theodote/Senior-Project/figs/altium.png

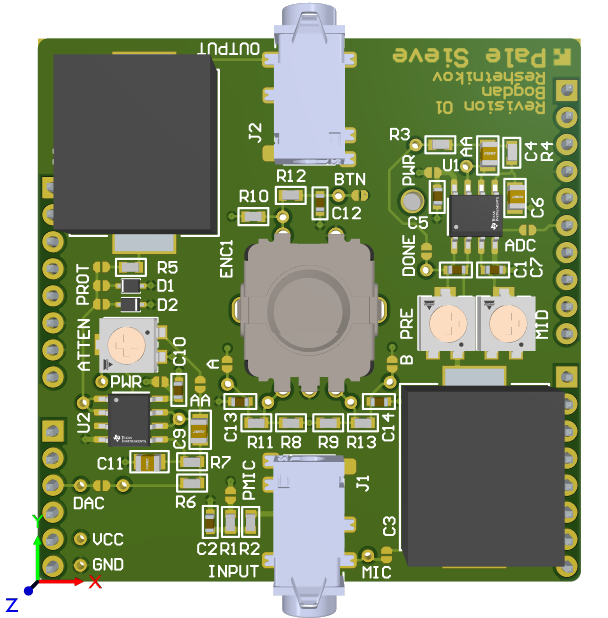
figs/altium.png
