theodote/Senior-Project/figs/audio-pipeline.png

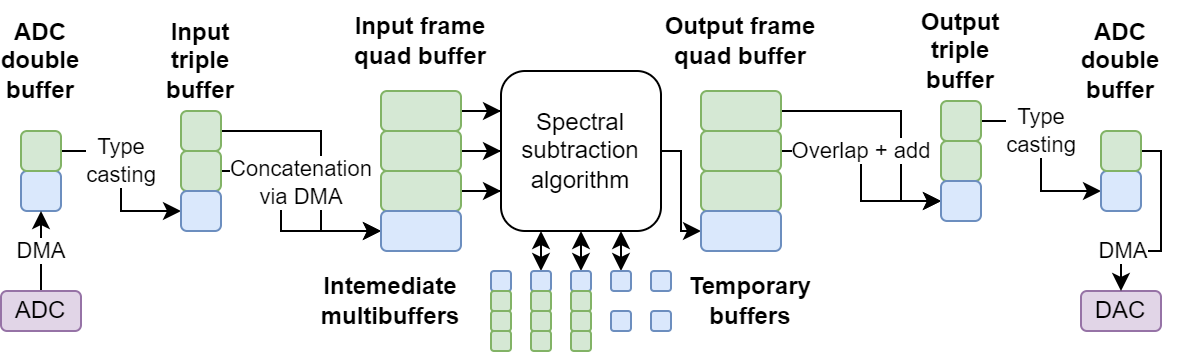
figs/audio-pipeline.png
