theodote/Senior-Project/figs/backside.jpg

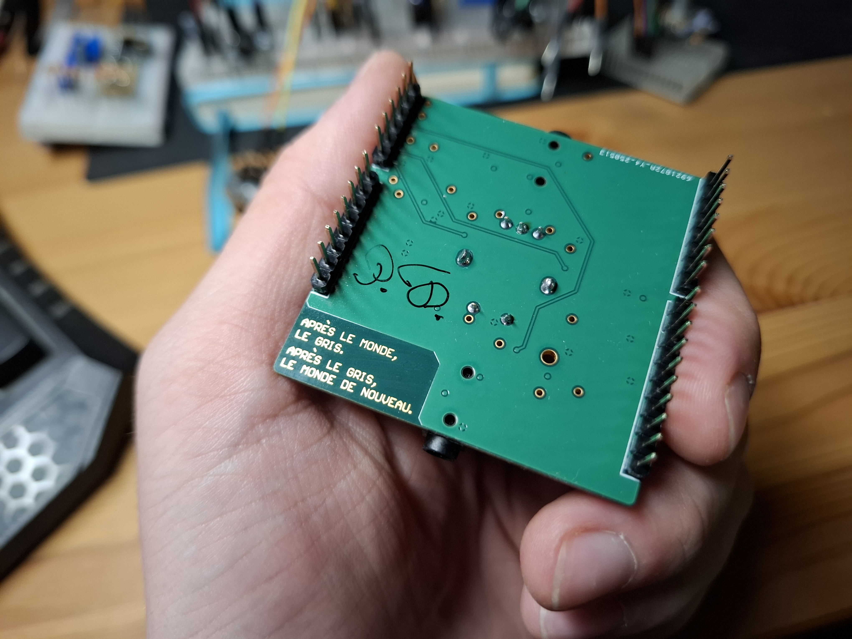
figs/backside.jpg
