theodote/Senior-Project/figs/board.jpg

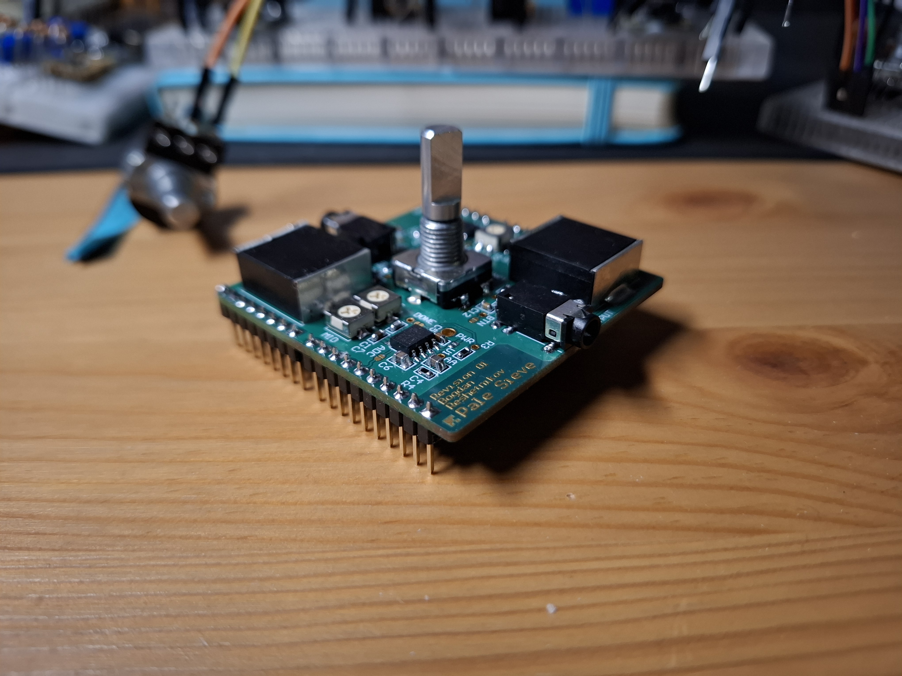
figs/board.jpg
