theodote/Senior-Project/figs/bridge.png

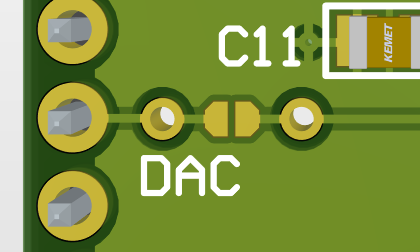
figs/bridge.png
