theodote/Senior-Project/figs/buzz-anatomy.png

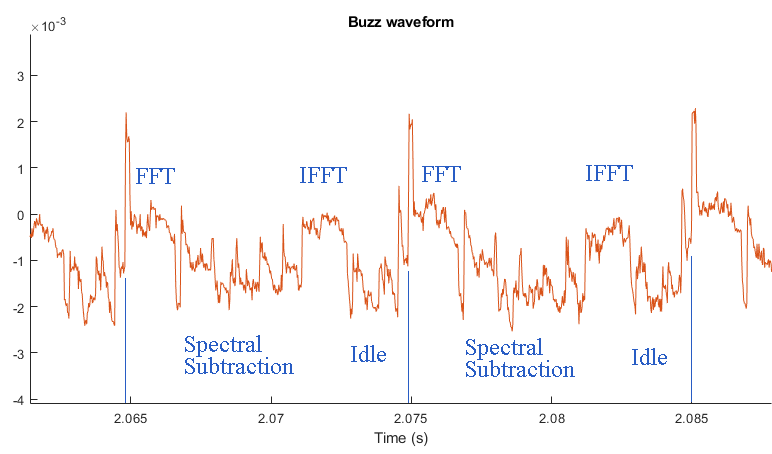
figs/buzz-anatomy.png
