theodote/Senior-Project/figs/buzz-waveform.png

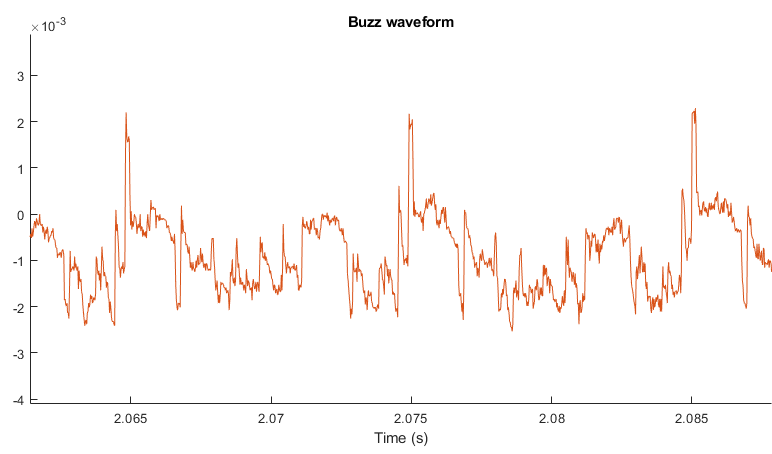
figs/buzz-waveform.png
