theodote/Senior-Project/figs/buzz.png

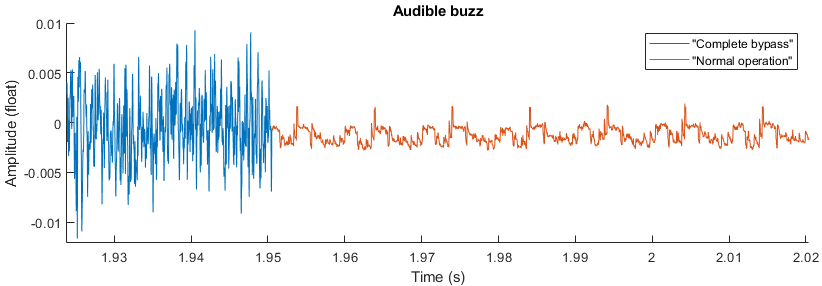
figs/buzz.png
