theodote/Senior-Project/figs/cfg/adc.png

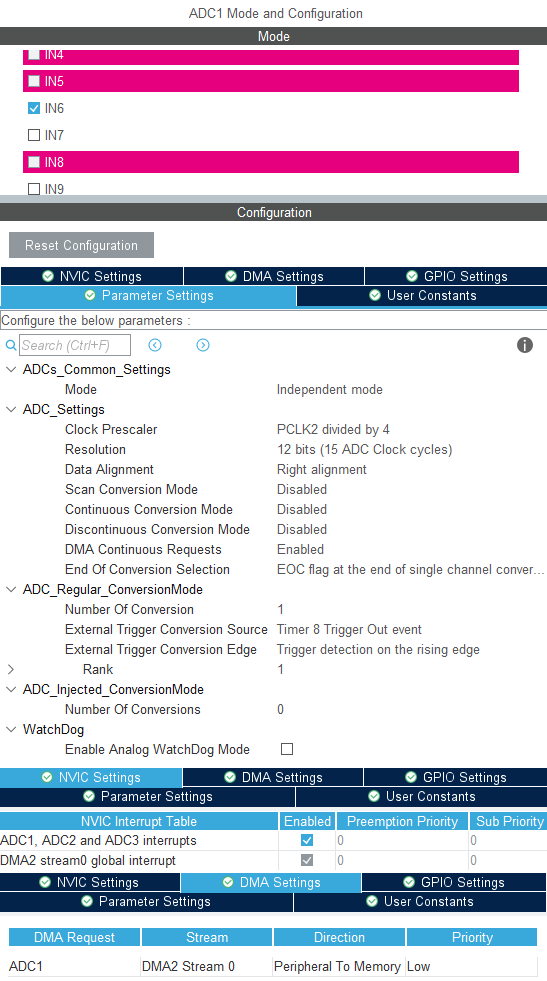
figs/cfg/adc.png
