theodote/Senior-Project/figs/cfg/clock.png

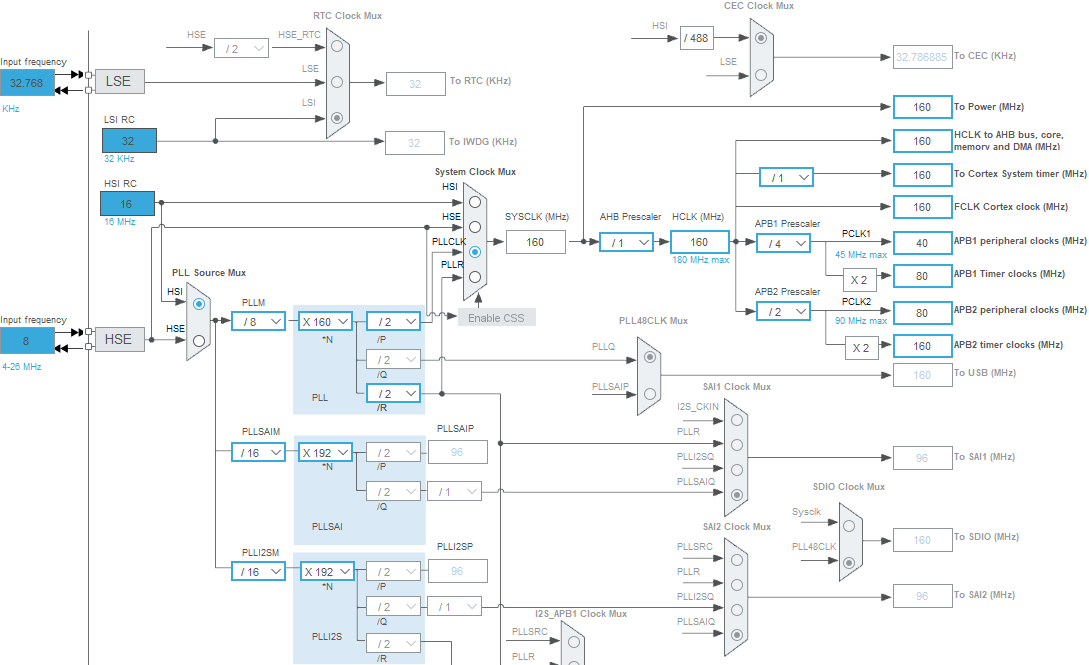
figs/cfg/clock.png
