theodote/Senior-Project/figs/cfg/dac.png

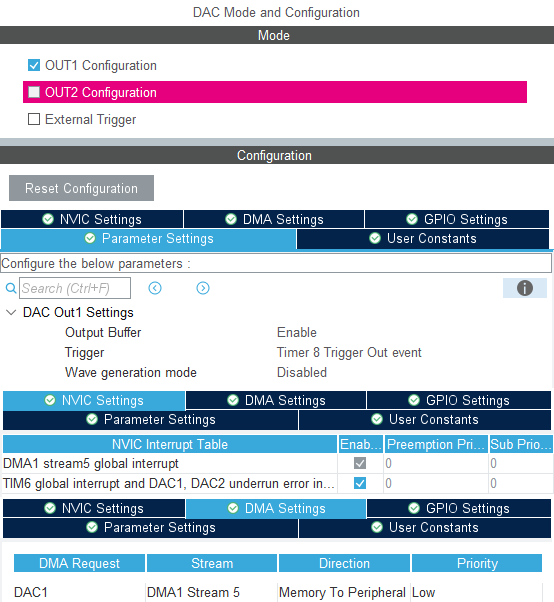
figs/cfg/dac.png
