theodote/Senior-Project/figs/cfg/dma.png

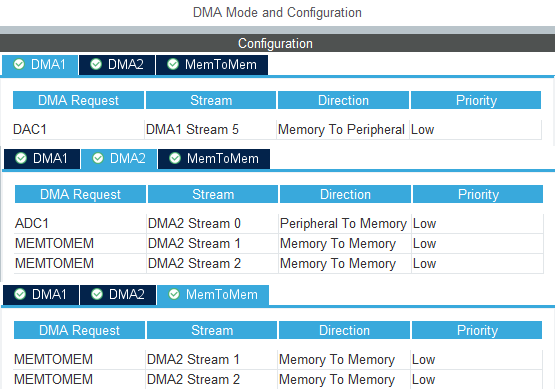
figs/cfg/dma.png
