theodote/Senior-Project/figs/cfg/gpio.png

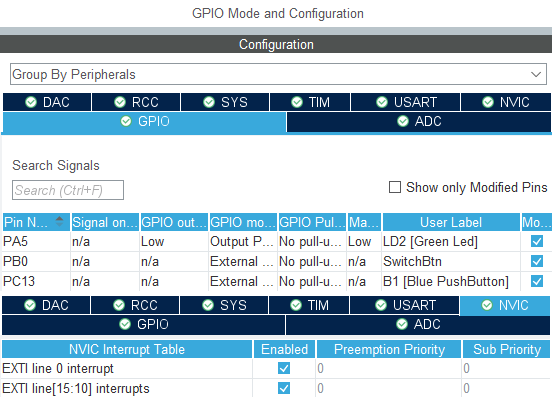
figs/cfg/gpio.png
