theodote/Senior-Project/figs/cfg/nvic.png

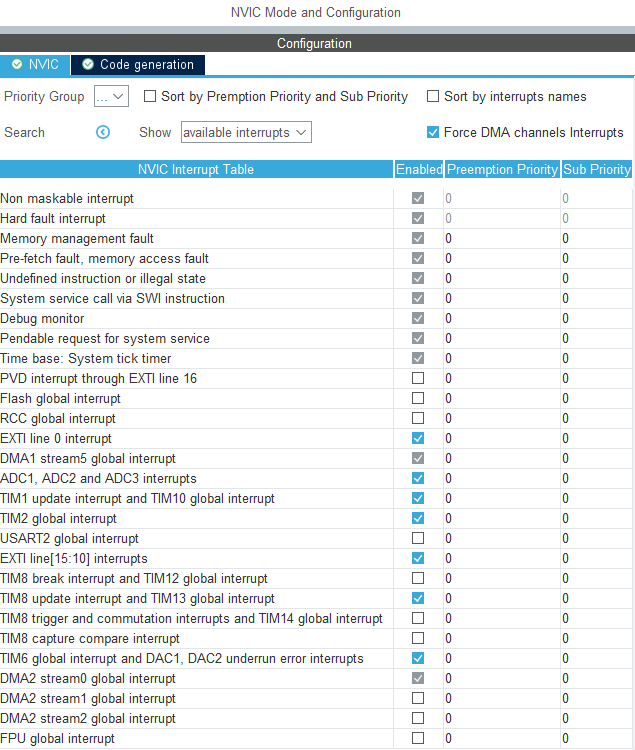
figs/cfg/nvic.png
