theodote/Senior-Project/figs/cfg/pinout.png

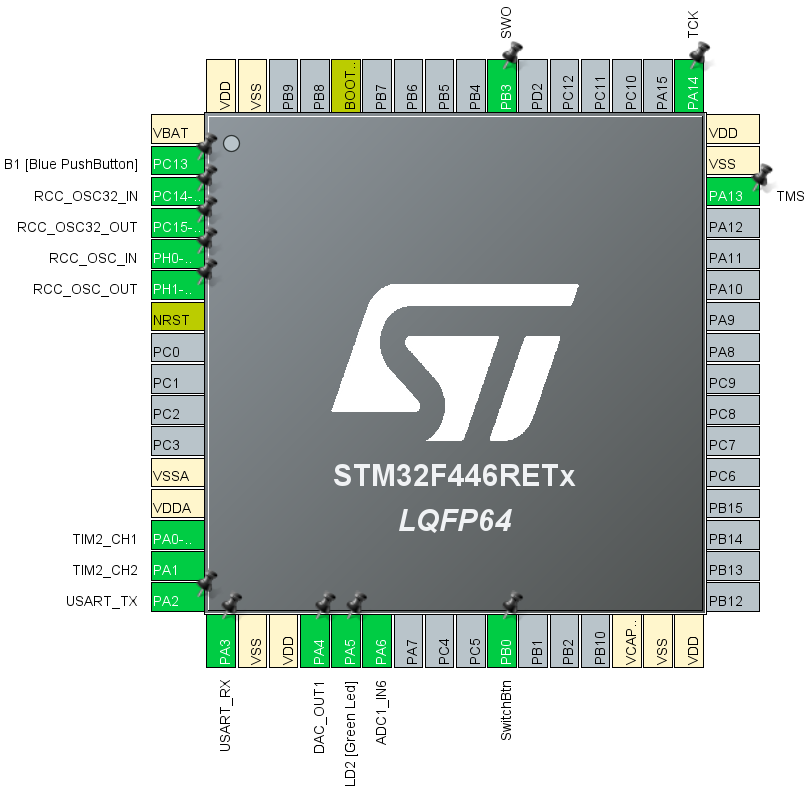
figs/cfg/pinout.png
