theodote/Senior-Project/figs/cfg/rcc.png

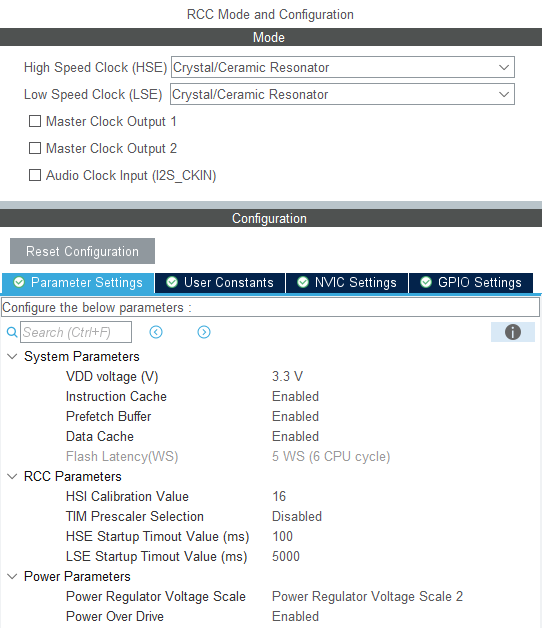
figs/cfg/rcc.png
