theodote/Senior-Project/figs/cfg/tim2.png

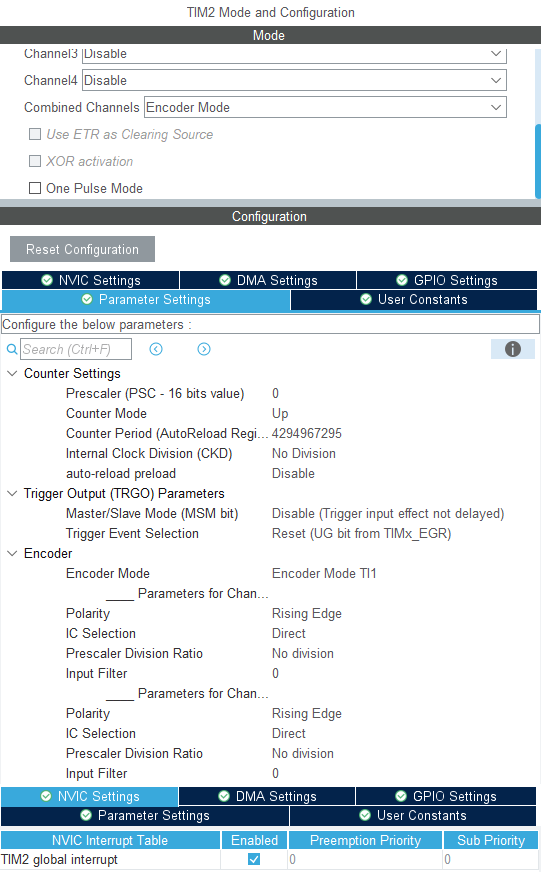
figs/cfg/tim2.png
