theodote/Senior-Project/figs/cfg/tim8.png

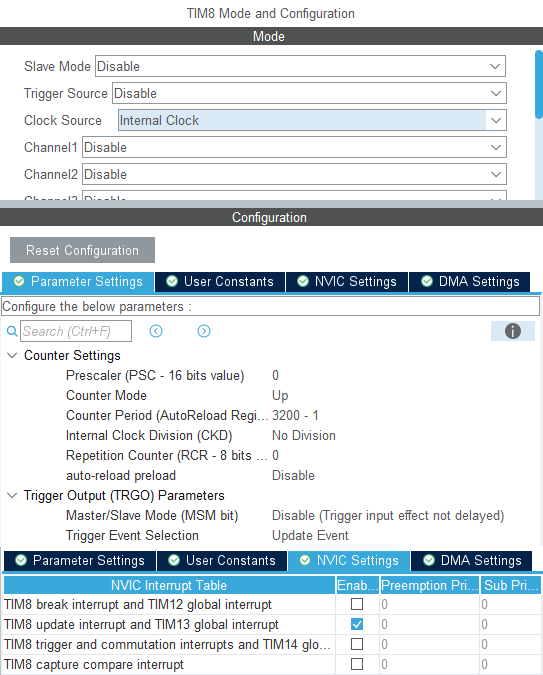
figs/cfg/tim8.png
