theodote/Senior-Project/figs/cfg/tim10.png

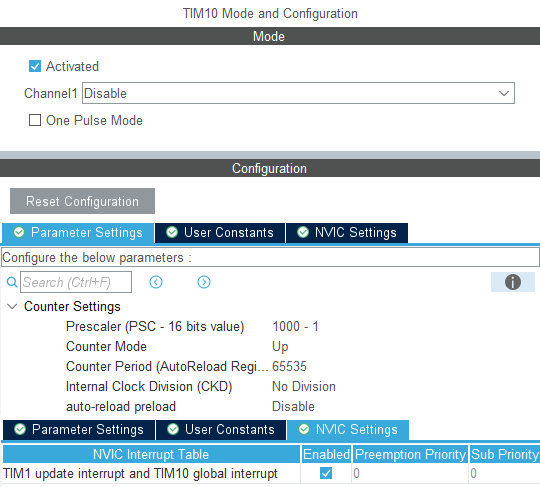
figs/cfg/tim10.png
