theodote/Senior-Project/figs/dfrobot.png

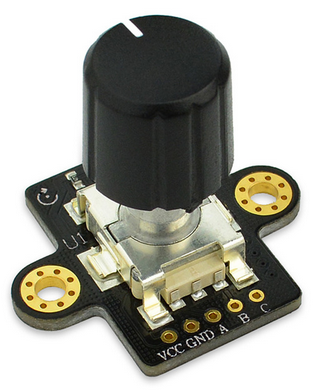
figs/dfrobot.png
