theodote/Senior-Project/figs/diodes.png

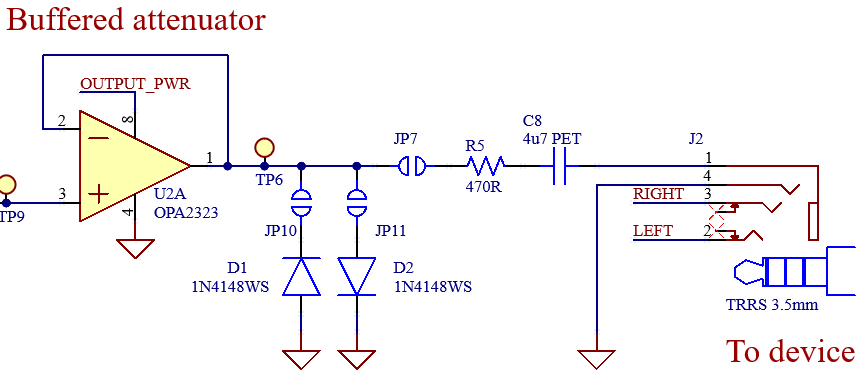
figs/diodes.png
