theodote/Senior-Project/figs/double-buffers.png

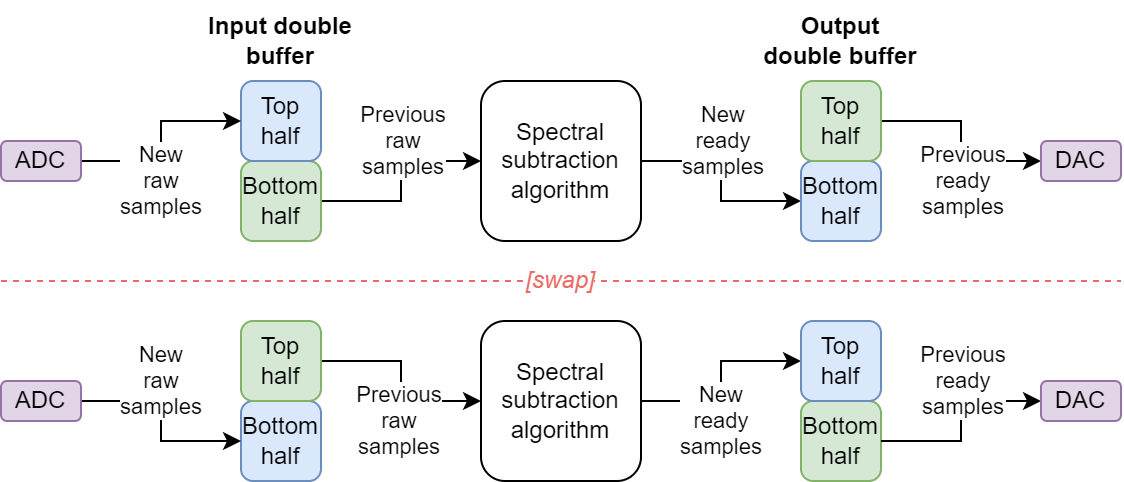
figs/double-buffers.png
