theodote/Senior-Project/figs/encoder-cct.png

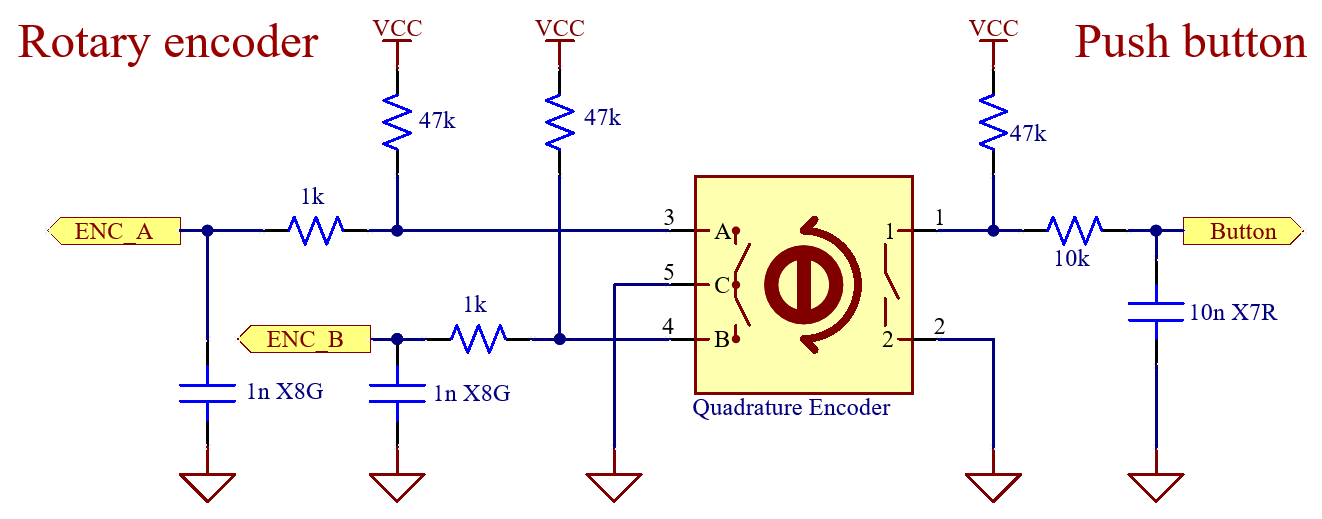
figs/encoder-cct.png
