theodote/Senior-Project/figs/fft-time.png

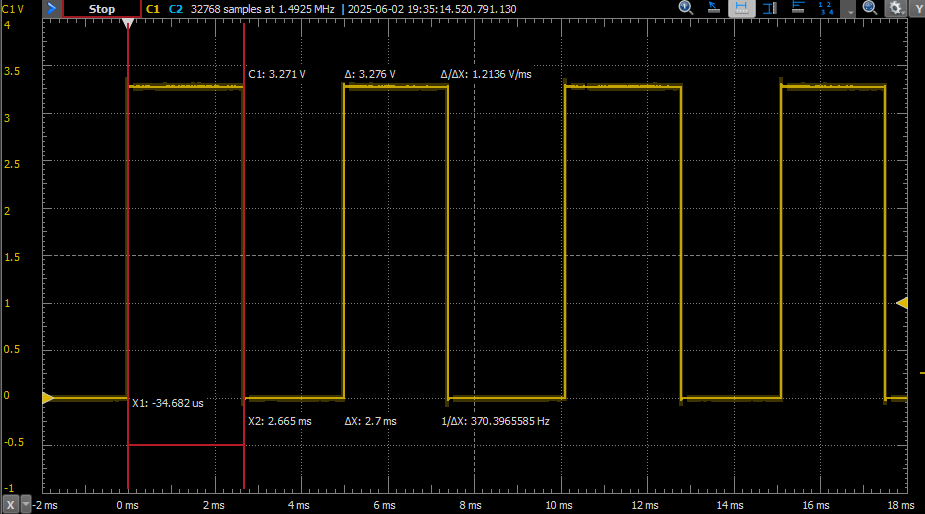
figs/fft-time.png
