theodote/Senior-Project/figs/final-demo.png

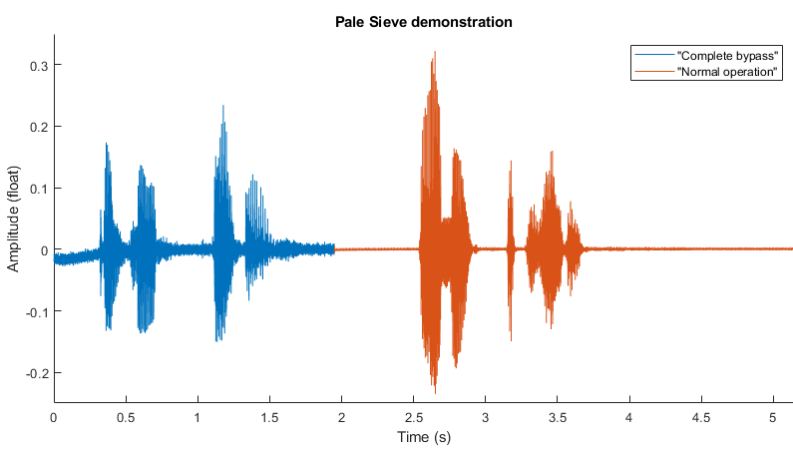
figs/final-demo.png
