theodote/Senior-Project/figs/final-noiseless.png

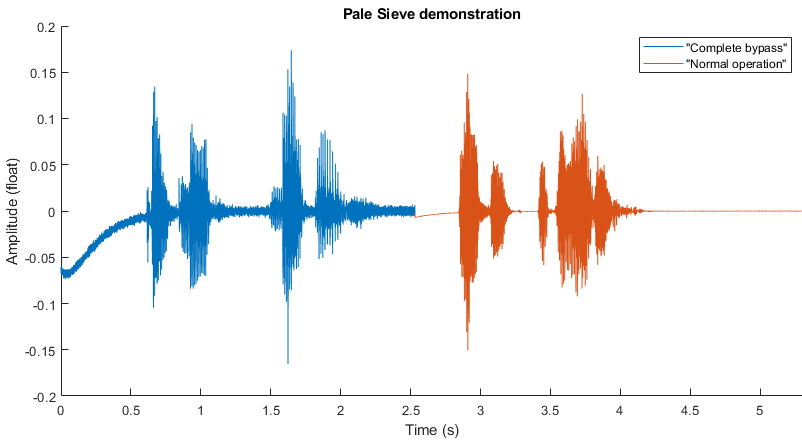
figs/final-noiseless.png
