theodote/Senior-Project/figs/ground-loop.png

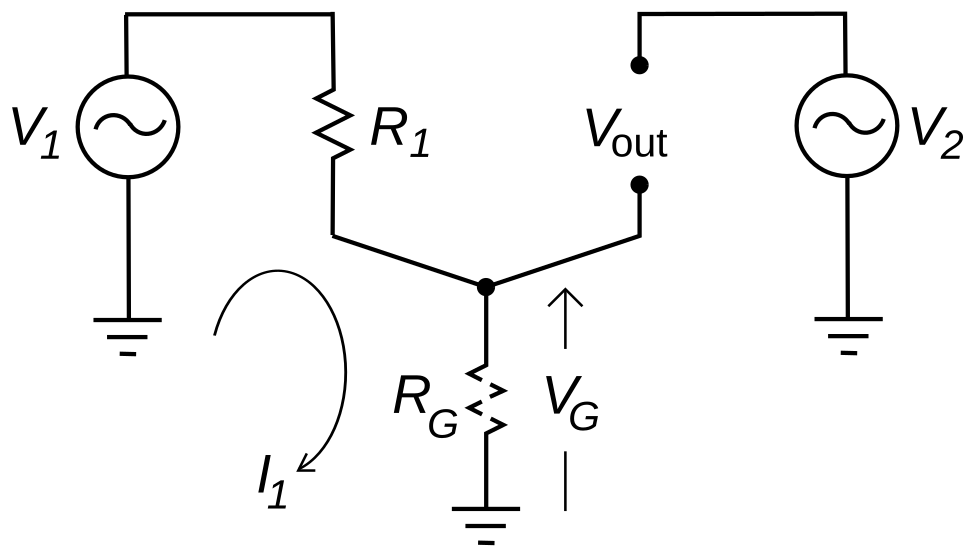
figs/ground-loop.png
