theodote/Senior-Project/figs/high-level-design.png

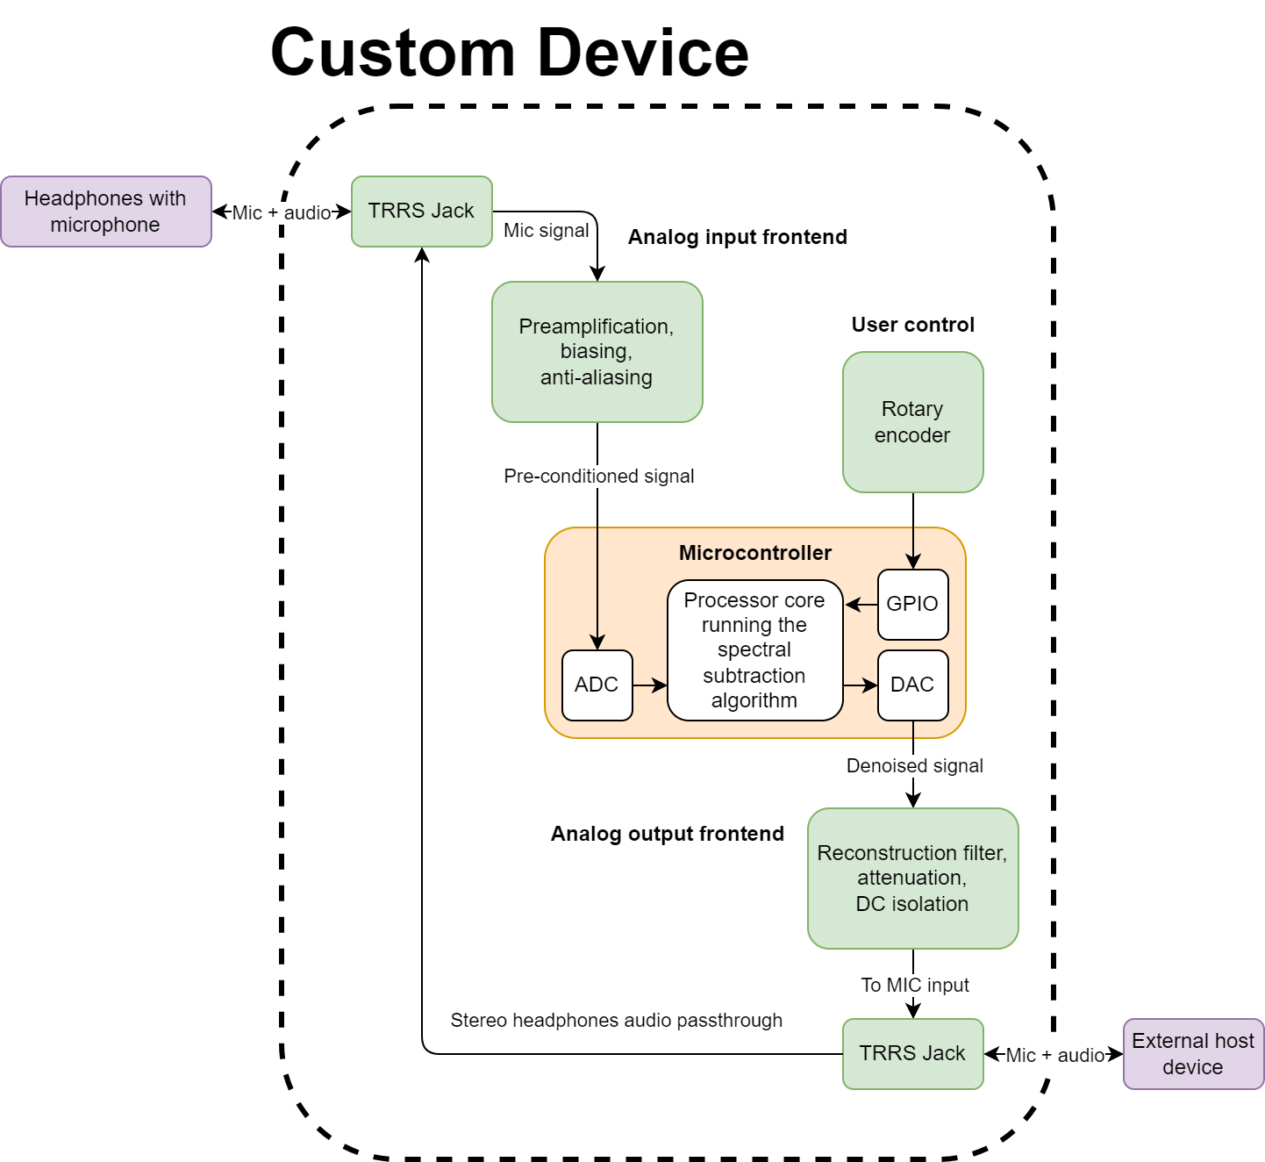
figs/high-level-design.png
