theodote/Senior-Project/figs/indata-compare.png

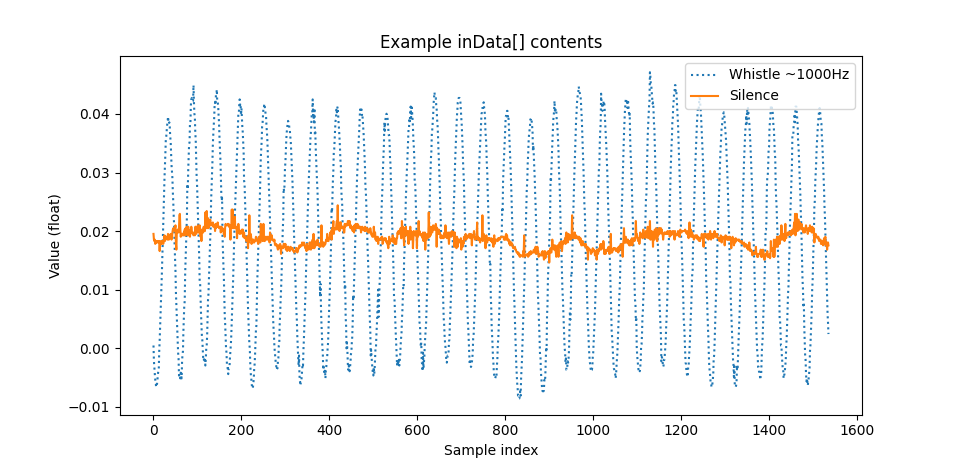
figs/indata-compare.png
