theodote/Senior-Project/figs/indata-empty.png

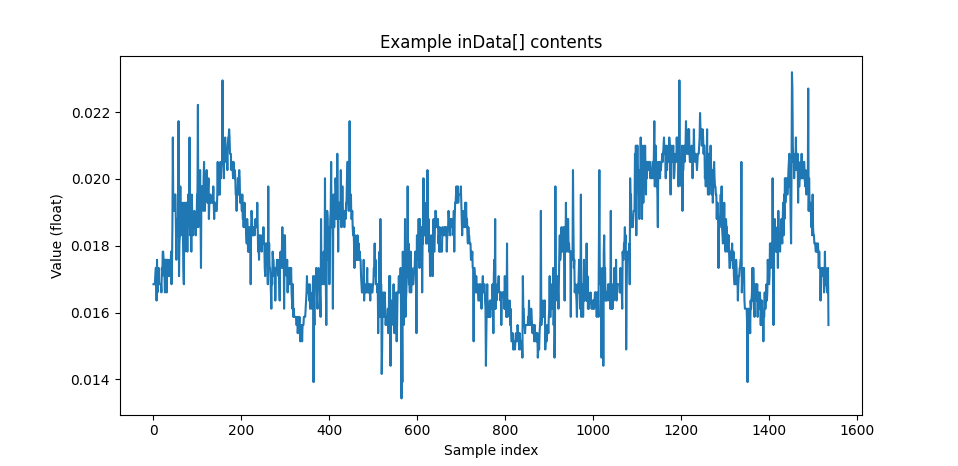
figs/indata-empty.png
