theodote/Senior-Project/figs/indata.png

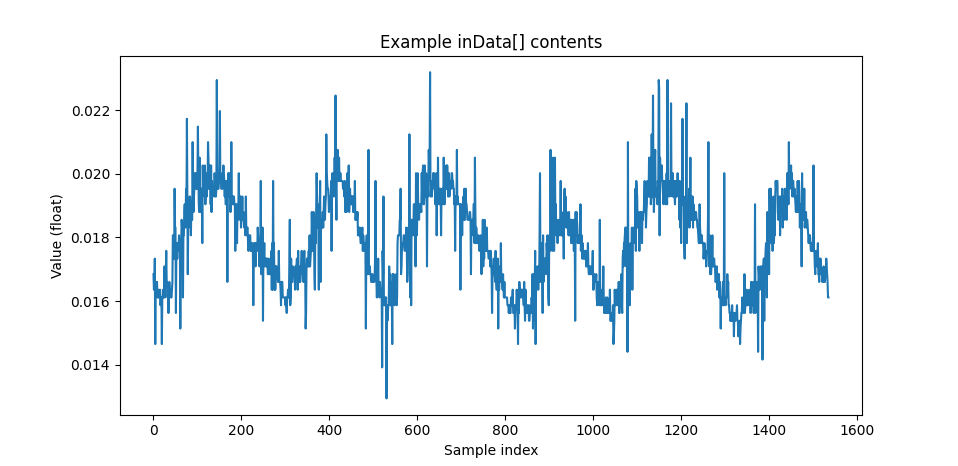
figs/indata.png
