theodote/Senior-Project/figs/indicator.jpg

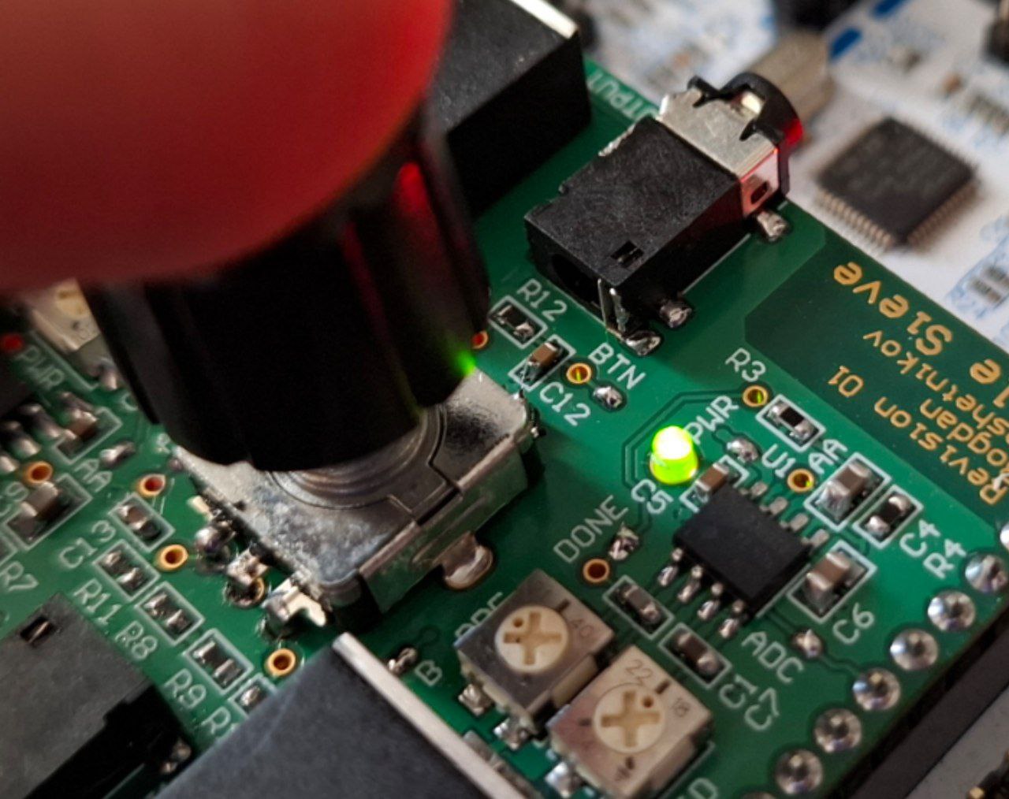
figs/indicator.jpg
