theodote/Senior-Project/figs/input-cct.png

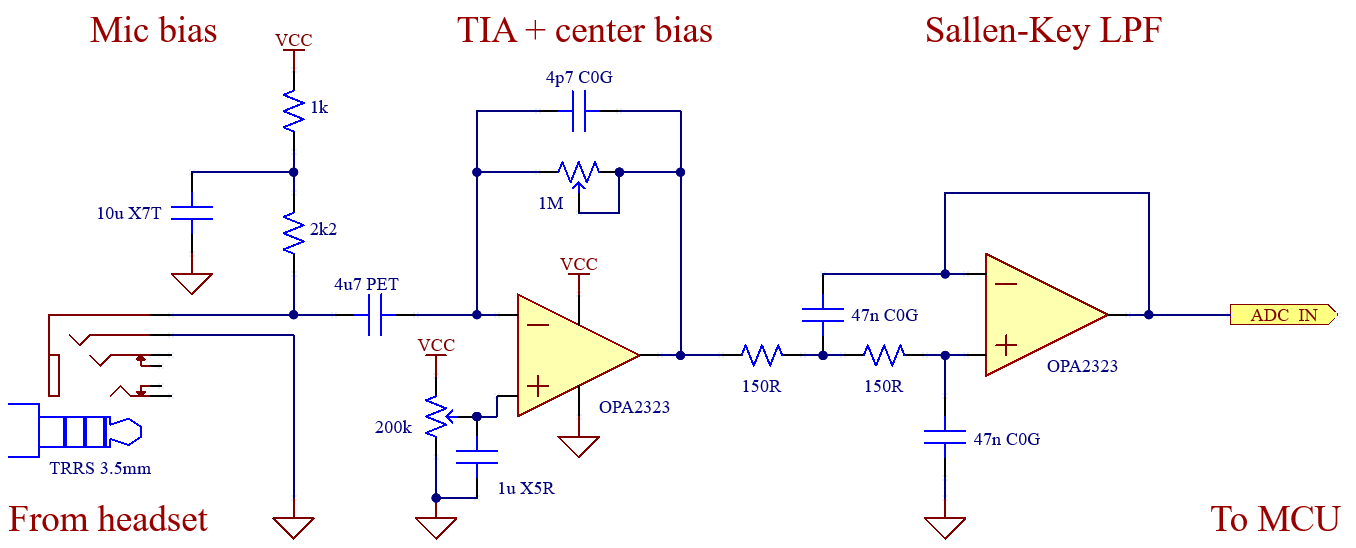
figs/input-cct.png
