theodote/Senior-Project/figs/input-frontend.png

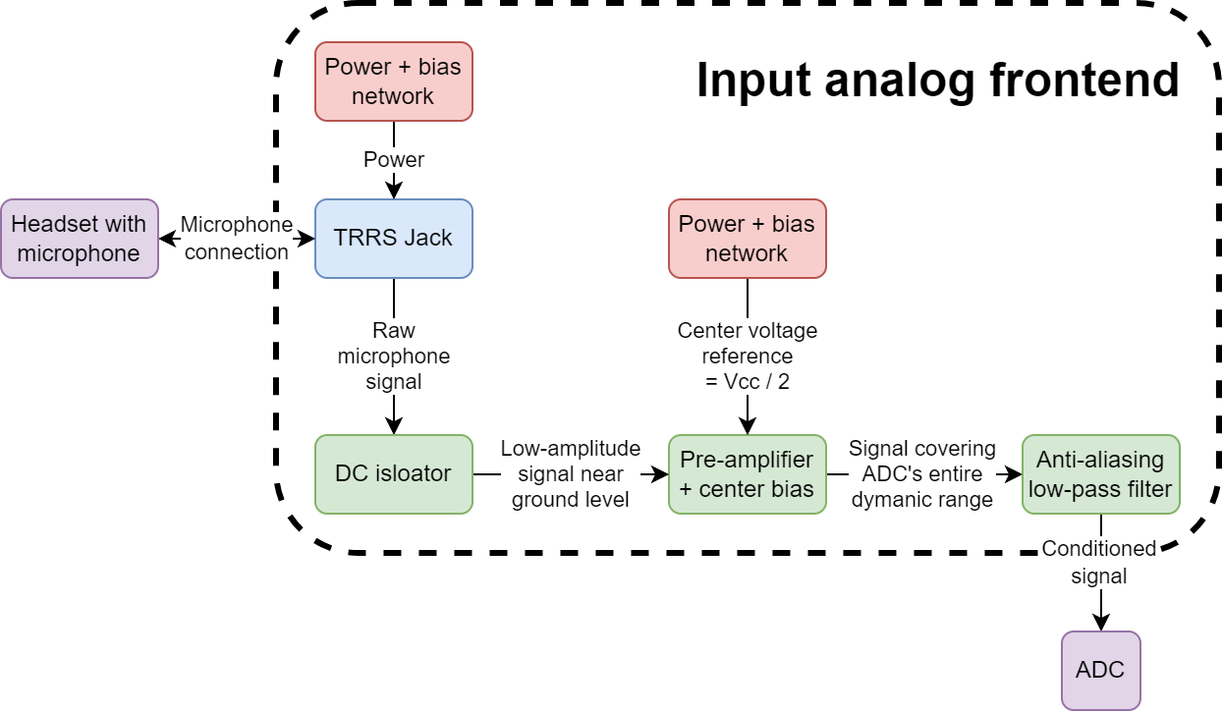
figs/input-frontend.png
