theodote/Senior-Project/figs/matlab.png

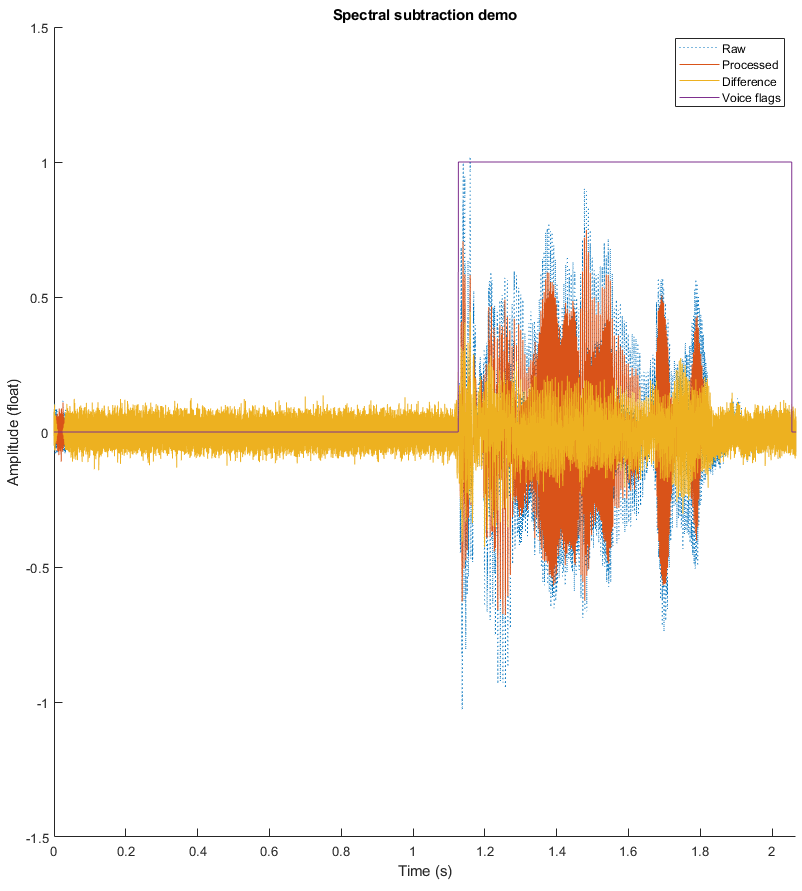
figs/matlab.png
