theodote/Senior-Project/figs/mcu-board.png

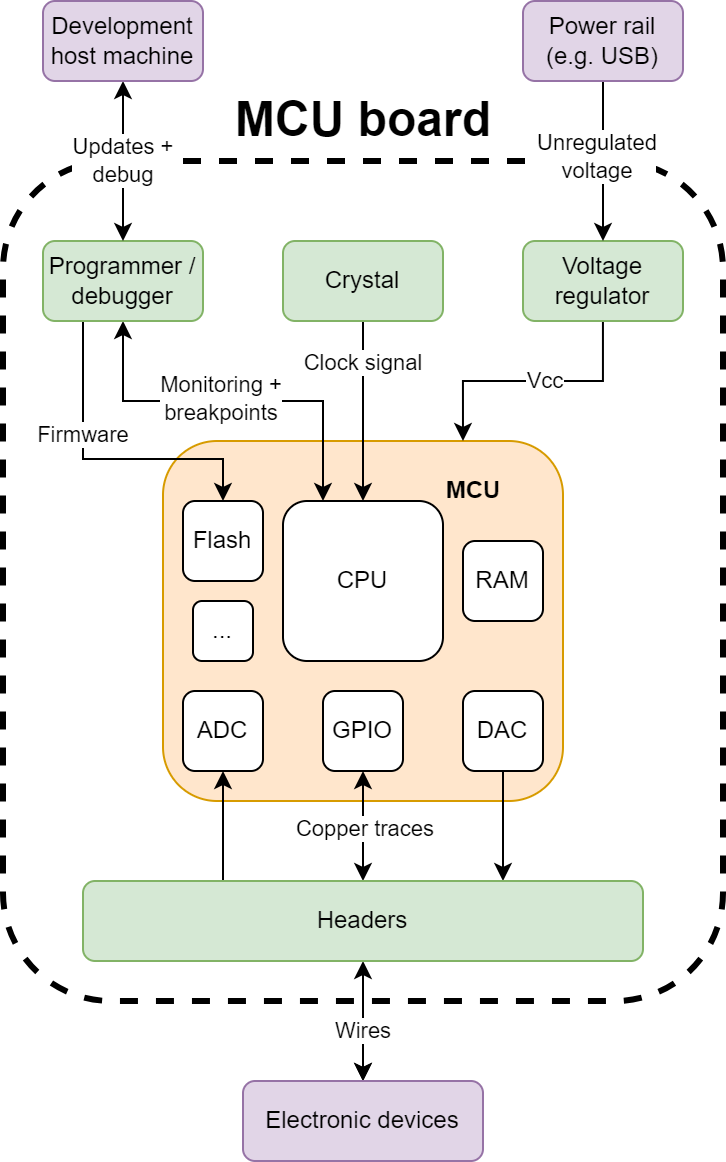
figs/mcu-board.png
