theodote/Senior-Project/figs/multibuffer.png

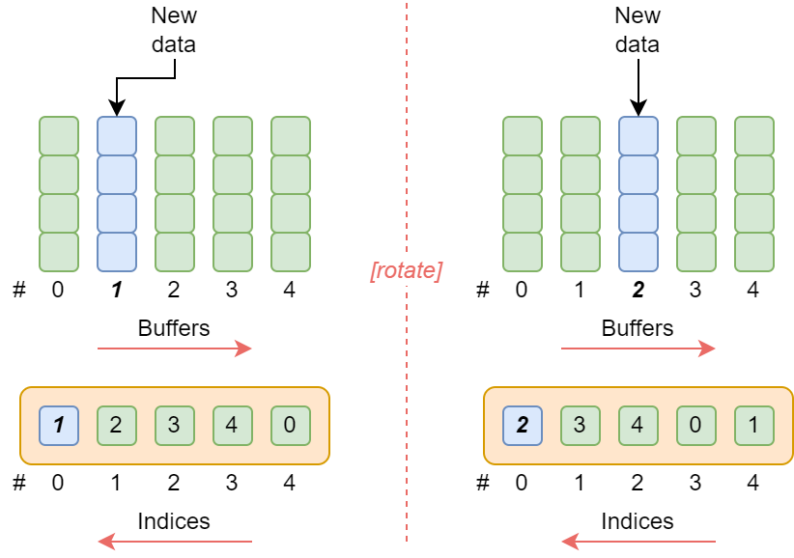
figs/multibuffer.png
