theodote/Senior-Project/figs/nucleo.png

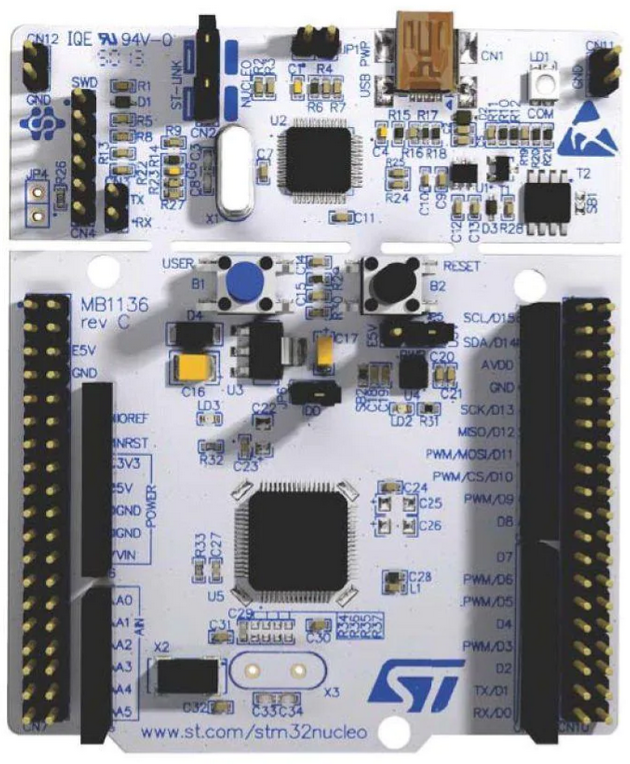
figs/nucleo.png
