theodote/Senior-Project/figs/output-cct.png

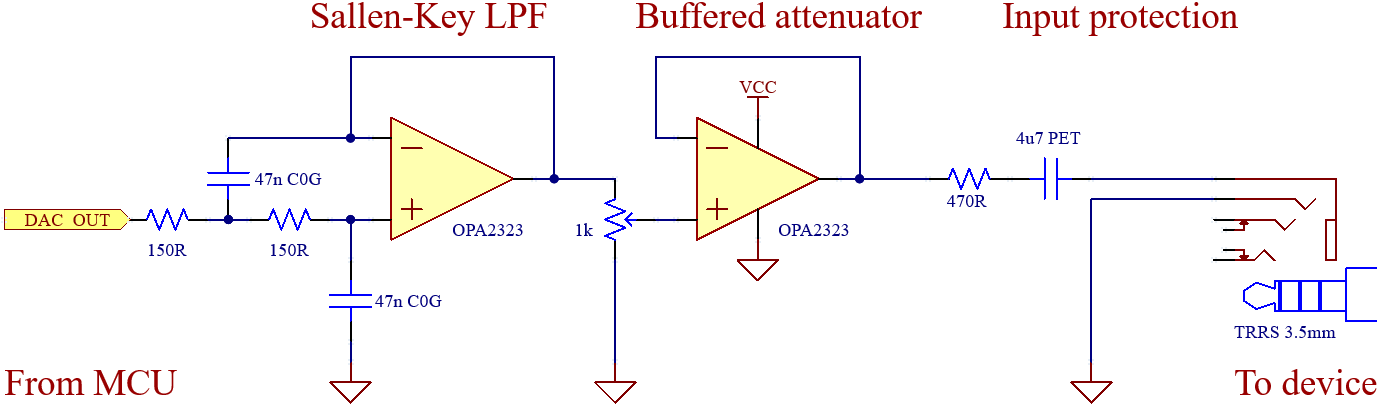
figs/output-cct.png
