theodote/Senior-Project/figs/output-frontend.png

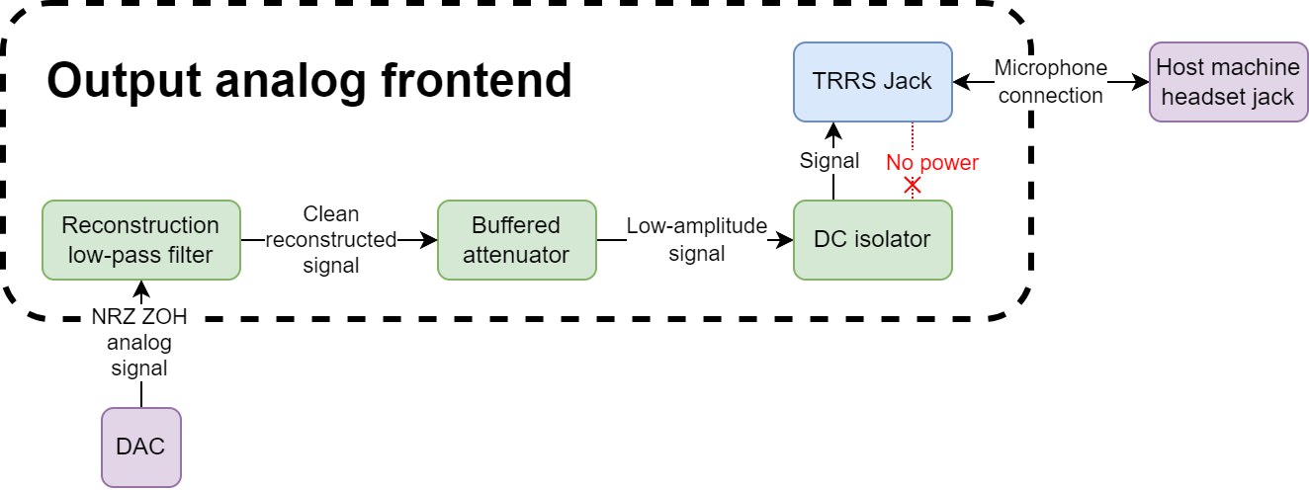
figs/output-frontend.png
