theodote/Senior-Project/figs/pcb.png

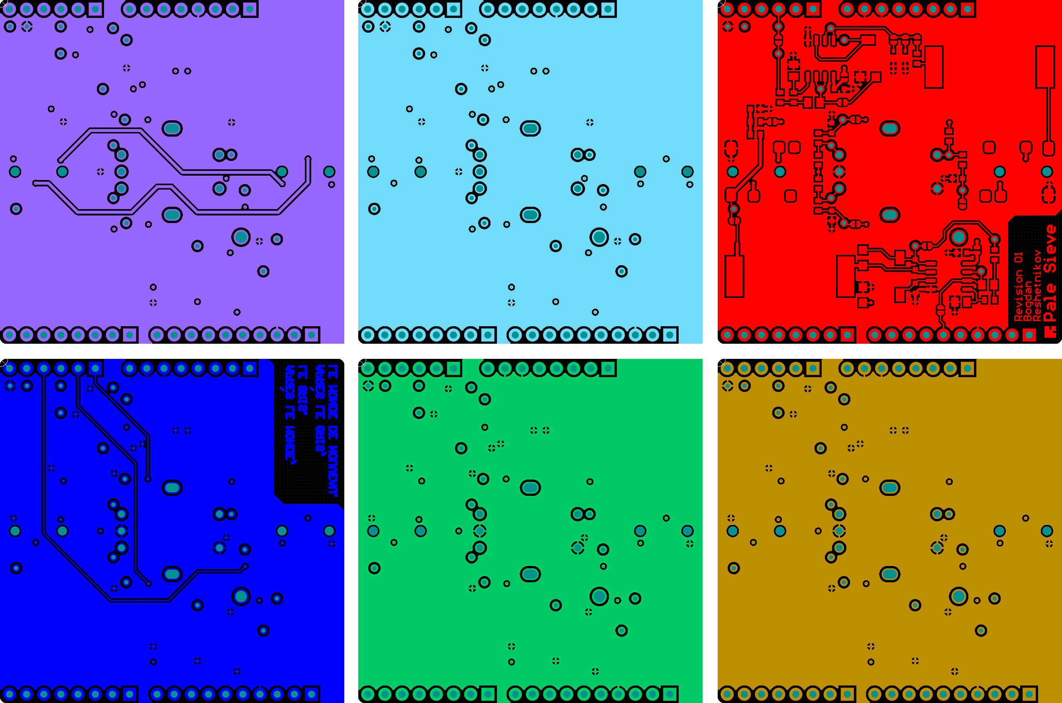
figs/pcb.png
