theodote/Senior-Project/figs/pipe.jpg

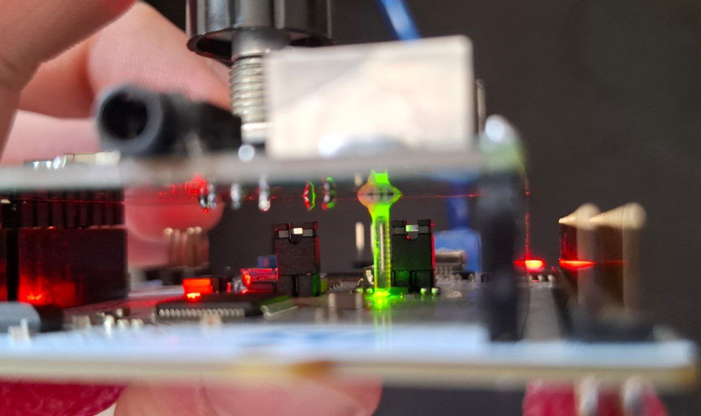
figs/pipe.jpg
