theodote/Senior-Project/figs/quadrature-encoder.png

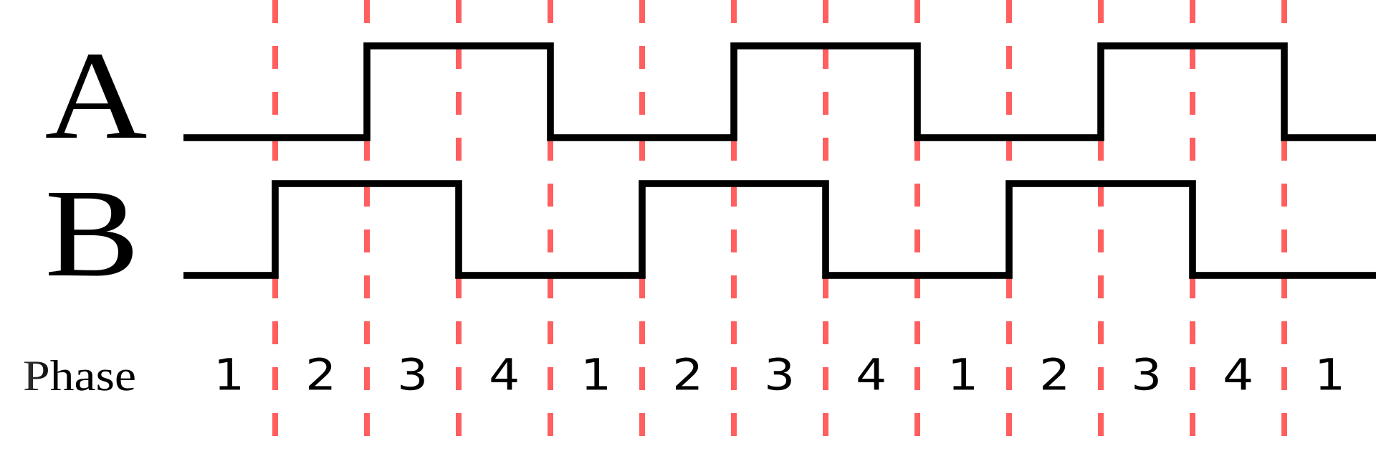
figs/quadrature-encoder.png
