theodote/Senior-Project/figs/rig.jpg

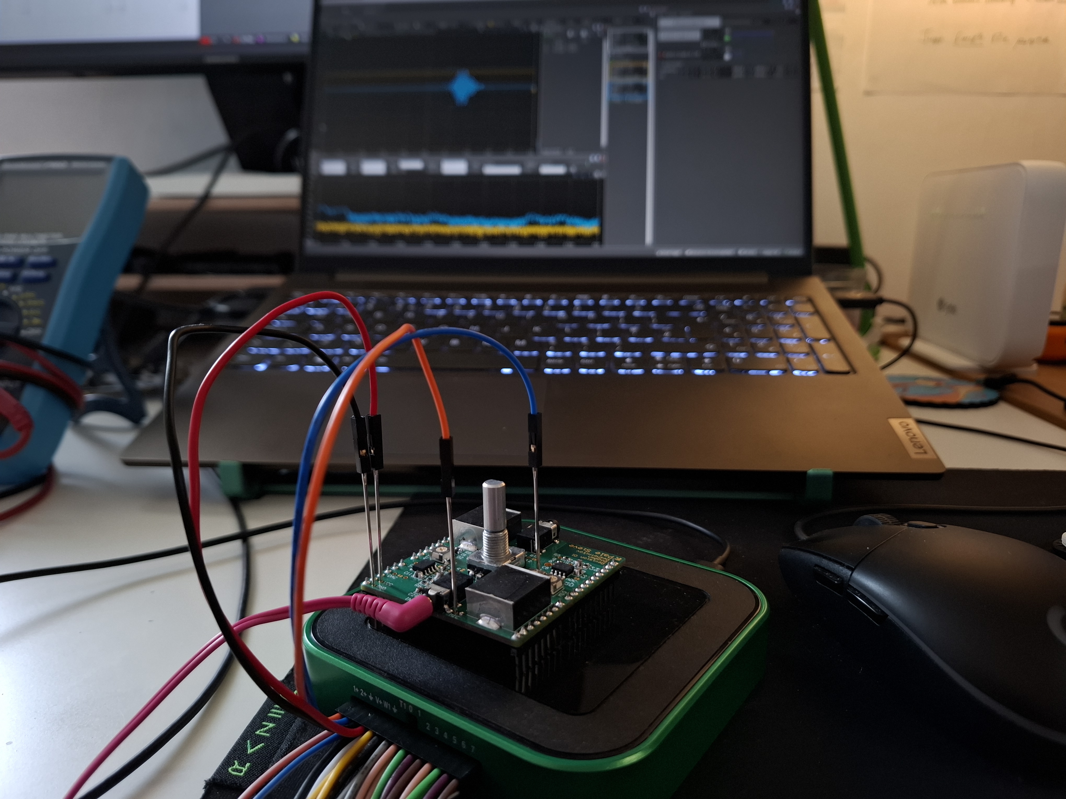
figs/rig.jpg
