theodote/Senior-Project/figs/rotary-encoder.png

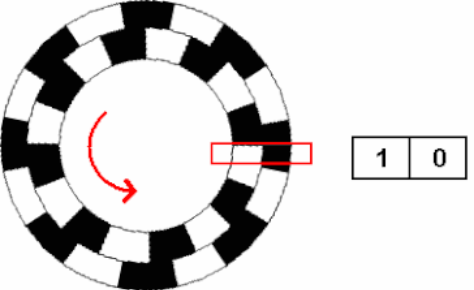
figs/rotary-encoder.png
