theodote/Senior-Project/figs/sallenkeylpf.png

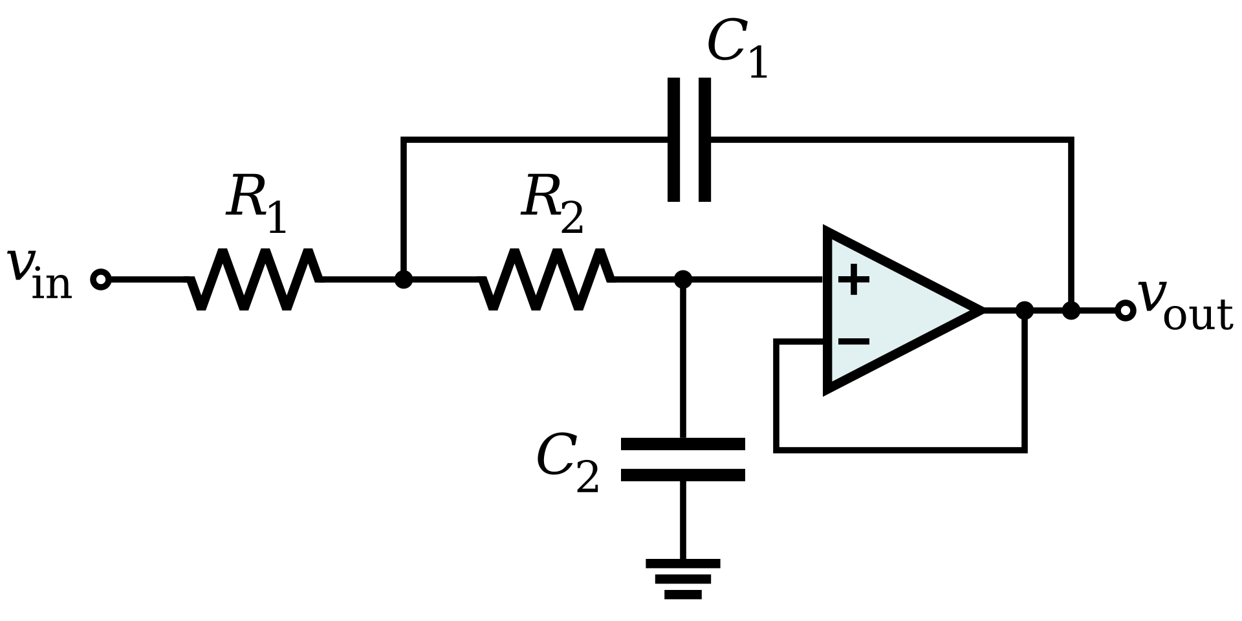
figs/sallenkeylpf.png
