theodote/Senior-Project/figs/sandwich.jpg

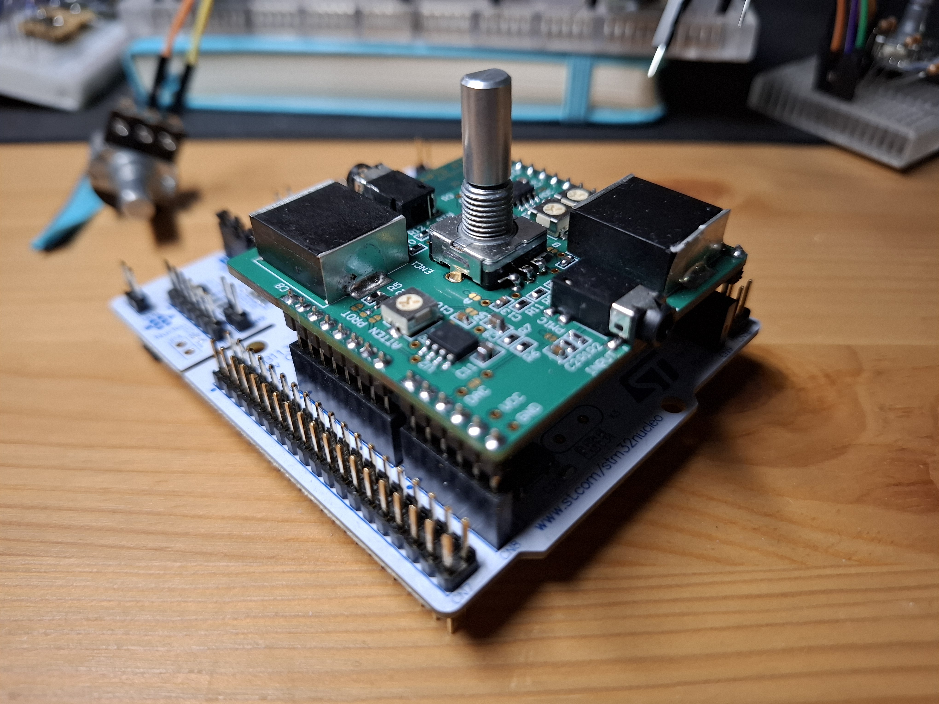
figs/sandwich.jpg
