theodote/Senior-Project/figs/sieve3d.png

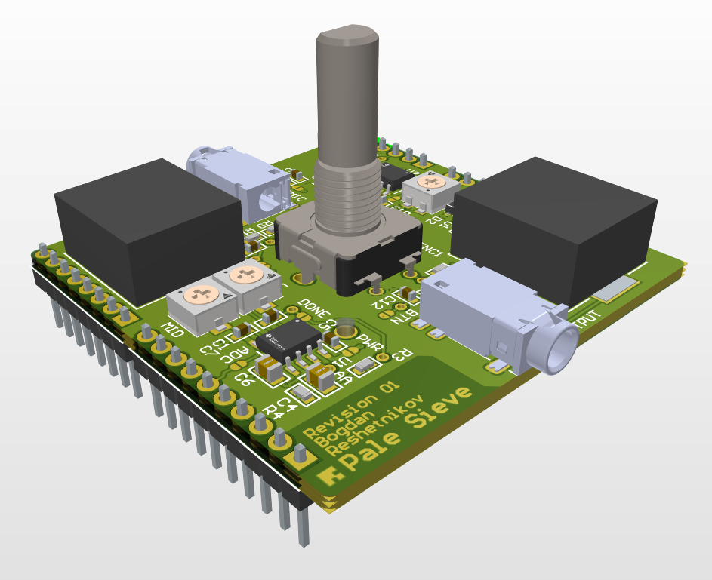
figs/sieve3d.png
