theodote/Senior-Project/figs/sparkfun.png

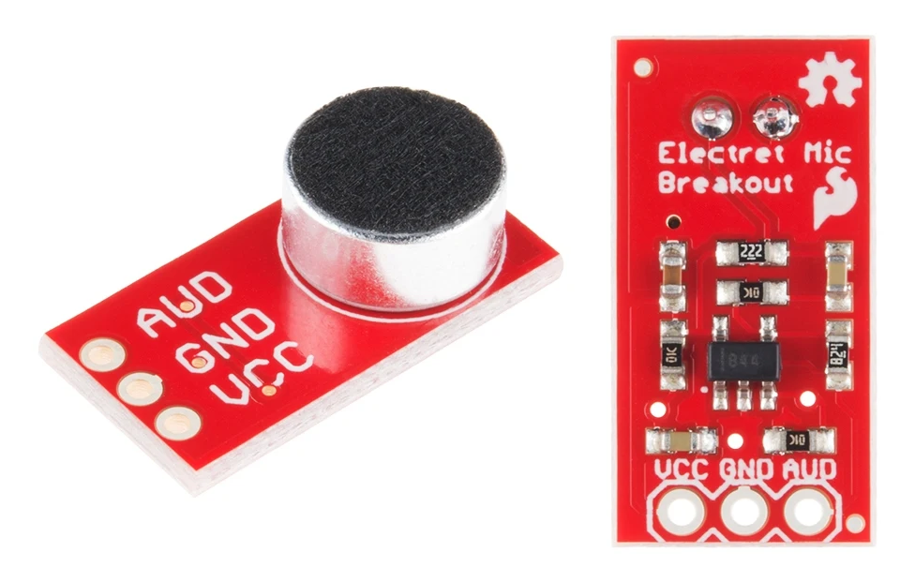
figs/sparkfun.png
