theodote/Senior-Project/figs/specsub-time.png

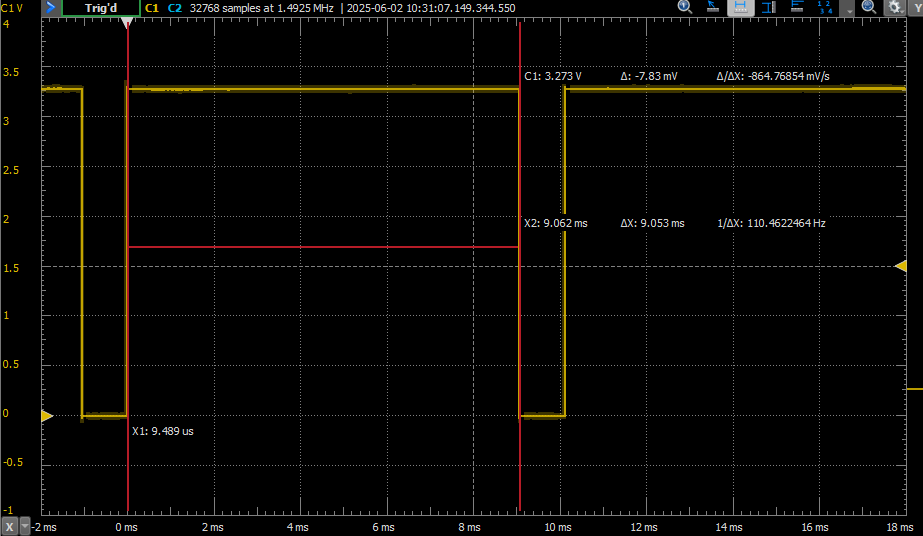
figs/specsub-time.png
