theodote/Senior-Project/figs/spectrogram.png

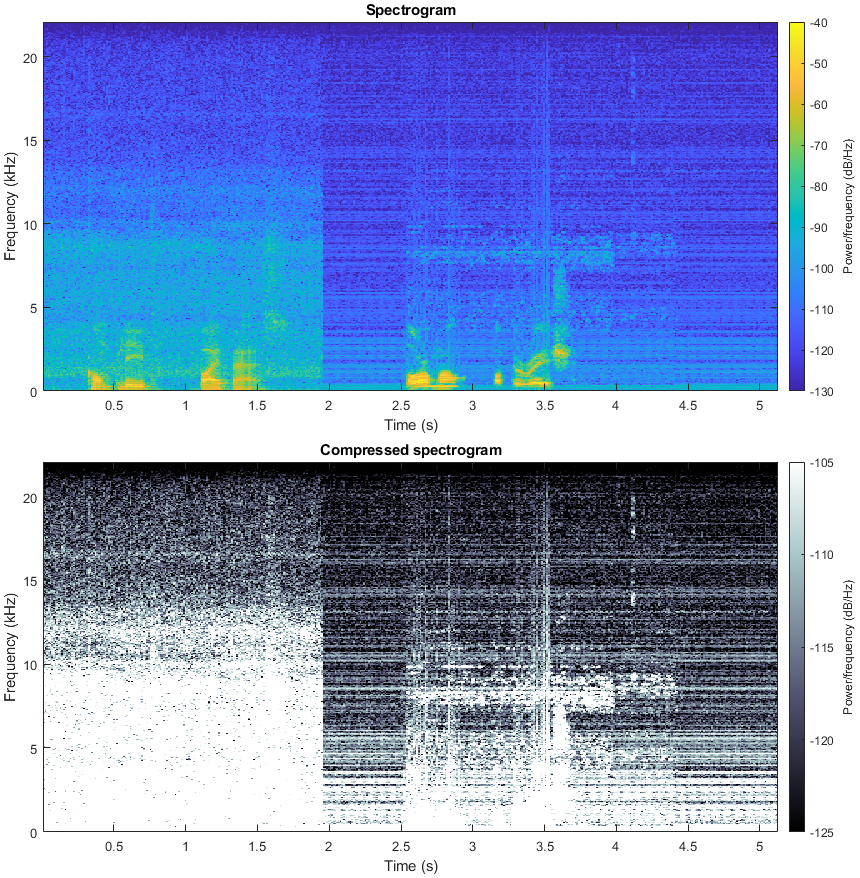
figs/spectrogram.png
