theodote/Senior-Project/figs/stm32.png

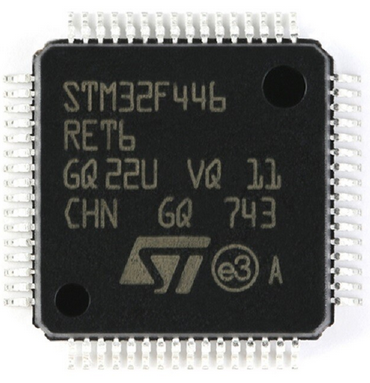
figs/stm32.png
