theodote/Senior-Project/figs/stm32promo.jpg

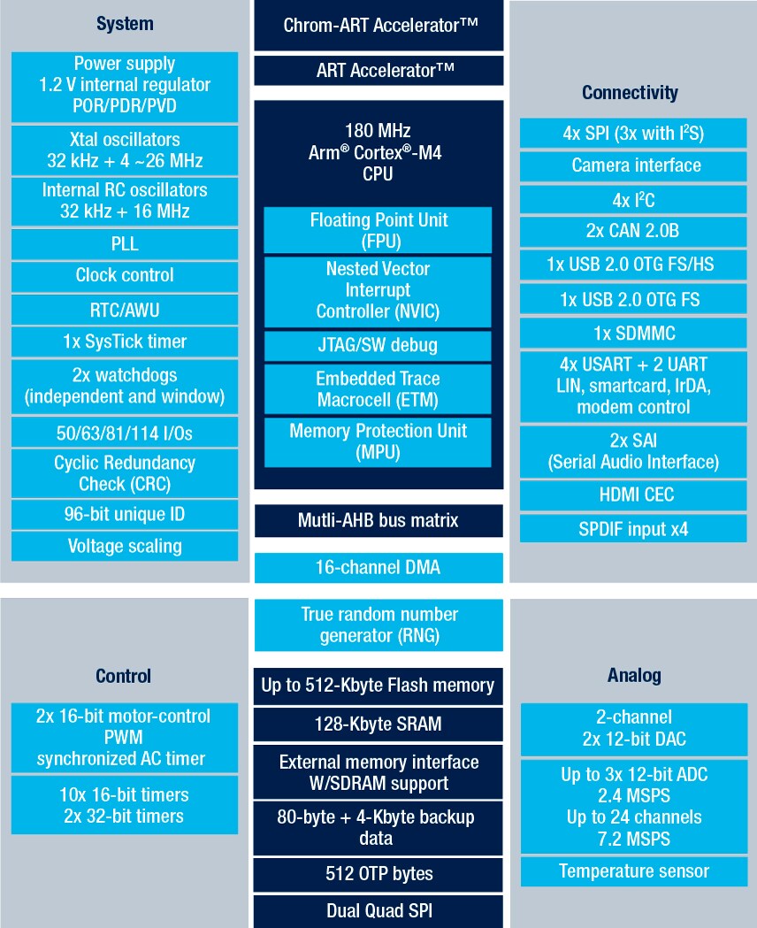
figs/stm32promo.jpg
