theodote/Senior-Project/figs/top-bottom.png

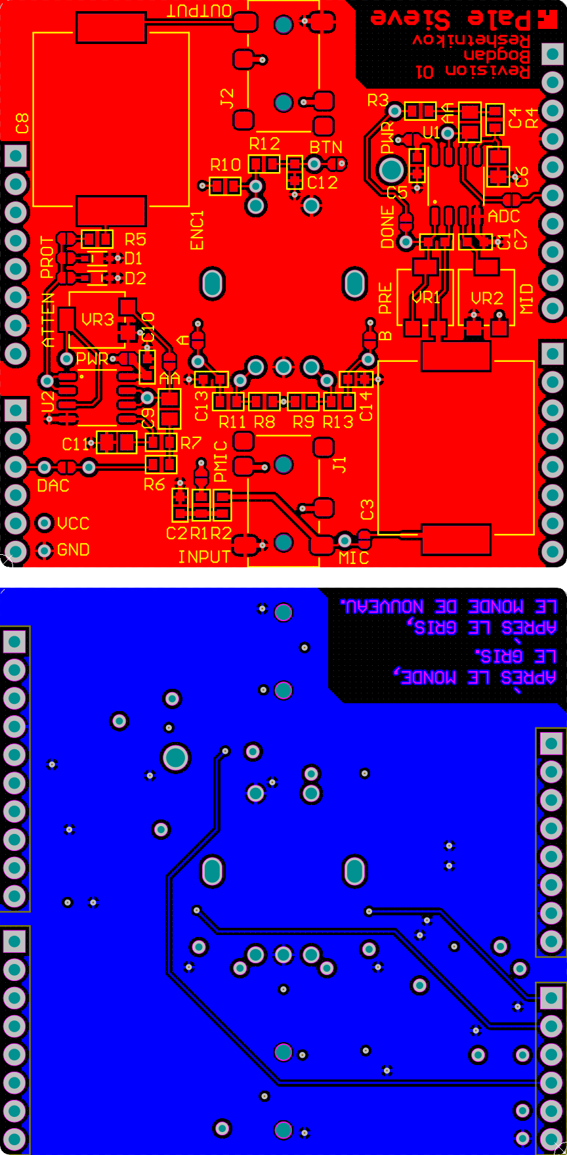
figs/top-bottom.png
