theodote/Senior-Project/figs/top.png

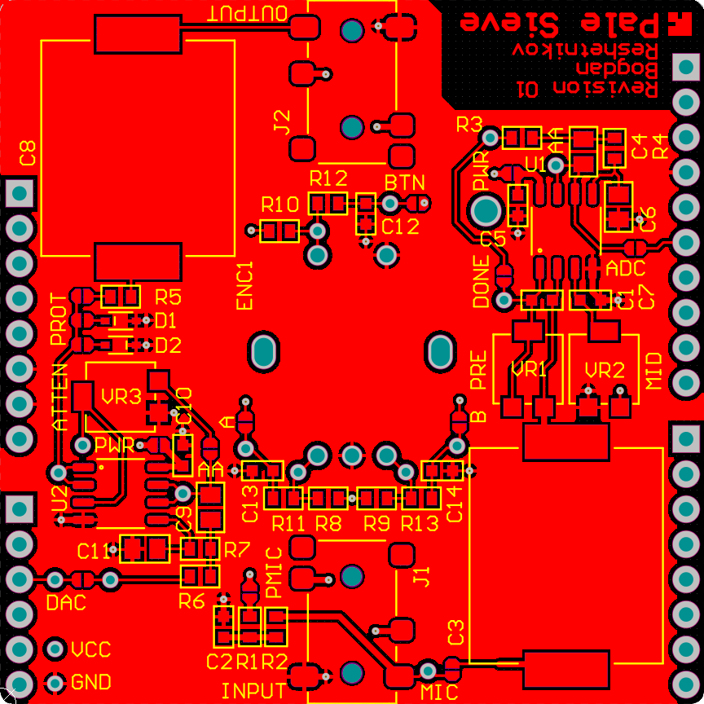
figs/top.png
