theodote/Senior-Project/figs/whiskers.jpg

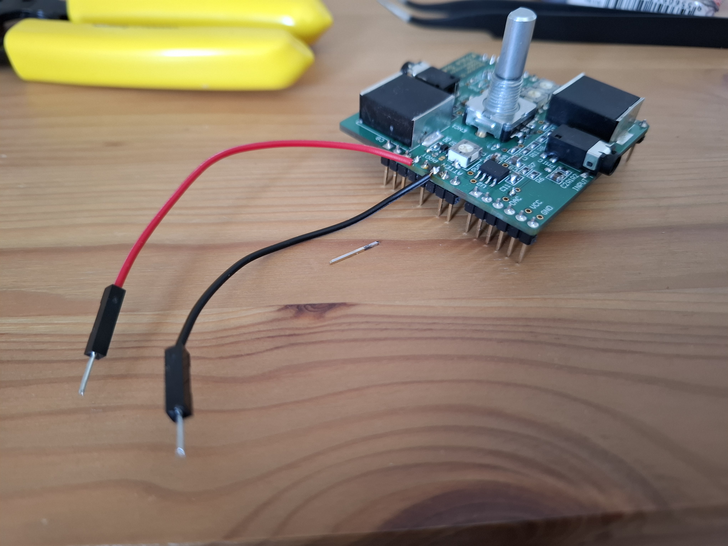
figs/whiskers.jpg
