theodote/Senior-Project/figs/Zeroorderhold.signal.svg.png

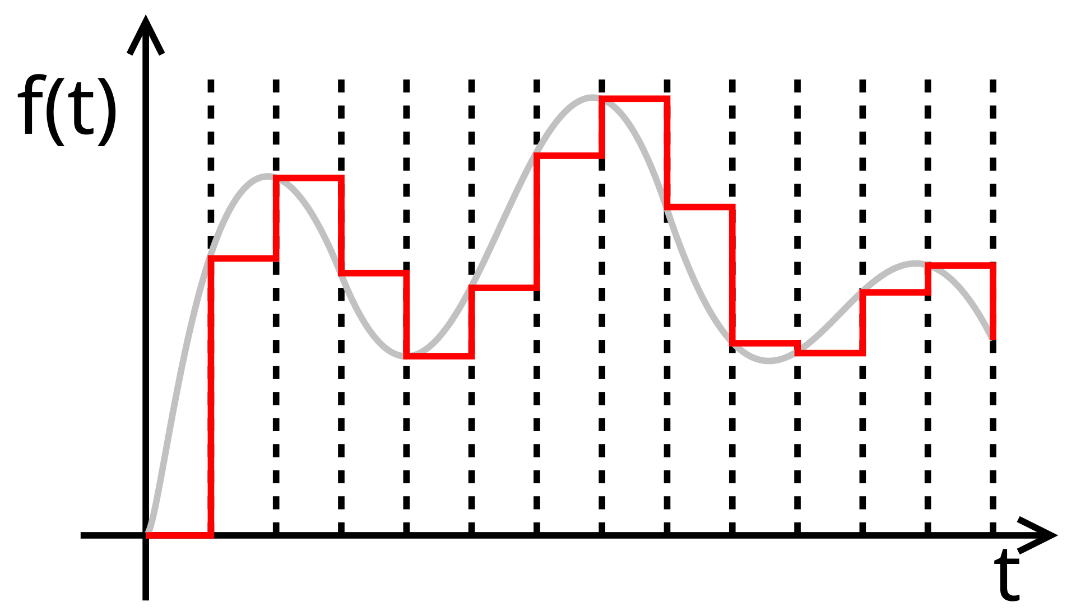
figs/Zeroorderhold.signal.svg.png
