theodote/Senior-Project/misc/alias.gif

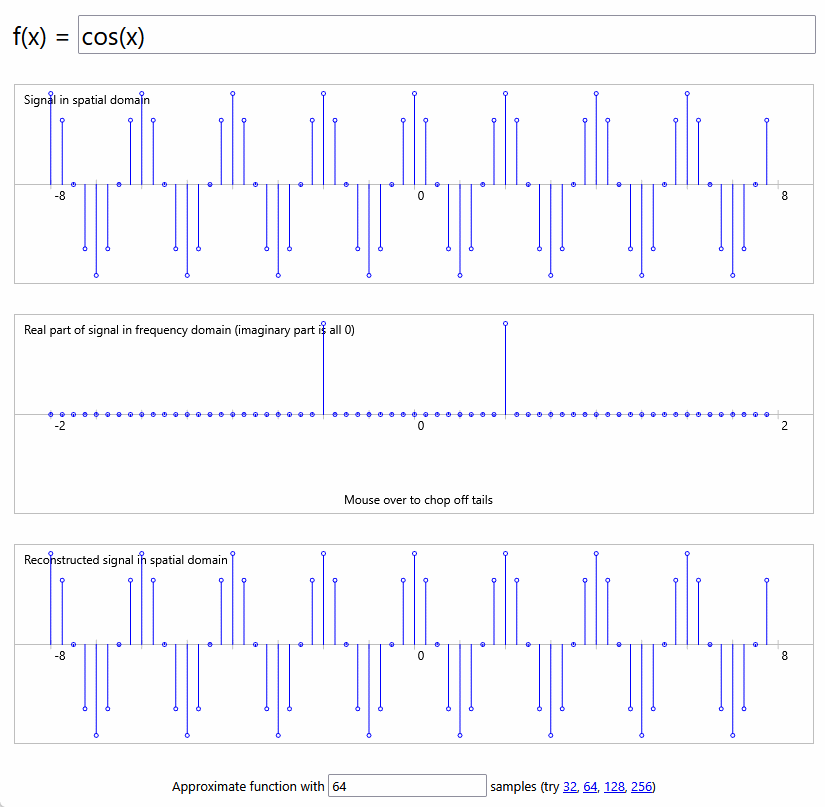
misc/alias.gif
