theodote/Senior-Project/misc/dft.gif

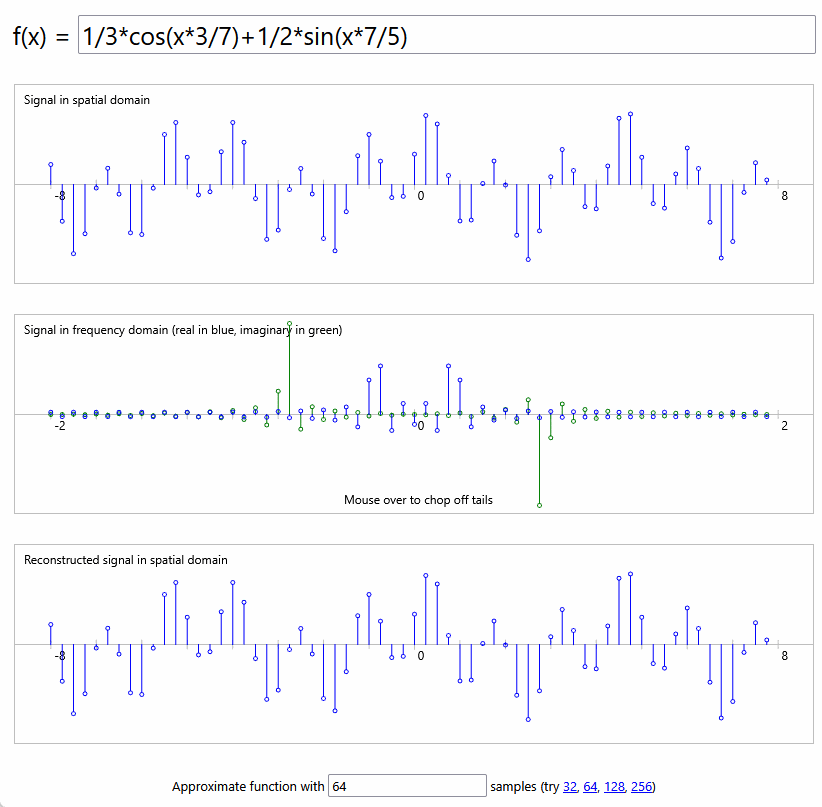
misc/dft.gif
