theodote/Senior-Project/misc/rotation.gif

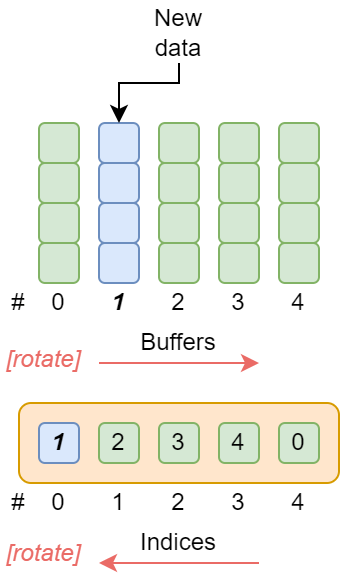
misc/rotation.gif
