theodote/Senior-Project/misc/rotation.png

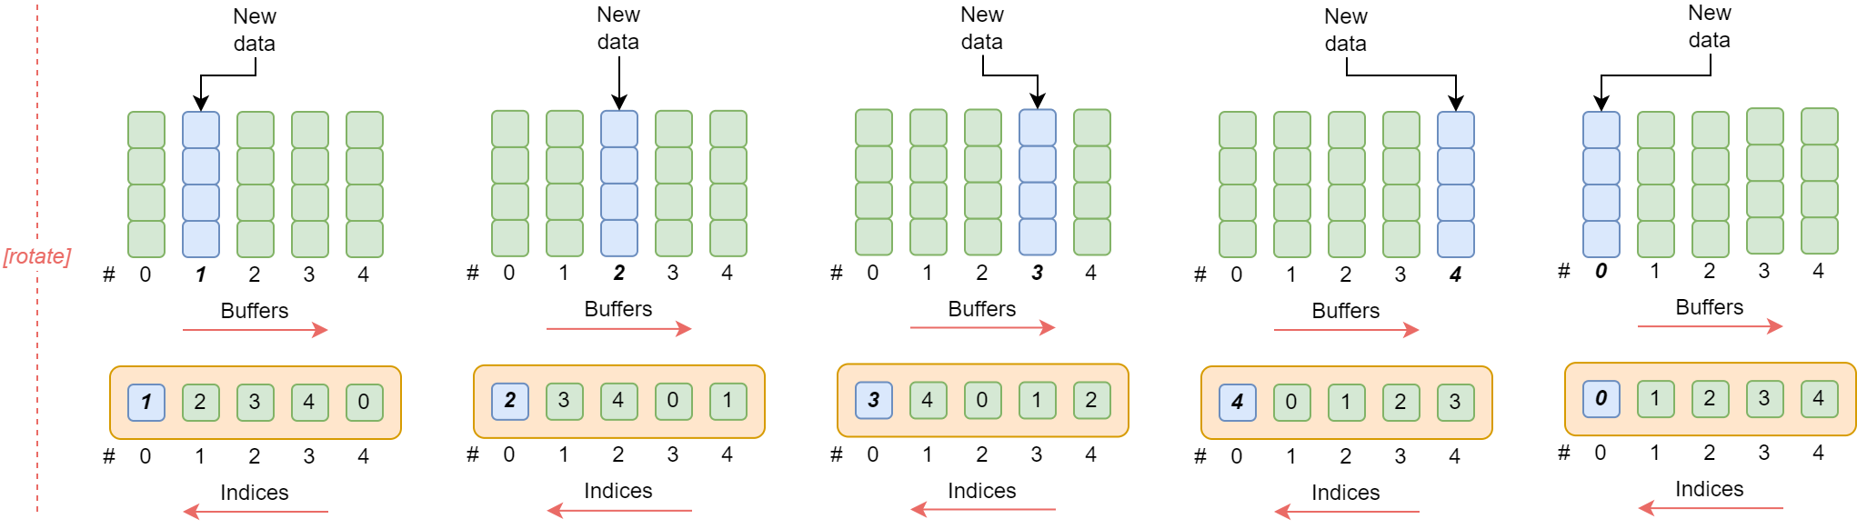
misc/rotation.png
