theodote/Senior-Project/misc/swap.gif

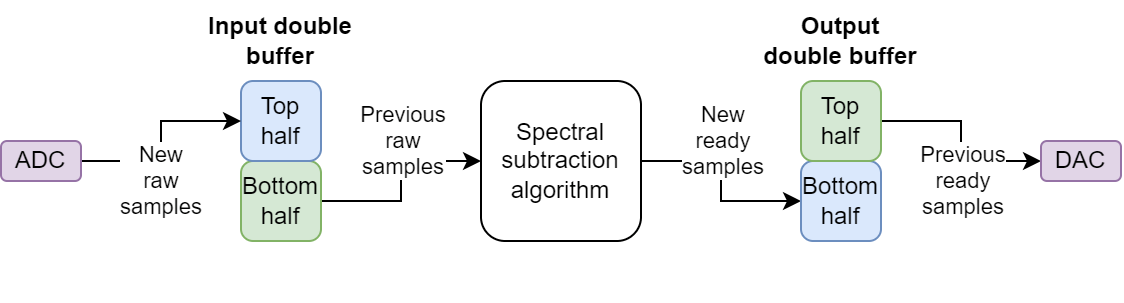
misc/swap.gif
