theodote/Senior-Project/text/gantt-after.png

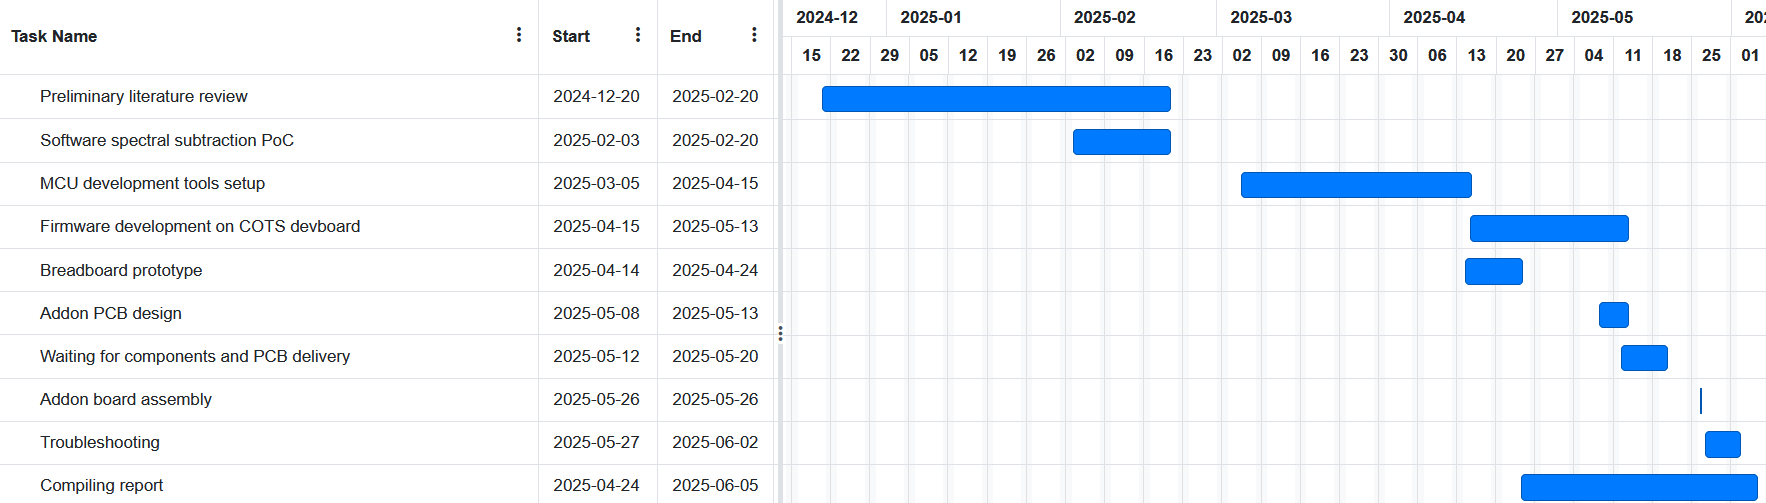
text/gantt-after.png
