theodote/Senior-Project/text/gantt-before.png

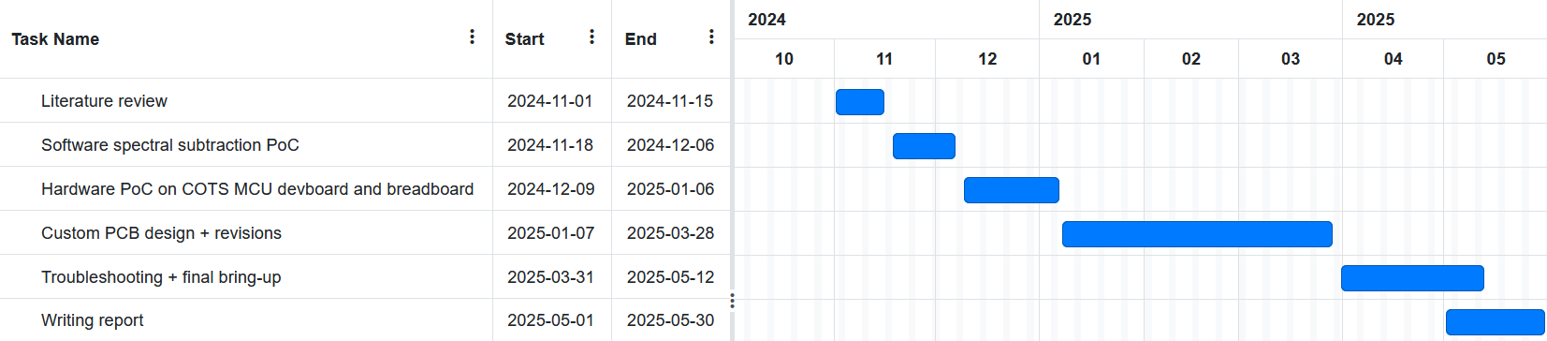
text/gantt-before.png
