theodote/Senior-Project/hw/pale_sieve/Project Outputs for pale_sieve/pale_sieve_BOM.xlsx

Sheet: pale_sieve_BOM
Comment | Description | Designator | Footprint | LibRef | Quantity
4p7 C0G | Multilayer Ceramic Capacitors MLCC - SMD/SMT 50V 4.7pF C0G 0603 5% Tol Ultra Low ESR | C1 | C0603 | 06035U4R7JAT2A | 1
10u X7T |  | C2, C5, C10 | C0603 | CGA3EDX7T1A106M080AU | 3
4u7 PET | Film Capacitor, Polyethylene Terephthalate, 100V, 10% +Tol, 10% -Tol, 4.7uF, Surface Mount, 6054 | C3, C8 | 6054 WIMA | SMDTD04470YA00KS00 | 2
47n C0G | Ceramic Capacitor, Multilayer, Ceramic, 25V, 2% +Tol, 2% -Tol, C0G, -/+30ppm/Cel TC, 0.047uF, Surface Mount, 0805 | C4, C6, C9, C11 | C0805 | C0805C473G3GECAUTO | 4
1u X5R | Ceramic Capacitor, Multilayer, Ceramic, 16V, 10% +Tol, 10% -Tol, X5R, 15% TC, 1uF, Surface Mount, 0603 | C7 | C0603 | 0603YD105KAT2A | 1
10n X7R | Ceramic Capacitor, Multilayer, Ceramic, 50V, 10% +Tol, 10% -Tol, X7R, 15% TC, 0.01uF, Surface Mount, 0603 | C12 | C0603 | GCM188R71H103KA37J | 1
1n X8G |  | C13, C14 | C0603 | C0603C102J2TACAUTO | 2
1N4148WS | Rectifier Diode, 1 Phase, 1 Element, 0.15A, 100V V(RRM), Silicon | D1, D2 | SOD-323 | 1N4148WS | 2
Quadrature Encoder | Rotary Position Encoder | ENC1 | PEC11L | PEC11L-4120F-S0020 | 1
TRRS 3.5mm | 3.5 mm, Stereo, Right Angle, Surface Mount (SMT), Audio Jack Connector | J1, J2 | SJ2-35894B-SMT | SJ2-35894B-SMT-TR | 2
10x2.54mm |  | J3 | 1X10 2.54MM | 10x2.54mm | 1
8x2.54mm |  | J4, J5 | 1x8 2.54MM | 8x2.54mm | 2
6x2.54mm |  | J6 | 1X6 2.54MM | 6x2.54mm | 1
Normally open |  | JP1, JP2, JP3, JP4, JP5, JP6, JP7, JP8, JP9, JP10, JP11, JP12, JP13, JP14 | SB 1.0x1.5mm | SolderBridge | 14
1.75mm Light Pipe |  | LP1 | PTH 1.75MM | LightPipe | 1
1k | Fixed Resistor, Metal Glaze/thick Film, 0.1W, 1000ohm, 75V, 1% +/-Tol, 100ppm/Cel, Surface Mount, 0603 | R1, R11, R13 | R0603 | CRCW06031K00FKEI | 3
2k2 | Fixed Resistor, Metal Glaze/thick Film, 0.1W, 2200ohm, 75V, 1% +/-Tol, 100ppm/Cel, Surface Mount, 0603 | R2 | R0603 | CRCW06032K20FKEA | 1
150R | Fixed Resistor, Metal Glaze/thick Film, 0.1W, 150ohm, 75V, 1% +/-Tol, 100ppm/Cel, Surface Mount, 0603 | R3, R4, R6, R7 | R0603 | CRCW0603150RFKEA | 4
470R | Fixed Resistor, Metal Glaze/thick Film, 0.1W, 470ohm, 75V, 1% +/-Tol, 100ppm/Cel, Surface Mount, 0603 | R5 | R0603 | CRCW0603470RFKEC | 1
47k | Fixed Resistor, Metal Glaze/thick Film, 0.1W, 47000ohm, 75V, 1% +/-Tol, 100ppm/Cel, Surface Mount, 0603 | R8, R9, R10 | R0603 | CRCW060347K0FKEA | 3
10k | Fixed Resistor, Metal Glaze/thick Film, 0.1W, 10000ohm, 75V, 1% +/-Tol, 100ppm/Cel, Surface Mount, 0603 | R12 | R0603 | CRCW060310K0FKEA | 1
PTH 0.75mm |  | TP1, TP2, TP3, TP4, TP5, TP6, TP7, TP8, TP9, TP10, TP11, TP12, TP13, TP14, TP15, TP16, TP17 | PTH 0.7MM | TestPoint | 17
OPA2323 |  | U1, U2 | SOIC-8 D | OPA2323IDR | 2
1M | Trimmer, Cermet, 0.04W, 1000000ohm, 200V, 20% +/-Tol, 100ppm/Cel, 1 Turn(s) | VR1 | TS53YL | TS53YL105MR10 | 1
200k | Trimmer, Cermet, 0.2W, 200000ohm, 200V, 20% +/-Tol, 100ppm/Cel, 1 Turn(s) | VR2 | TS53YL | TS53YL204MR10 | 1
1k | Trimmer, Cermet, 0.25W, 1000ohm, 15.8V, 20% +/-Tol, 100ppm/Cel, 1 Turn(s) | VR3 | TS53YL | TS53YL102MR10 | 1

Sheet: Sheet1
Component | Designators | MPN | Quantity | Pricing | Cost
4p7 C0G | C1 | 06035U4R7JAT2A | 1 | €0.37 | €0.37
10u X5R | C2, C5, C10 | C1608X5R1A106K080AC | 3 | €0.23 | €0.68
4u7 PET | C3, C8 | SMDTD04470YA00KS00 | 2 | €2.95 | €5.90
47n C0G | C4, C6, C9, C11 | C0805C473G3GECAUTO | 4 | €0.82 | €3.27
1u X5R | C7 | 0603YD105KAT2A | 1 | €0.11 | €0.11
10n X7R | C12 | GCM188R71H103KA37J | 1 | €0.11 | €0.11
1n X8G | C13, C14 | C0603C102J2TACAUTO | 2 | €0.52 | €1.05
1N4148WS | D1, D2 | 1N4148WS | 2 | €0.10 | €0.21
Quadrature Encoder | ENC1 | PEC11L-4120F-S0020 | 1 | €2.20 | €2.20
TRRS 3.5mm socket | J1, J2 | SJ2-35894B-SMT-TR | 2 | €1.24 | €2.48
32x2.54mm pin header | J3, J4, J5, J6 | 61303211121 | 1 | €2.11 | €2.11
1k | R1, R11, R13 | CRCW06031K00FKEI | 3 | €0.11 | €0.34
2k2 | R2 | CRCW06032K20FKEA | 1 | €0.10 | €0.10
150R | R3, R4, R6, R7 | CRCW0603150RFKEA | 4 | €0.10 | €0.38
470R | R5 | CRCW0603470RFKEC | 1 | €0.10 | €0.10
47k | R8, R9, R10 | CRCW060347K0FKEA | 3 | €0.10 | €0.29
10k | R12 | CRCW060310K0FKEA | 1 | €0.10 | €0.10
OPA2323 | U1, U2 | OPA2323IDR | 2 | €1.57 | €3.14
1M | VR1 | TS53YL105MR10 | 1 | €2.58 | €2.58
200k | VR2 | TS53YL204MR10 | 1 | €2.58 | €2.58
1k | VR3 | TS53YL102MR10 | 1 | €2.58 | €2.58
NUCLEO-F446RE | - | NUCLEO-F446RE | 1 | €14.11 | €14.11
 |  |  |  | Total | €44.78

Sheet: Sheet2
Expenses | Item | Expected cost | Actual cost | Remark
Proposed | Reflow hotplate | €100.00 | €0.00 | Soldering iron
 |  |  |  | used instead
 | PCB orders | €100.00 | €51.00 | Incl. delivery
 |  |  |  | No re-spins
 | Component BOM | €50.00 | €75.45 | 2x QTY redundancy
 |  |  |  | sans 1 devboard
 | Software licenses | €0.00 | €10.00 | Overleaf subscription
Additional | Audio cables |  | €30.00 | Sourced locally
 | Power bank |  | €0.00 | Already on hand
 | Tapestry needles |  | €10.00 | Sourced locally
 | Prototype |  | €40.00 | Breadboardable
 |  |  |  | THT components
Unused | AD3 Audio Adapter+ |  | €28.49 | TRS-only jacks
 | Total: | €250.00 | €244.94
