theodote/Senior-Project/misc/maps.xlsx

Sheet: Sheet1
Testpoint | Function | PCB hints
TP1 | Microphone pin | MIC
TP2 | ADC input | U1, AA
TP3 | TIA output | DONE
TP4 | Antialiasing LPF input | R3
TP5 | Reconstruction LPF output | C9, AA
TP6 | Attenuation buffer output | U2
TP7 | DAC output | DAC
TP8 | Reconstruction LPF input | C11, DAC
TP9 | Attenuator center pin | ATTEN, PWR
TP10 | Power rail | VCC
TP11 | Ground | GND
TP12 | Encoder phase A | R11
TP13 | Encoder pin A | A
TP14 | Encoder button pin | R10, R12
TP15 | Encoder button signal | BTN
TP16 | Encoder phase B | R13, C14
TP17 | Encoder pin B | B

Sheet: Sheet2
One end | Solder bridge | Other end | PCB hints
Power rail | JP1 | Mic bias network | PMIC
Power rail | JP2 | Input opamp power pin | PWR, U1
TP1 | JP3 | Input AC coupling capacitor | MIC
TP2 | JP4 | ADC input | ADC
TP3 | JP5 | TP4 | DONE
Power rail | JP6 | Output opamp power pin | PWR, U2
TP7 | JP7 | Output limiting resistor | PROT, R5
TP5 | JP8 | Attenuatting potentiometer | AA, C10
TP7 | JP9 | TP8 | DAC
TP6 | JP10 | Clamping diode 1 | PROT, D1
TP6 | JP11 | Clamping diode 2 | PROT, D2
TP12 | JP12 | GPIO phase A input | A
TP15 | JP13 | GPIO button input | BTN
TP16 | JP14 | GPIO phase B input | B

Sheet: Sheet3
Addon board net | Nucleo Arduino header pin marking
VCC | 3V3, AVDD
GND | GND, GND, AGND
ENC_A | A0
ENC_B | A1
DAC_OUT | A2
BUTON | A3
ADC_IN | D12
