theodote/Senior-Project/misc/Basket_May12_0403PM.xls

SHOPPING BASKET
This is not an invoice
12-May-25 16:03:08
 | Mouser No | Mfr. No | Manufacturer | Customer No | Description | RoHS | Lifecycle | Order Qty. | Price (EUR) | Ext.: (EUR)
1 | 581-06035U4R7JAT2A | 06035U4R7JAT2A | KYOCERA AVX |  | Multilayer Ceramic Capacitors MLCC - SMD/SMT 50V 4.7pF C0G 0603 5% | RoHS Compliant |  | 2 | 0,371 € | 0,74 €
2 | 505-SMDTD04470YA00KS | SMDTD04470YA00KS00 | WIMA |  | Film Capacitors 4.7 uF 100 VDC 10% | RoHS Compliant |  | 4 | 2,95 € | 11,80 €
3 | 80-C0805C473G3GECAUT | C0805C473G3GECAUTO | KEMET |  | Multilayer Ceramic Capacitors MLCC - SMD/SMT 25V 0.047uF C0G 0805 2% AEC-Q200 | RoHS Compliant |  | 8 | 0,817 € | 6,54 €
4 | 581-0603YD105K | 0603YD105KAT2A | KYOCERA AVX |  | Multilayer Ceramic Capacitors MLCC - SMD/SMT KGM15BR51C105KT NEW GLOBAL PN 16V 1uF X5 A 581-KGM15BR51C105KT | RoHS Compliant By Exemption |  | 2 | 0,095 € | 0,19 €
5 | 81-GCM188R71H103KA7J | GCM188R71H103KA37J | Murata |  | Multilayer Ceramic Capacitors MLCC - SMD/SMT 0.01 uF 50 VDC 10% 0603 X7R AEC-Q200 | RoHS Compliant |  | 2 | 0,114 € | 0,23 €
6 | 80-C0603C102J2TAUTO | C0603C102J2TACAUTO | KEMET |  | Multilayer Ceramic Capacitors MLCC - SMD/SMT Cap Cer 0603 1nF 200VDC X8G 5% | RoHS Compliant |  | 4 | 0,523 € | 2,09 €
7 | 512-1N4148WS | 1N4148WS | onsemi |  | Small Signal Switching Diodes Small Signal Diode | RoHS Compliant |  | 4 | 0,105 € | 0,42 €
8 | 652-PEC11L4120FS0020 | PEC11L-4120F-S0020 | Bourns |  | Encoders 11mm Low Profile Pulse/Rotation | RoHS Compliant |  | 2 | 2,20 € | 4,40 €
9 | 490-SJ2-35894BSMT-TR | SJ2-35894B-SMT-TR | Same Sky |  | Phone Connectors 3.5mm Audio Jack SMT 4conductr Tip switch | RoHS Compliant |  | 4 | 1,24 € | 4,96 €
10 | 71-CRCW06031K00FKEI | CRCW06031K00FKEI | Vishay |  | Thick Film Resistors - SMD 1K OHM 1% | RoHS Compliant By Exemption |  | 6 | 0,114 € | 0,68 €
11 | 71-CRCW0603-2.2K-E3 | CRCW06032K20FKEA | Vishay |  | Thick Film Resistors - SMD 1/10watt 2.2Kohms 1% | RoHS Compliant By Exemption |  | 2 | 0,095 € | 0,19 €
12 | 71-CRCW0603-150-E3 | CRCW0603150RFKEA | Vishay |  | Thick Film Resistors - SMD 1/10watt 150ohms 1% | RoHS Compliant By Exemption |  | 8 | 0,095 € | 0,76 €
13 | 71-CRCW0603470RFKEC | CRCW0603470RFKEC | Vishay |  | Thick Film Resistors - SMD 470 OHM 1% | RoHS Compliant By Exemption |  | 2 | 0,095 € | 0,19 €
14 | 71-CRCW0603-47K-E3 | CRCW060347K0FKEA | Vishay |  | Thick Film Resistors - SMD 1/10watt 47Kohms 1% | RoHS Compliant By Exemption |  | 6 | 0,095 € | 0,57 €
15 | 71-CRCW0603-10K-E3 | CRCW060310K0FKEA | Vishay |  | Thick Film Resistors - SMD 1/10watt 10Kohms 1% | RoHS Compliant By Exemption |  | 2 | 0,095 € | 0,19 €
16 | 595-OPA2323IDR | OPA2323IDR | Texas Instruments |  | Operational Amplifiers - Op Amps OP AMPS | RoHS Compliant | New Product | 4 | 1,57 € | 6,28 €
17 | 72-TS53YL-1M | TS53YL105MR10 | Vishay |  | Trimmer Resistors - SMD 1Mohms 20% SQ POT | RoHS Compliant By Exemption |  | 2 | 2,58 € | 5,16 €
18 | 72-TS53YL-200K | TS53YL204MR10 | Vishay |  | Trimmer Resistors - SMD 200Kohms 20% SQ POT | RoHS Compliant By Exemption |  | 2 | 2,58 € | 5,16 €
19 | 72-TS53YL-1K | TS53YL102MR10 | Vishay |  | Trimmer Resistors - SMD 20% 1K SQ POT | RoHS Compliant By Exemption |  | 2 | 2,58 € | 5,16 €
20 | 710-61303211121 | 61303211121 | Wurth Elektronik |  | Headers & Wire Housings WR-PHD 2.54mm 32Pin THT Pin Header | RoHS Compliant |  | 2 | 2,11 € | 4,22 €
21 | 810-C1608X5R1A106K | C1608X5R1A106K080AC | TDK |  | Multilayer Ceramic Capacitors MLCC - SMD/SMT 0603 10V 10uF X5R 10% T: 0.8mm | RoHS Compliant |  | 6 | 0,228 € | 1,37 €
By submitting your order you agree to these terms and conditions. (https://eu.mouser.com/saleterms) |  |  |  |  |  |  |  |  | Merchandise: | 61,30 €
Prices are reflected at the date and time shown. |  |  |  |  |  |  |  |  | Delivery Charge: | 0,00 €
