theodote/Senior-Project/hw/pale_sieve/3D/CRCW060347K0FKEA.stp

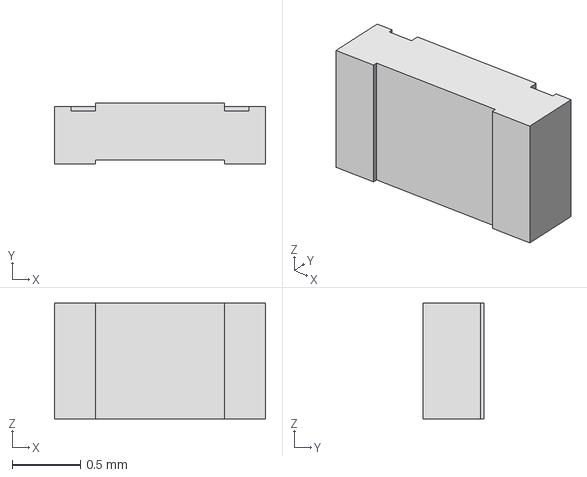
[picture p67: CAD file, 2025-05-10]
hw/pale_sieve/3D/CRCW060347K0FKEA.stp
1.55 x 0.45 x 0.85 mm
