theodote/Senior-Project/hw/pale_sieve/3D/GCM188R71C104KA37J.stp

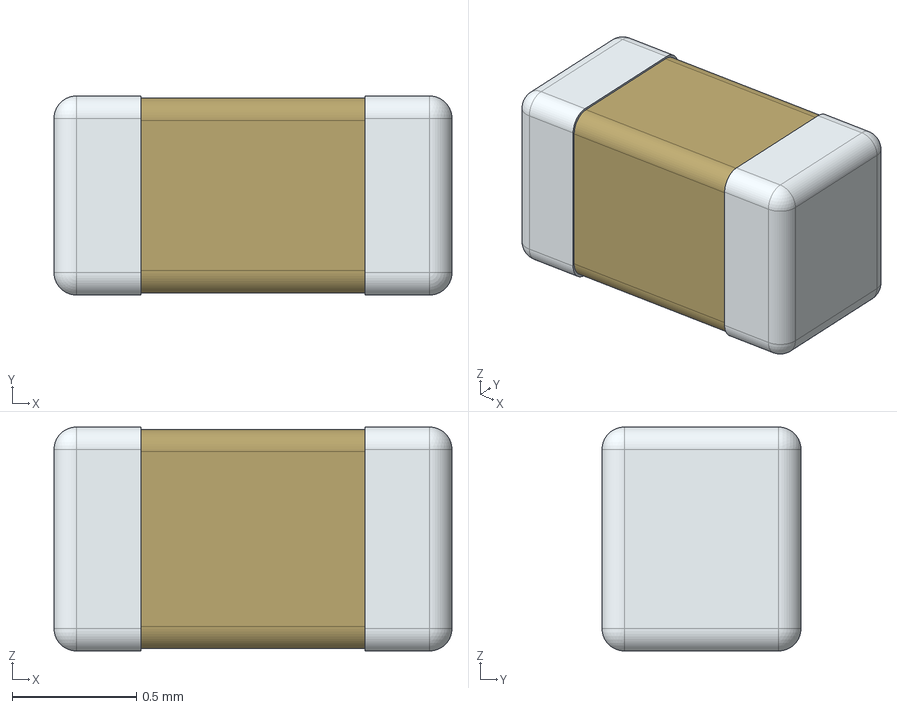
[picture p68: CAD file, 2025-05-10]
hw/pale_sieve/3D/GCM188R71C104KA37J.stp
1.60 x 0.8 x 0.9 mm
