theodote/Senior-Project/hw/pale_sieve/3D/SJ2-35894B-SMT-TR.stp

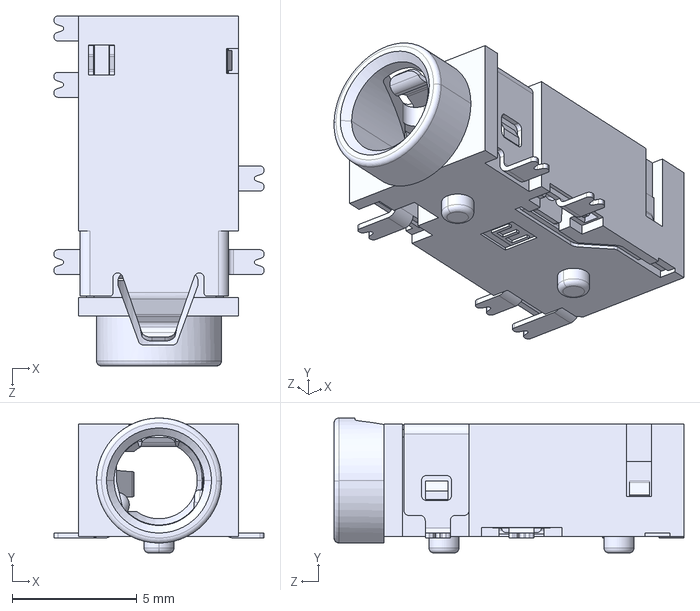
[picture p69: CAD file, 2025-05-10]
hw/pale_sieve/3D/SJ2-35894B-SMT-TR.stp
8.40 x 5.40 x 14.0 mm
