theodote/Senior-Project/hw/pale_sieve/3D/C0805C473G3GECAUTO.stp

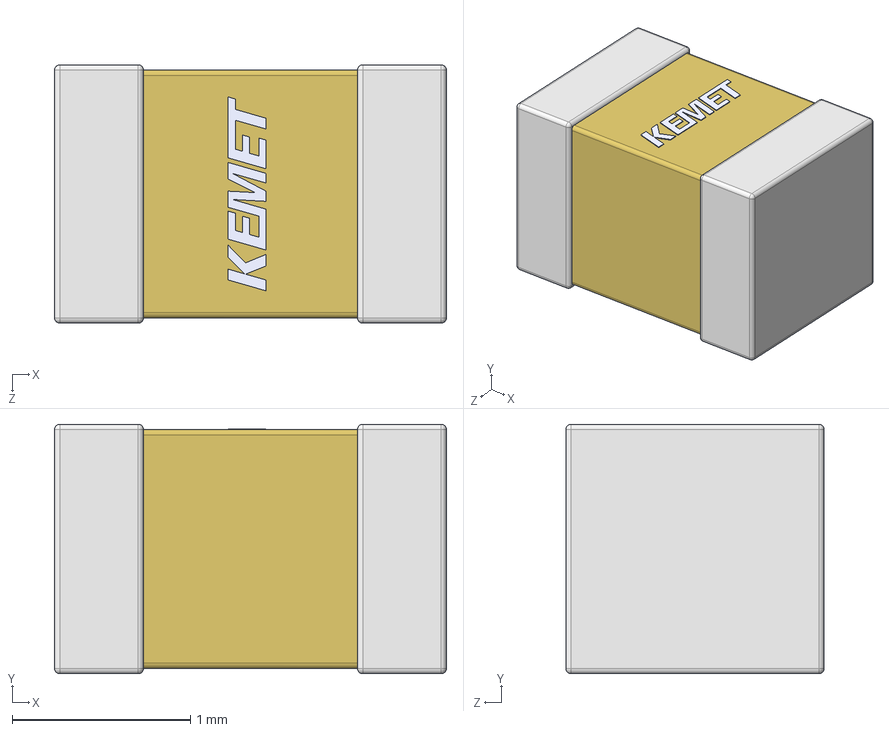
[picture p70: CAD file, 2025-05-10]
hw/pale_sieve/3D/C0805C473G3GECAUTO.stp
2.20 x 1.40 x 1.45 mm
