theodote/Senior-Project/hw/pale_sieve/3D/SMDTD04470YA00KS00.stp

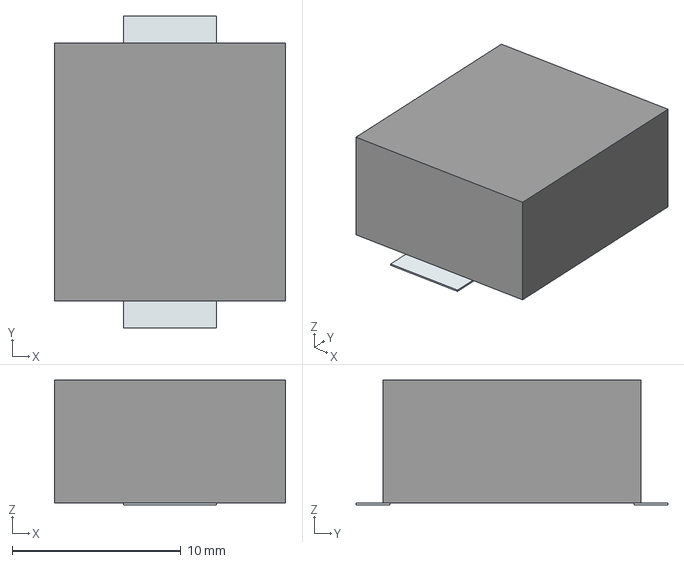
[picture p71: CAD file, 2025-05-10]
hw/pale_sieve/3D/SMDTD04470YA00KS00.stp
13.7 x 18.5 x 7.40 mm
Pins
