theodote/Senior-Project/hw/pale_sieve/3D/TS53YL105MR10.stp

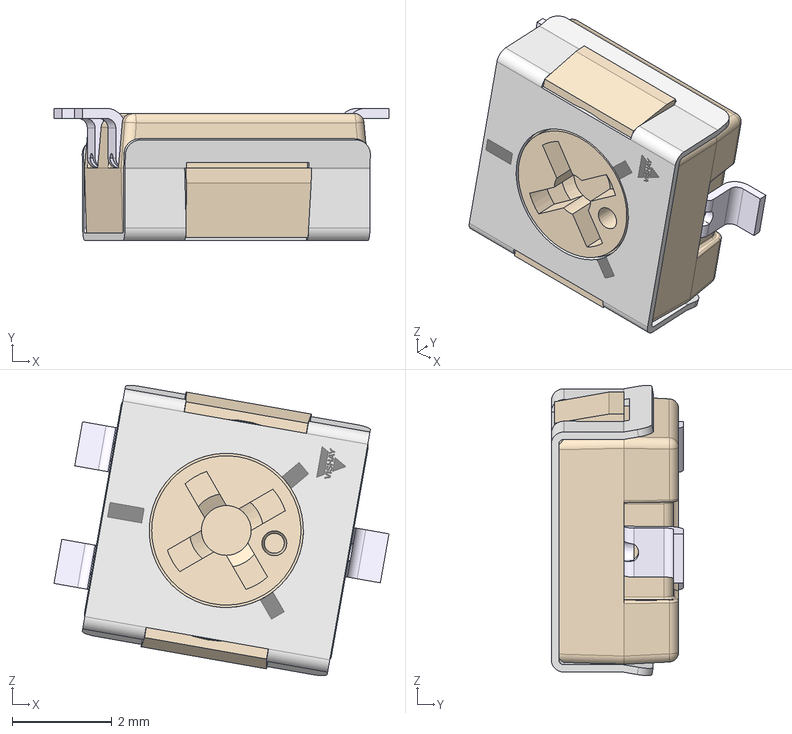
[picture p72: CAD file, 2025-05-10]
hw/pale_sieve/3D/TS53YL105MR10.stp
6.73 x 2.66 x 5.83 mm
substrat seul
3935201-L
