theodote/Senior-Project/hw/pale_sieve/3D/OPA2323IDR.stp

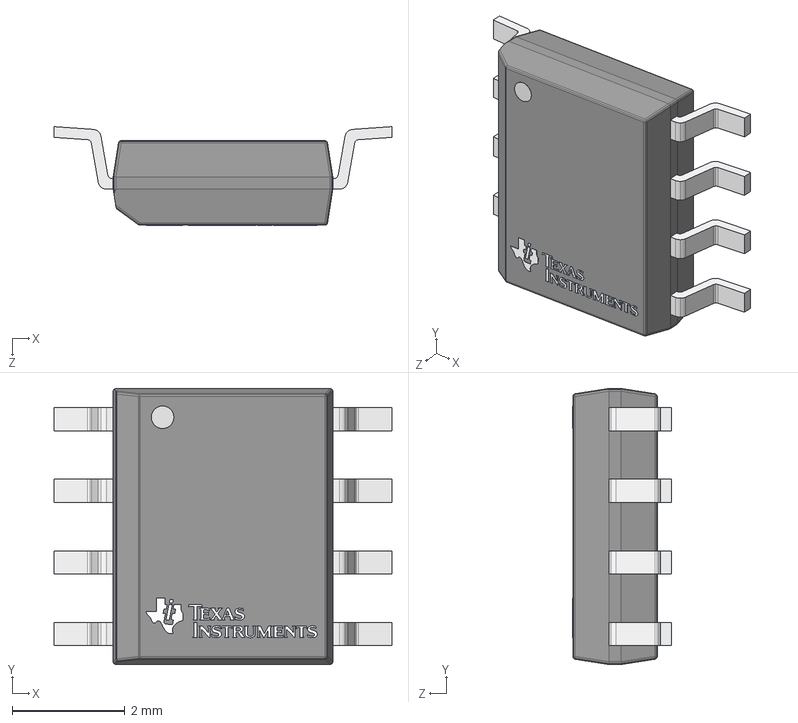
[picture p73: CAD file, 2025-05-10]
hw/pale_sieve/3D/OPA2323IDR.stp
6.00 x 4.90 x 1.75 mm
IC_BODY^Texas_Instruments_-_OPA2392DR.step
circle^Texas_Instruments_-_OPA2392DR.step
IC_LEG.step x 4
Texas Instruments^Texas_Instruments_-_OPA2392DR.step
IC_LEG_MIR8^Texas_Instruments_-_OPA2392DR.step x 4
