theodote/Senior-Project/hw/pale_sieve/3D/TS53YL502MR10.stp

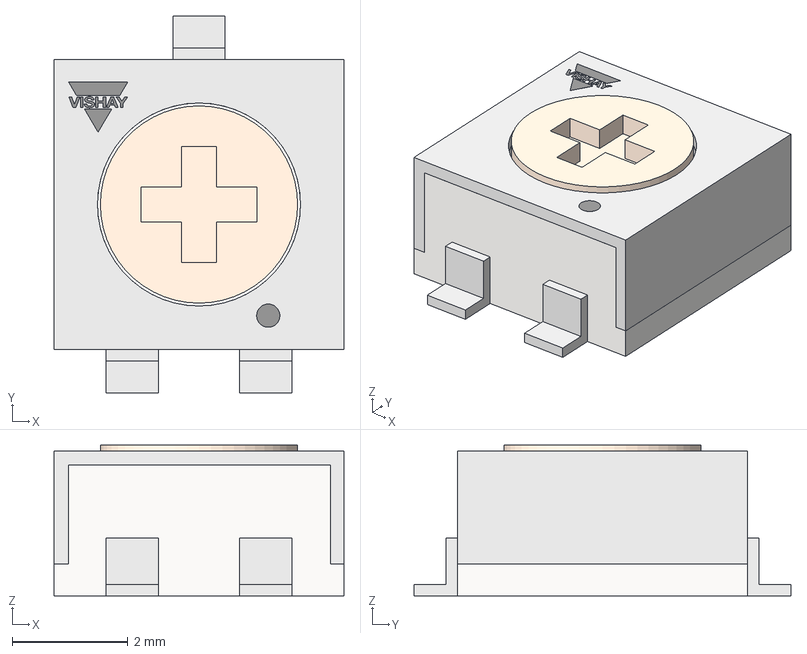
[picture p74: CAD file, 2025-05-10]
hw/pale_sieve/3D/TS53YL502MR10.stp
5.00 x 6.50 x 2.60 mm
circle
Vishay
