theodote/Senior-Project/hw/pale_sieve/3D/PEC11L-4120F-S0020.stp

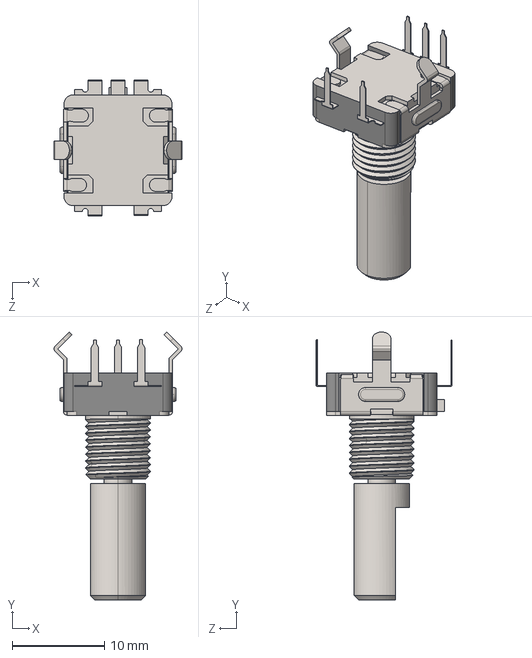
[picture p75: CAD file, 2025-05-10]
hw/pale_sieve/3D/PEC11L-4120F-S0020.stp
13.8 x 29.0 x 14.7 mm
