theodote/Senior-Project/hw/pale_sieve/3D/1N4148WS.stp

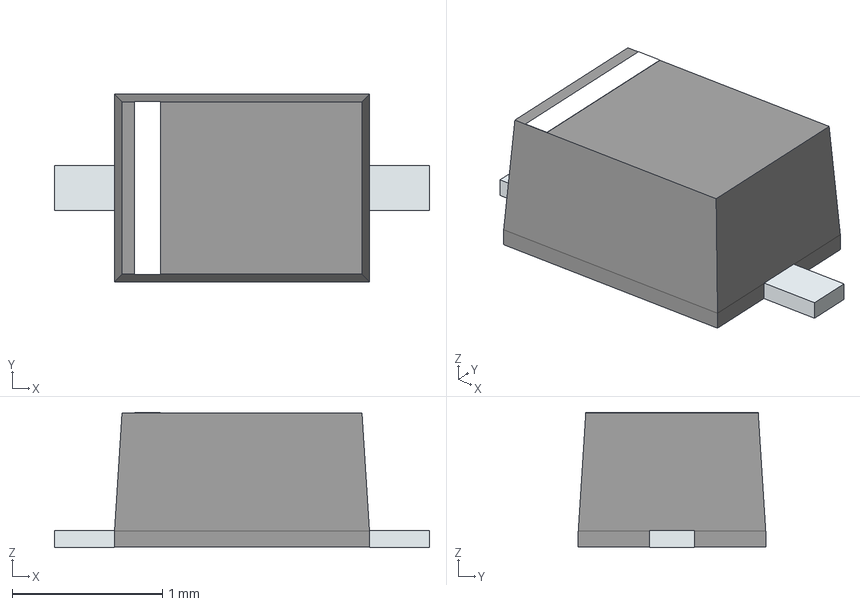
[picture p76: CAD file, 2025-05-10]
hw/pale_sieve/3D/1N4148WS.stp
2.50 x 1.25 x 0.9 mm
PinKIdent
PinK
PinA
