theodote/Senior-Project/hw/pale_sieve/3D/61300611121.stp

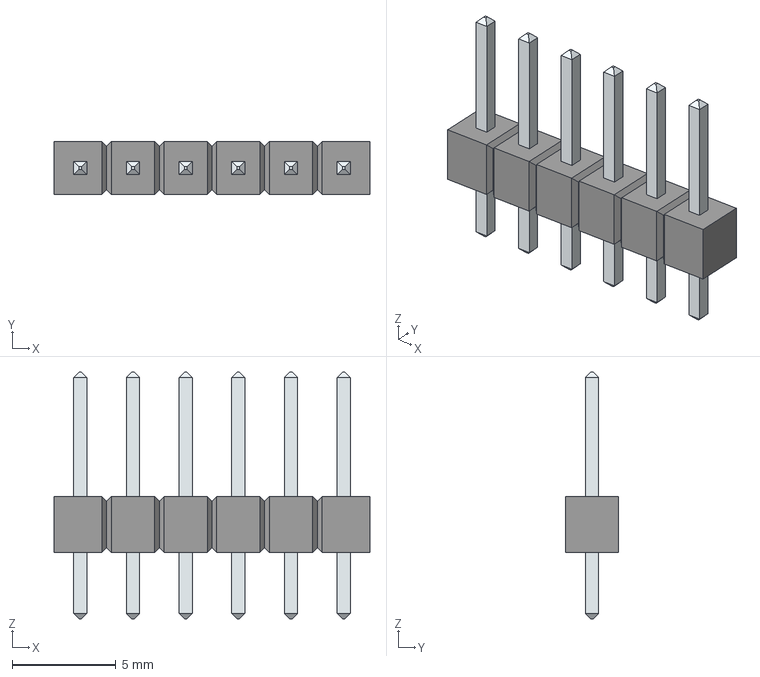
[picture p77: CAD file, 2025-05-12]
hw/pale_sieve/3D/61300611121.stp
15.2 x 2.54 x 11.9 mm
LeadsArray
