theodote/Senior-Project/hw/pale_sieve/3D/61300811121.stp

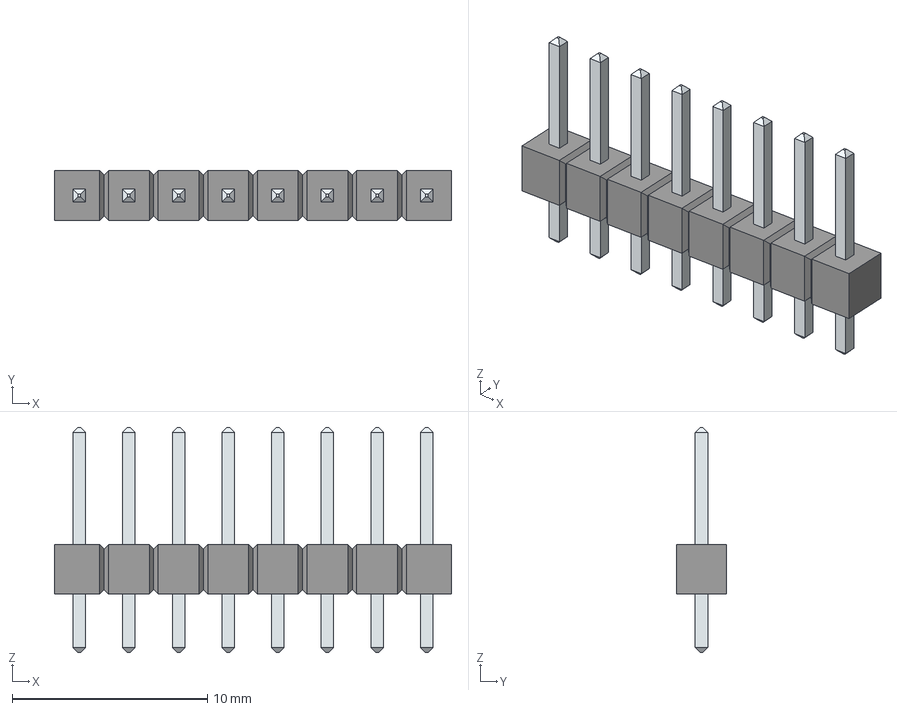
[picture p78: CAD file, 2025-05-12]
hw/pale_sieve/3D/61300811121.stp
20.3 x 2.54 x 11.5 mm
LeadsArray
