theodote/Senior-Project/hw/pale_sieve/3D/61301011121.stp

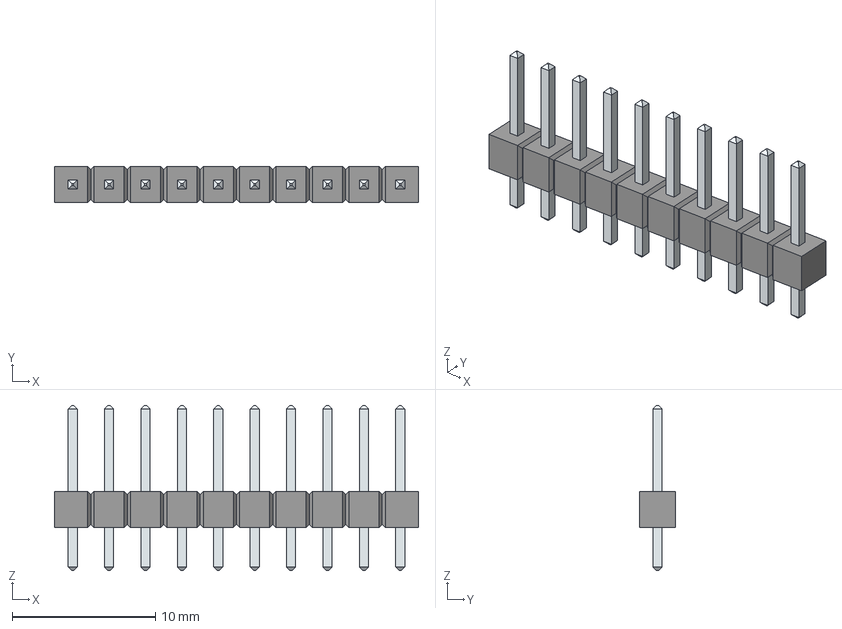
[picture p79: CAD file, 2025-05-12]
hw/pale_sieve/3D/61301011121.stp
25.4 x 2.54 x 11.5 mm
LeadsArray
