theodote/Senior-Project/tests/2k2 bias.png

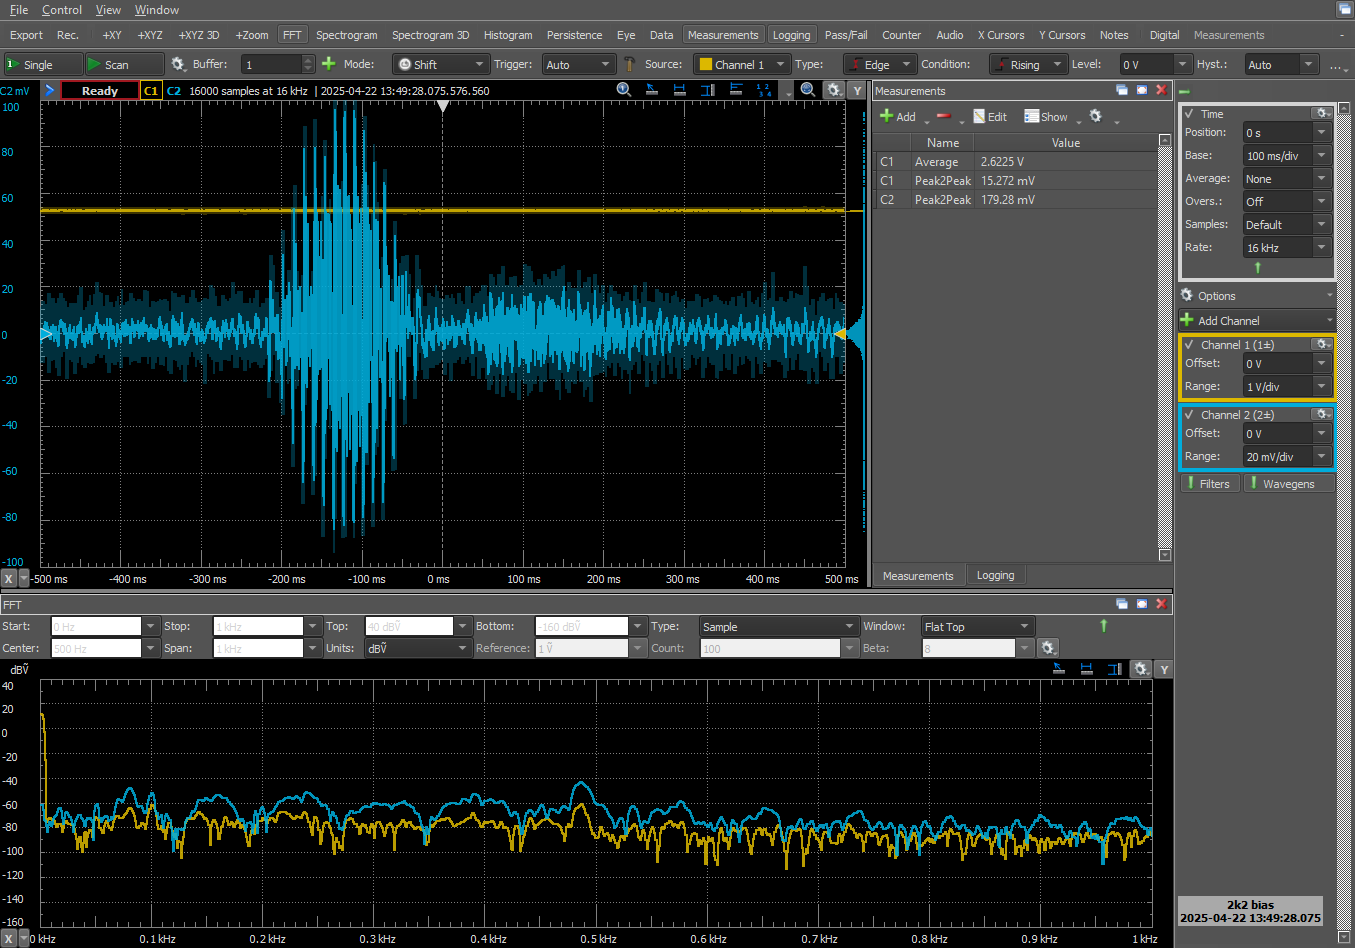
tests/2k2 bias.png
