theodote/Senior-Project/tests/3k3 bias.png

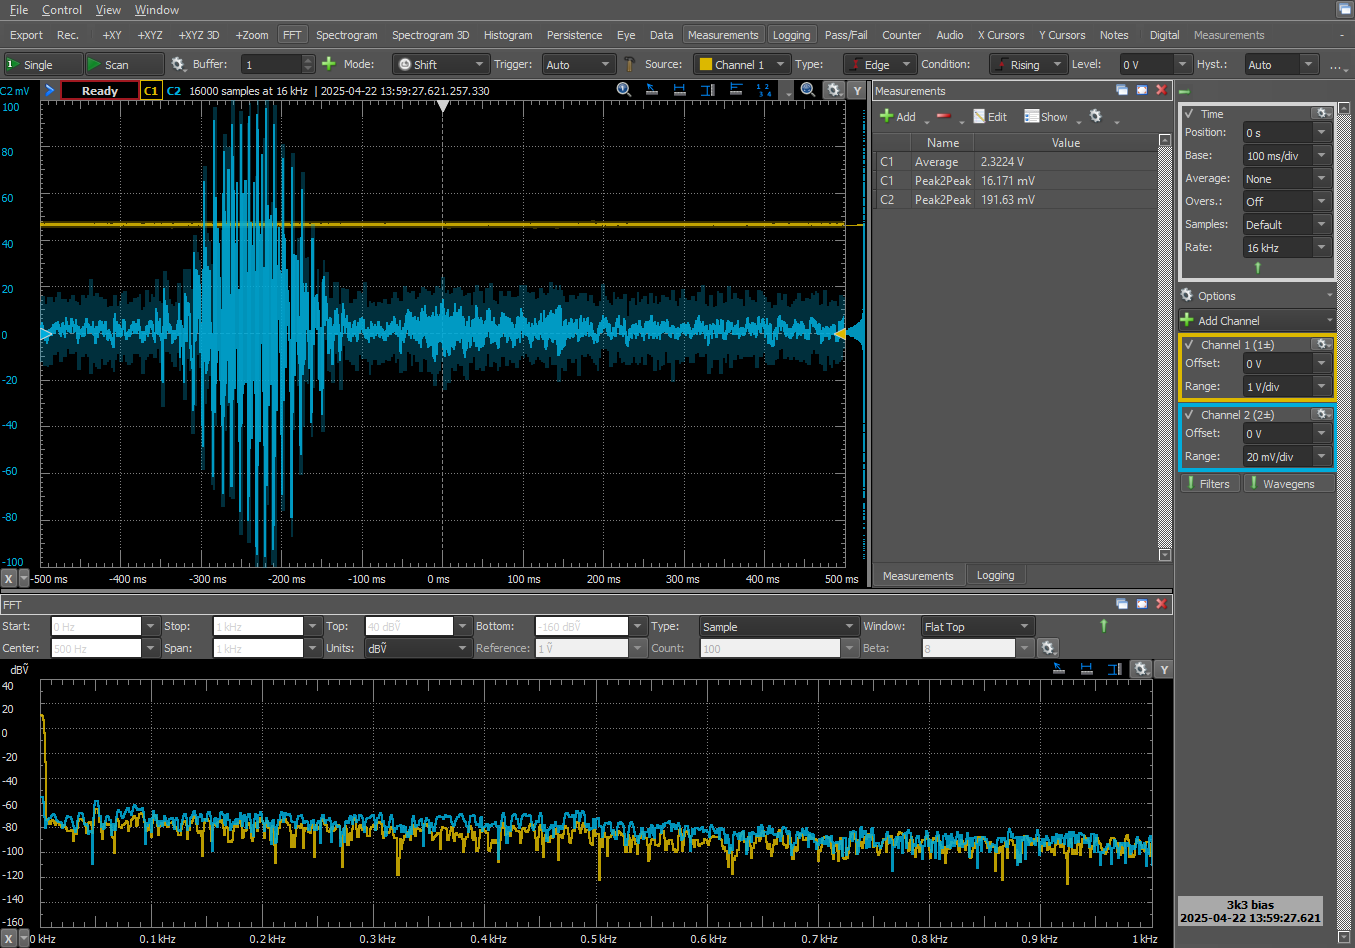
tests/3k3 bias.png
