theodote/Senior-Project/tests/4k7 bias.png

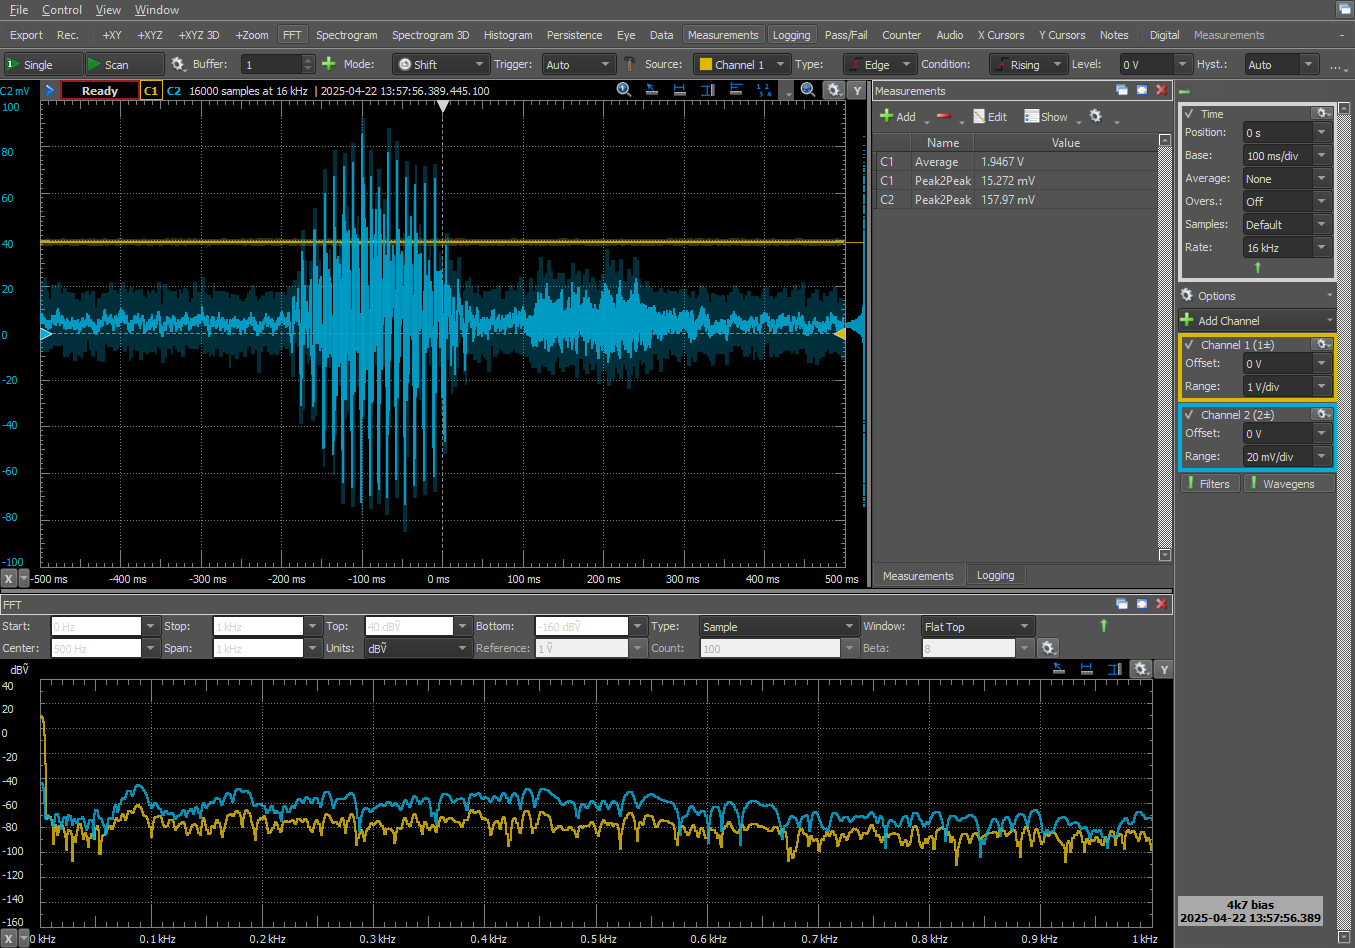
tests/4k7 bias.png
