theodote/Senior-Project/tests/10k bias.png

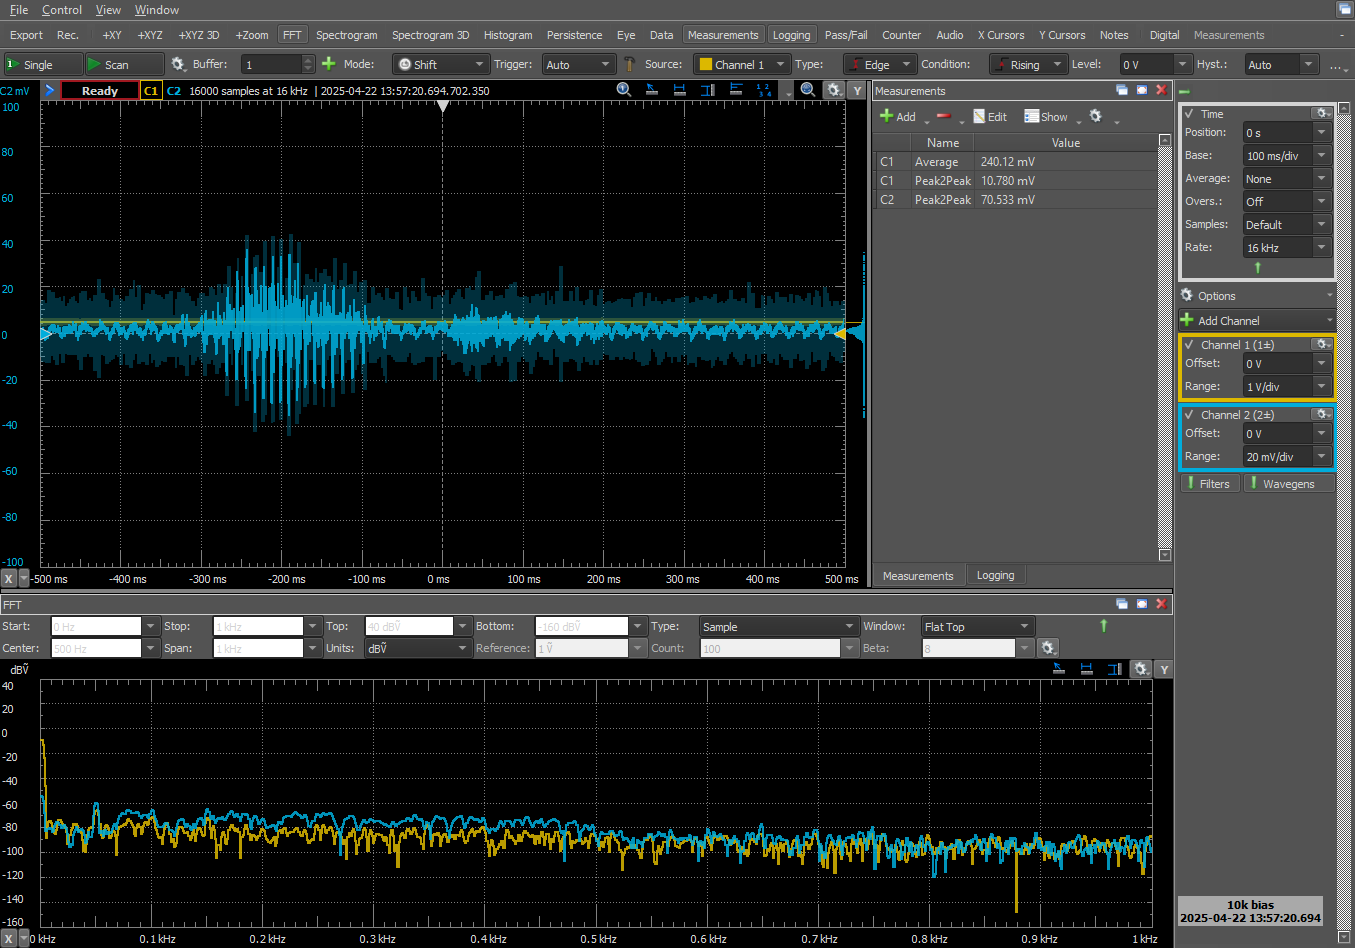
tests/10k bias.png
