theodote/Senior-Project/tests/22k bias.png

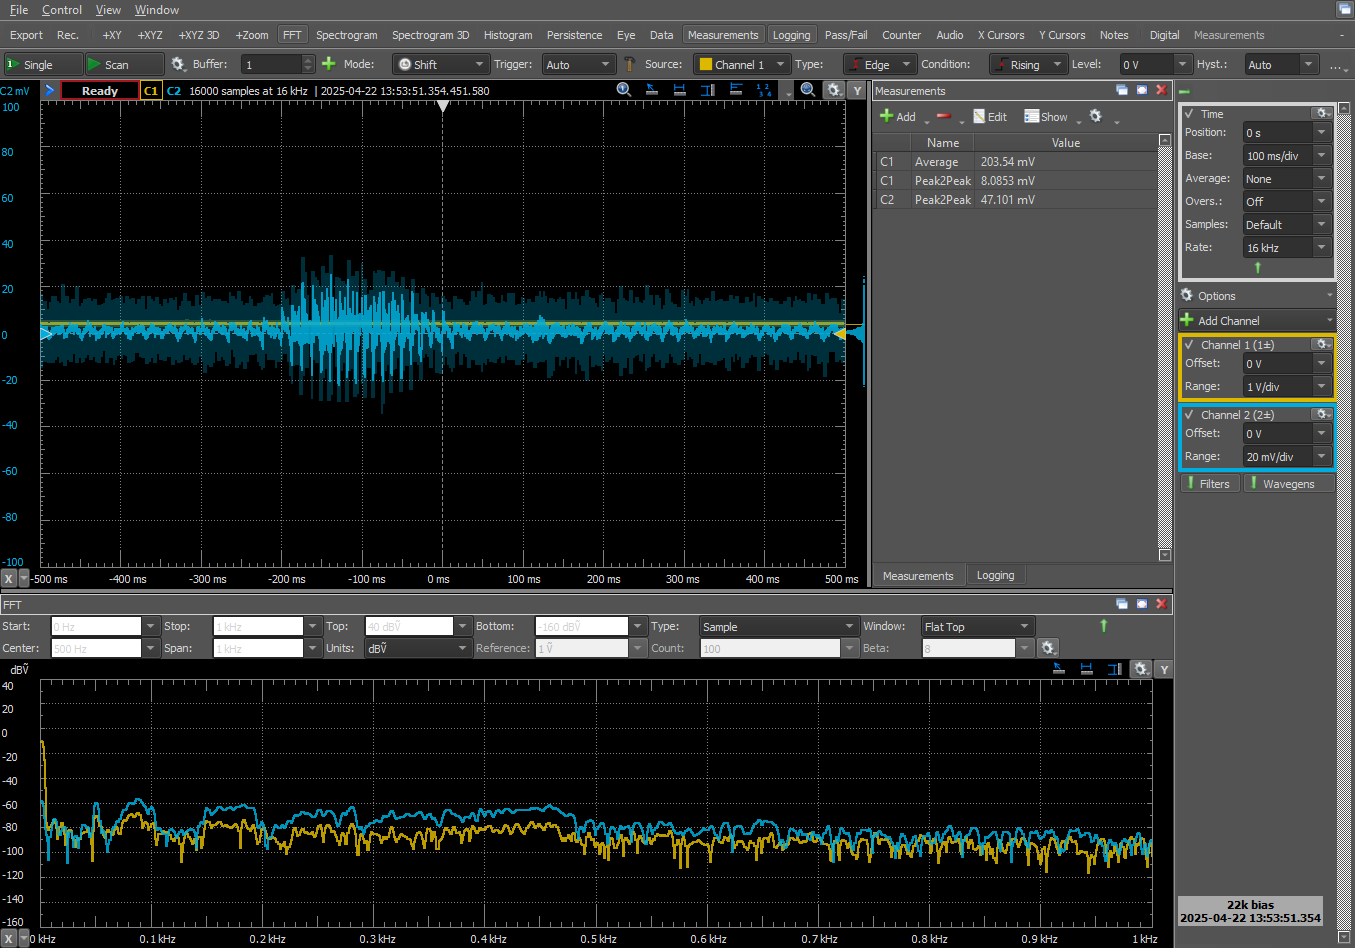
tests/22k bias.png
