theodote/Senior-Project/tests/220 bias.png

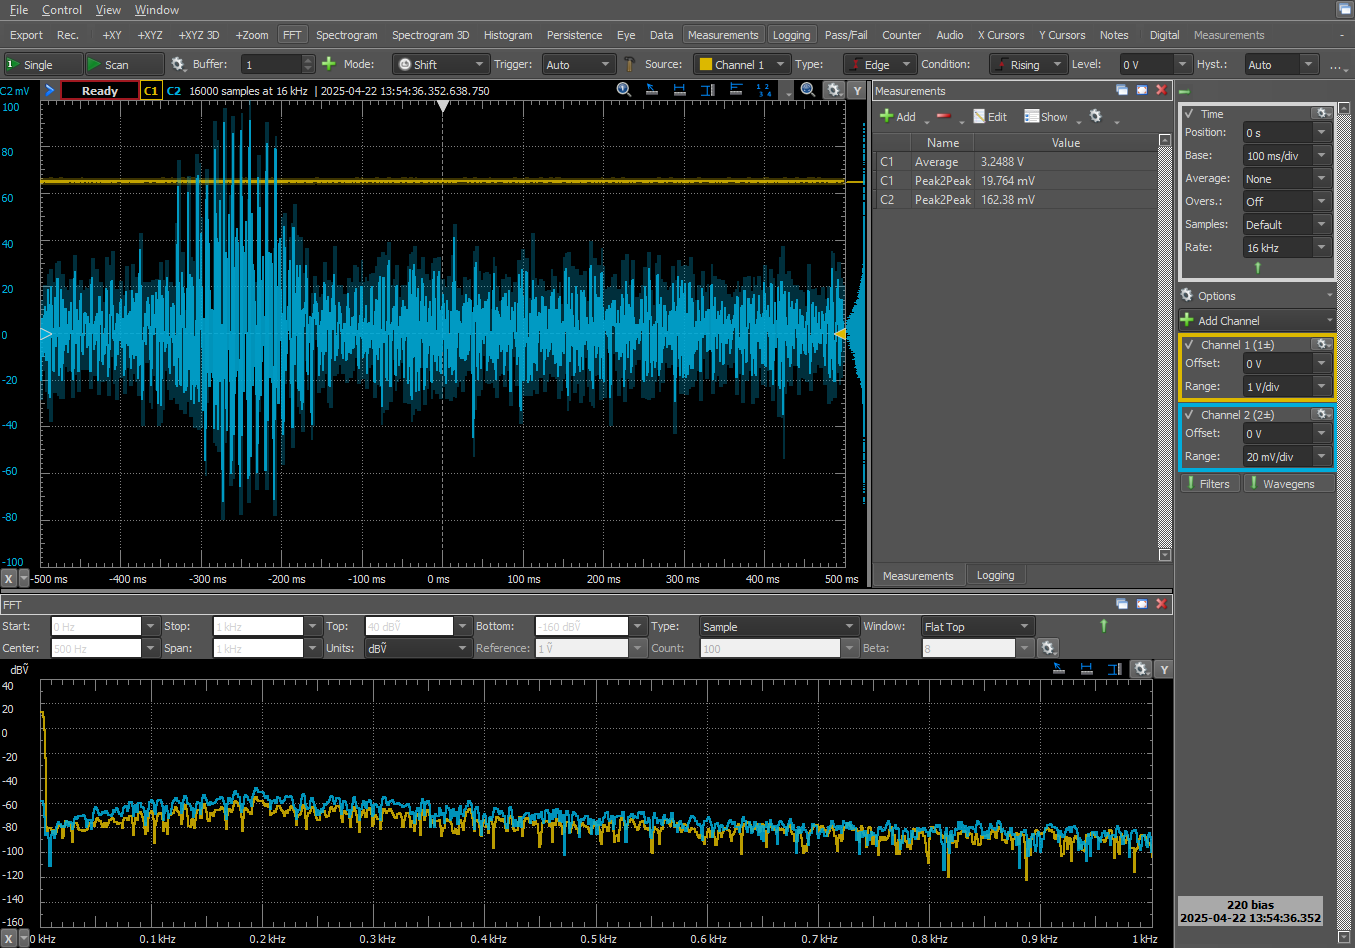
tests/220 bias.png
