theodote/Senior-Project/tests/adc-side lpf.png

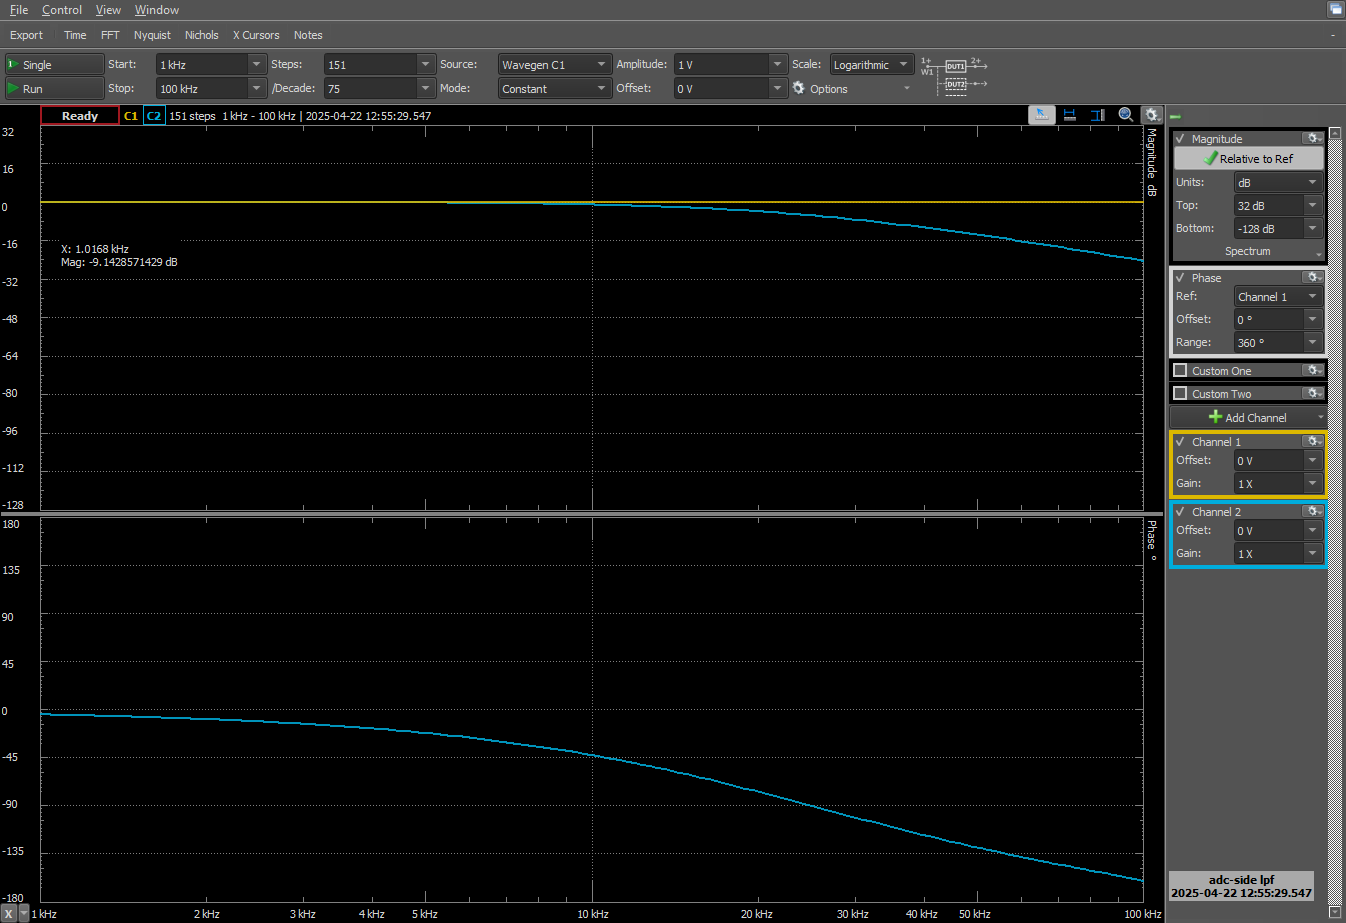
tests/adc-side lpf.png
