theodote/Senior-Project/tests/algorithm/bypass-delay.png

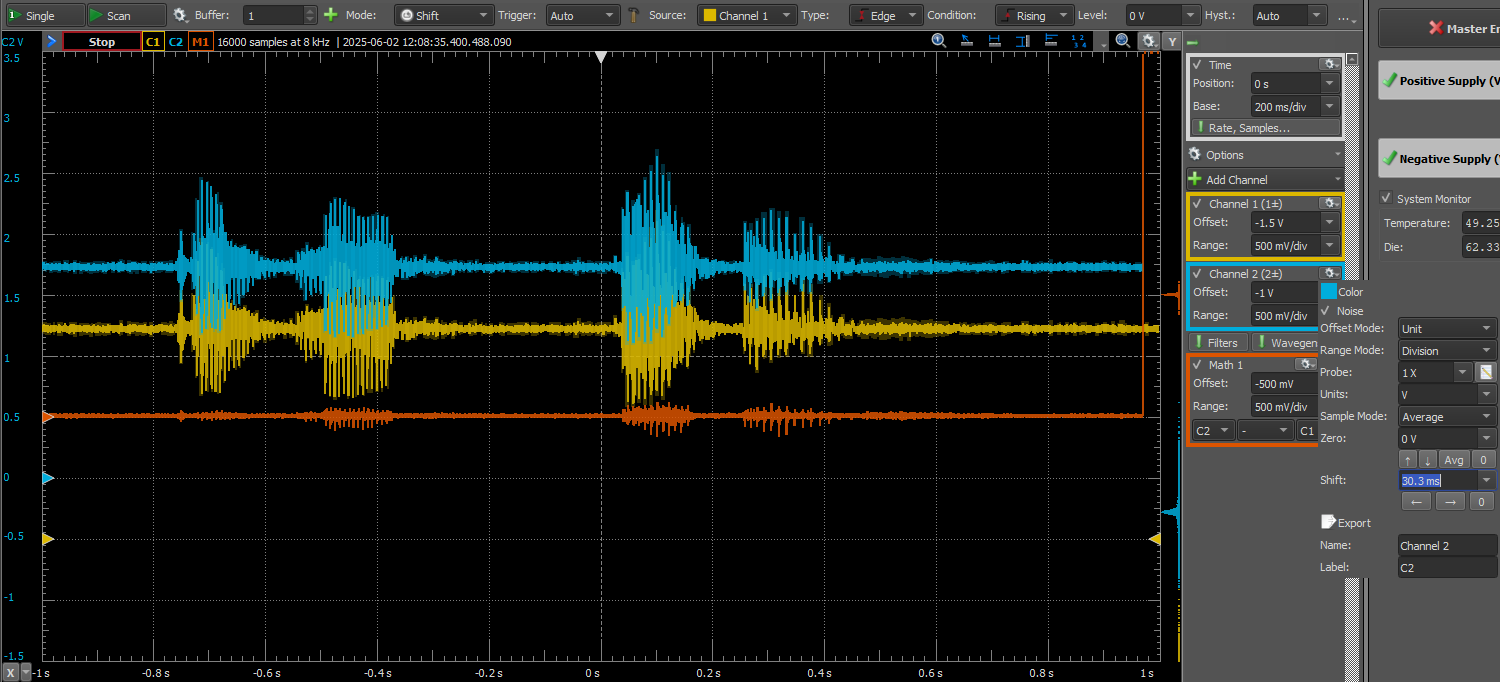
tests/algorithm/bypass-delay.png
