theodote/Senior-Project/tests/algorithm/proc-delay.png

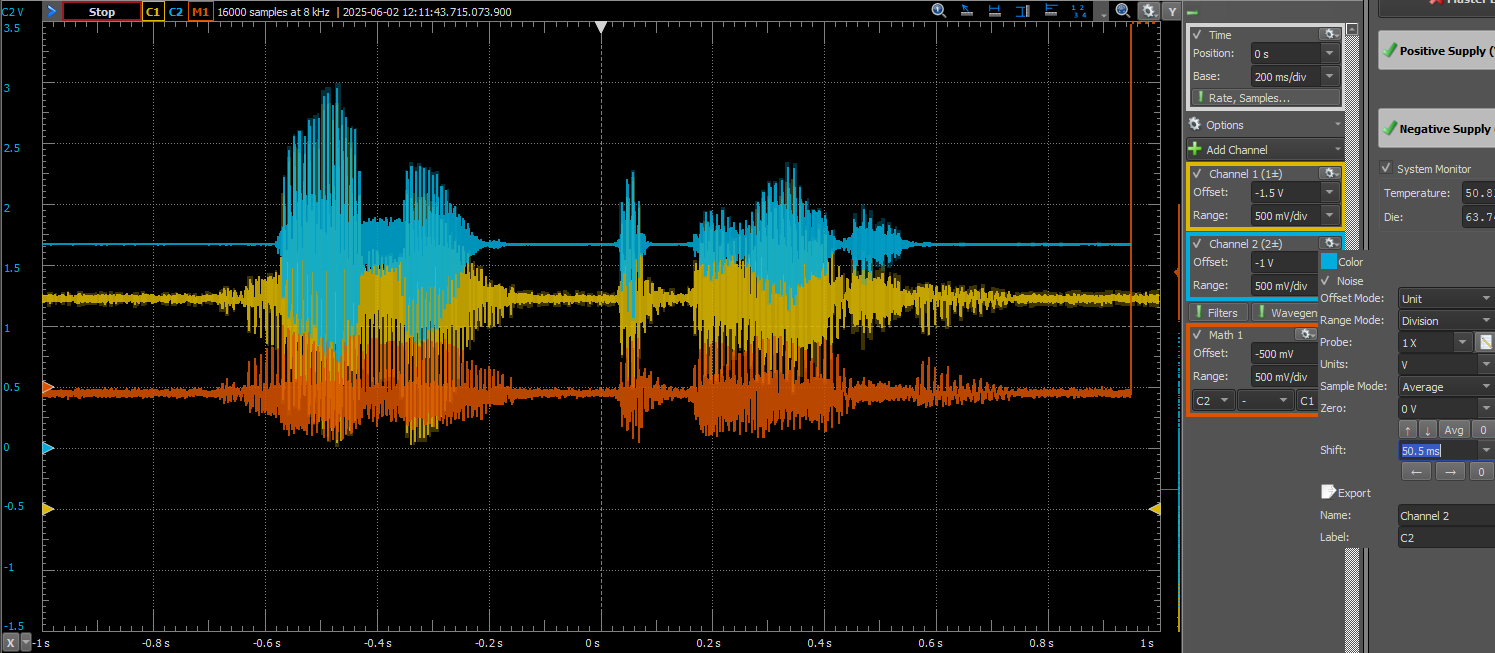
tests/algorithm/proc-delay.png
