theodote/Senior-Project/tests/pcb/adc to dac.png

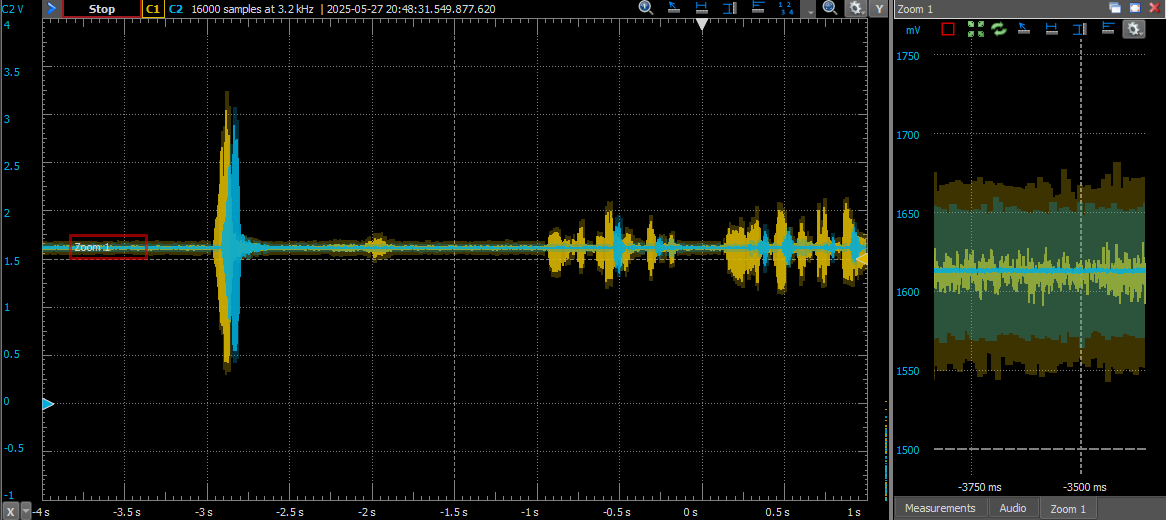
tests/pcb/adc to dac.png
