theodote/Senior-Project/tests/pcb/attenuation.png

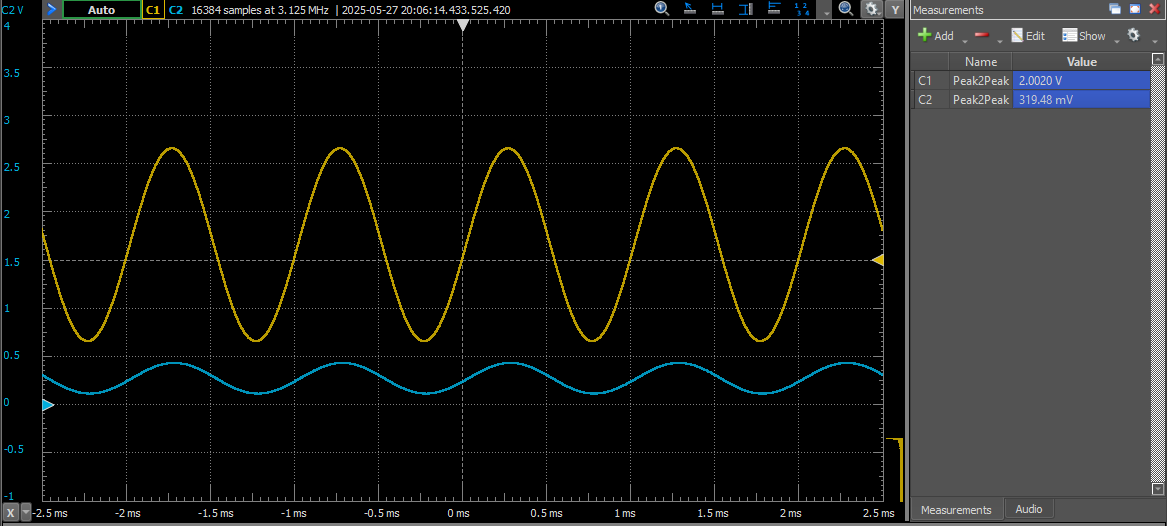
tests/pcb/attenuation.png
