theodote/Senior-Project/tests/pcb/button.png

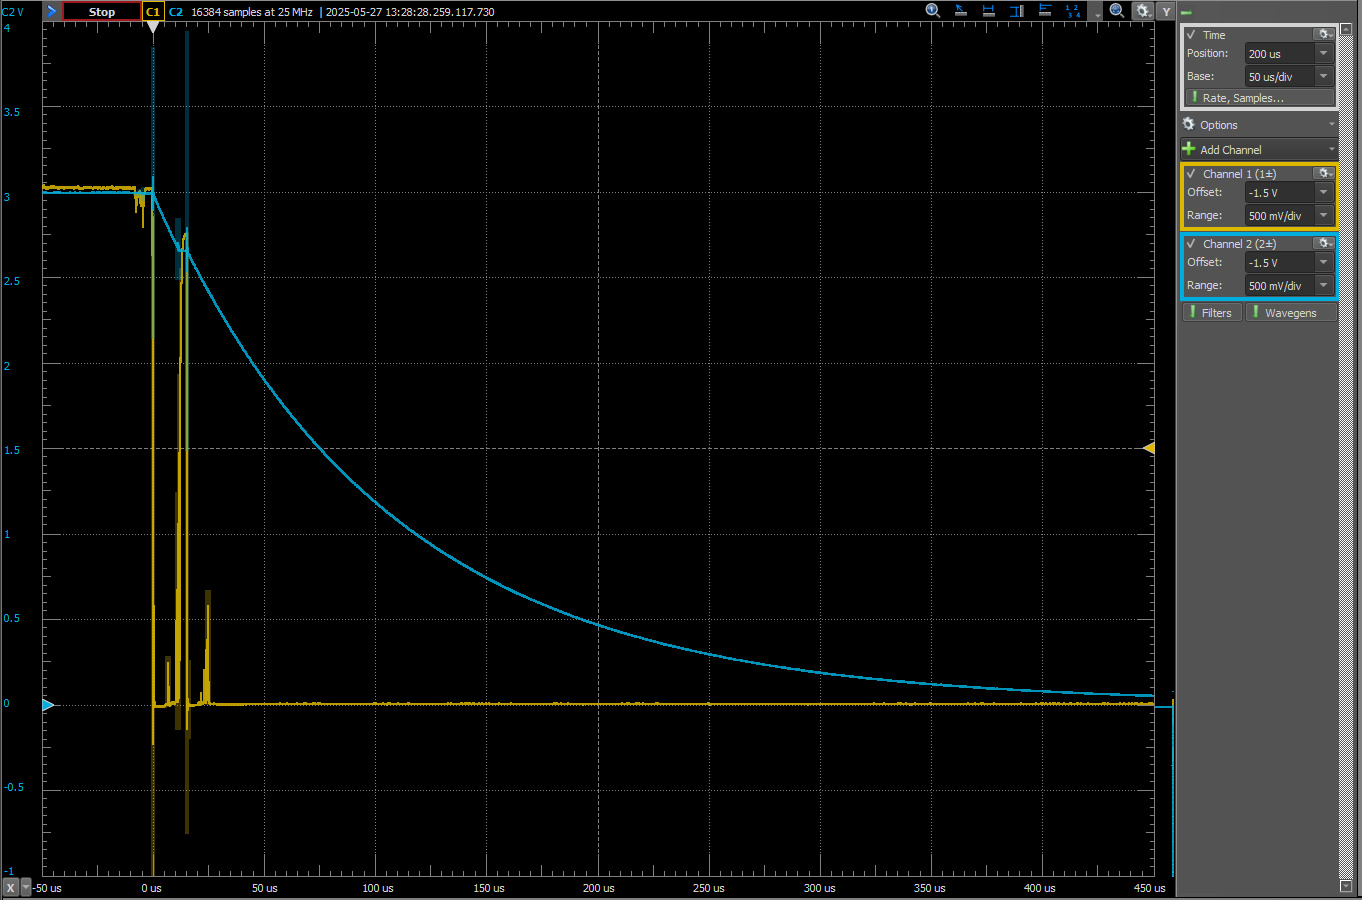
tests/pcb/button.png
