theodote/Senior-Project/tests/pcb/delay.png

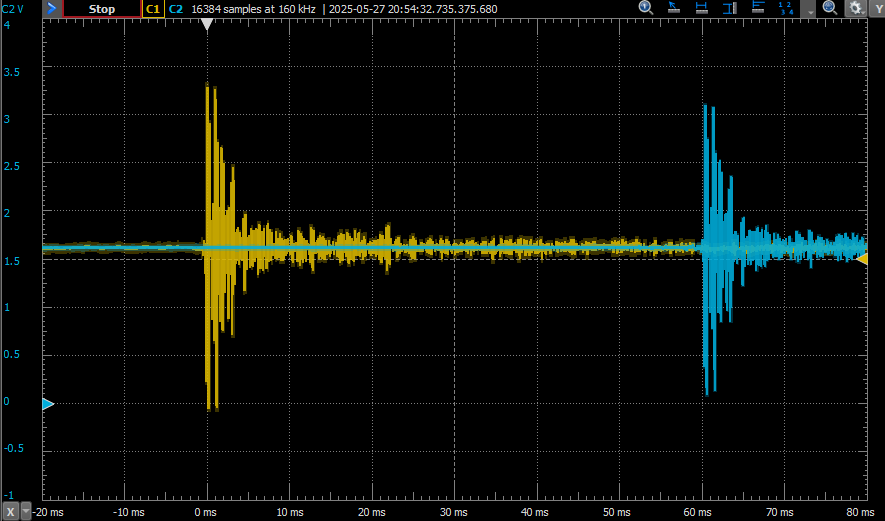
tests/pcb/delay.png
