theodote/Senior-Project/tests/pcb/follower.png

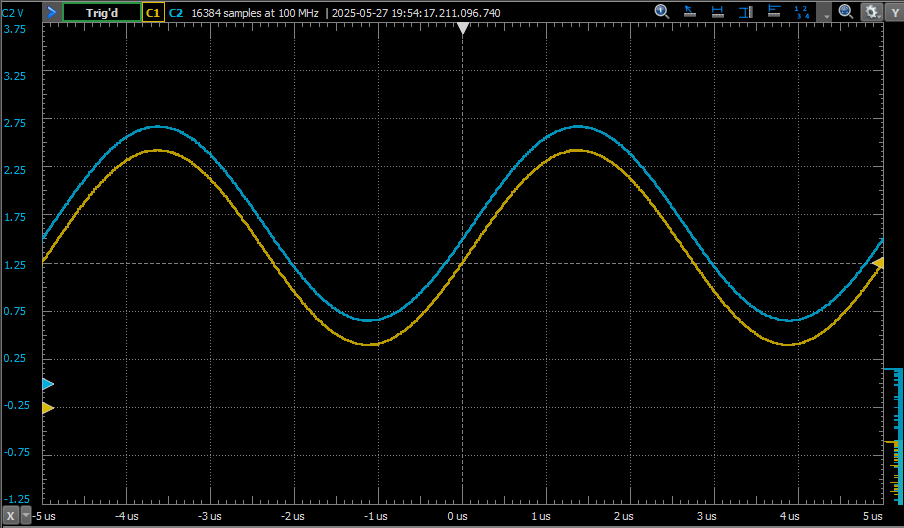
tests/pcb/follower.png
