theodote/Senior-Project/tests/pcb/in lpf.png

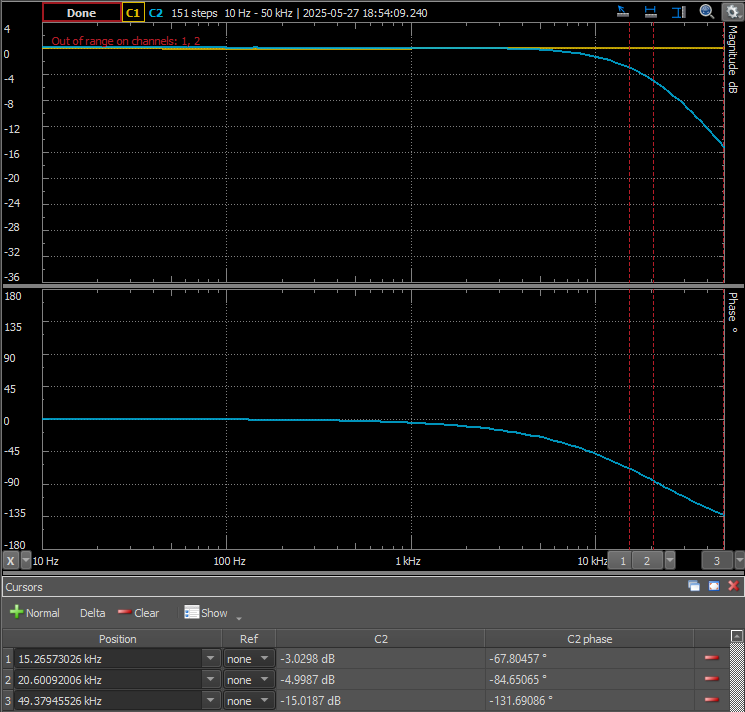
tests/pcb/in lpf.png
