theodote/Senior-Project/tests/pcb/mic fart.png

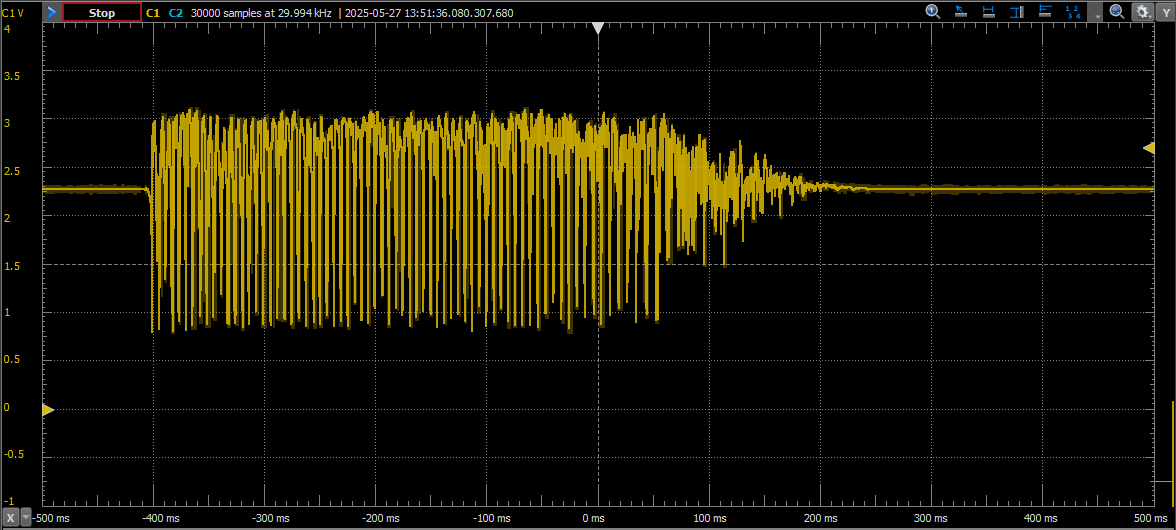
tests/pcb/mic fart.png
