theodote/Senior-Project/tests/pcb/mic whistle.png

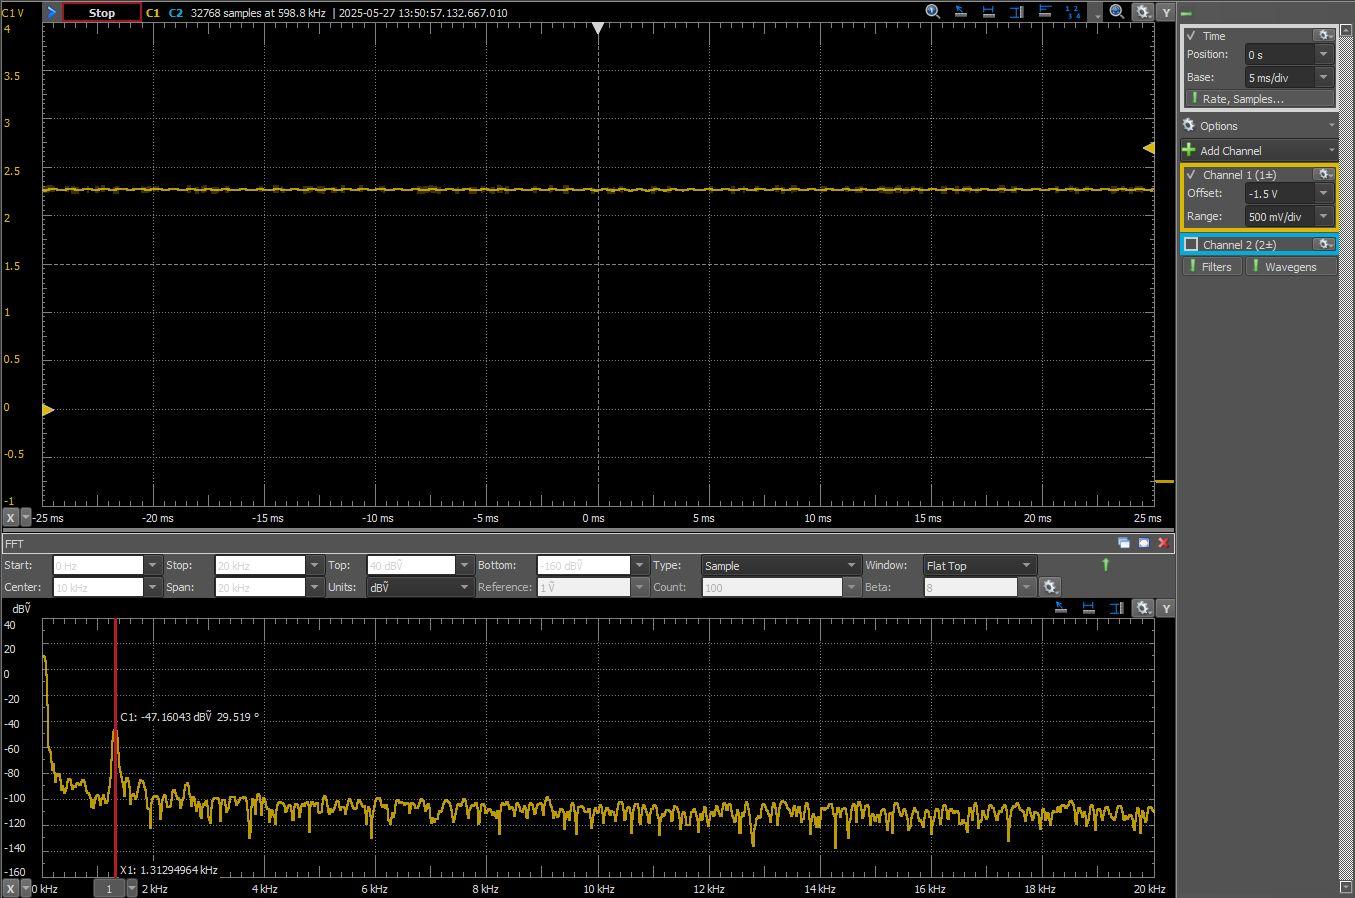
tests/pcb/mic whistle.png
