theodote/Senior-Project/tests/pcb/out lpf.png

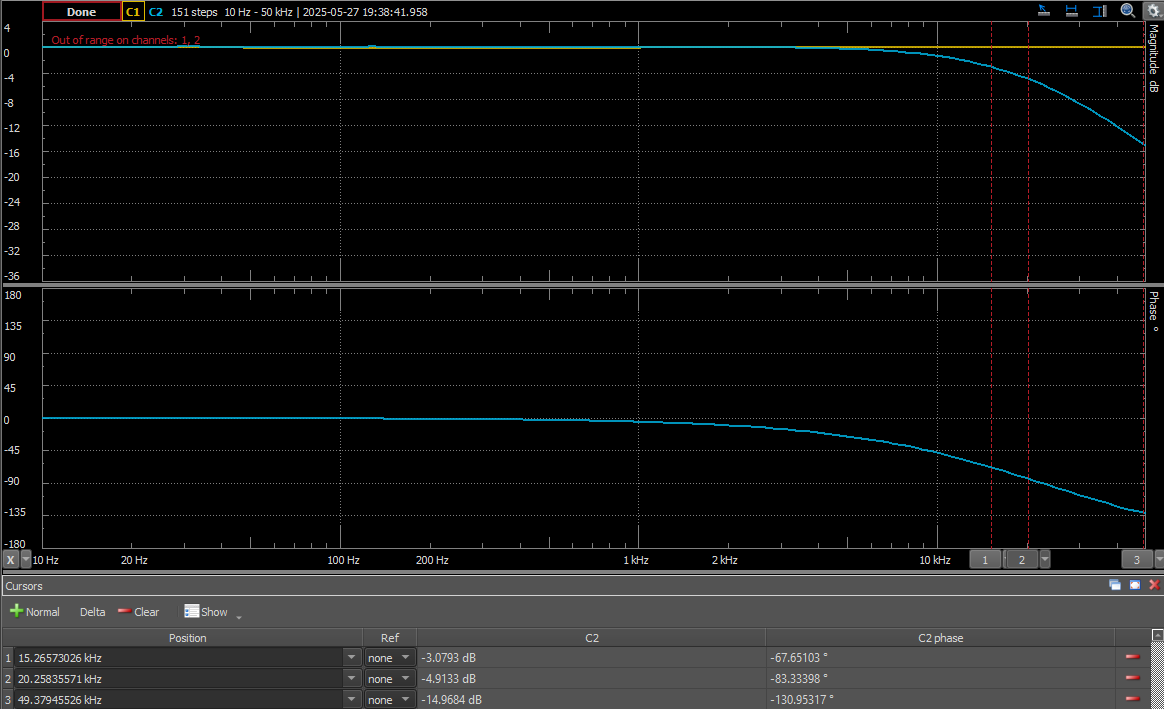
tests/pcb/out lpf.png
