theodote/Senior-Project/tests/pcb/phase a.png

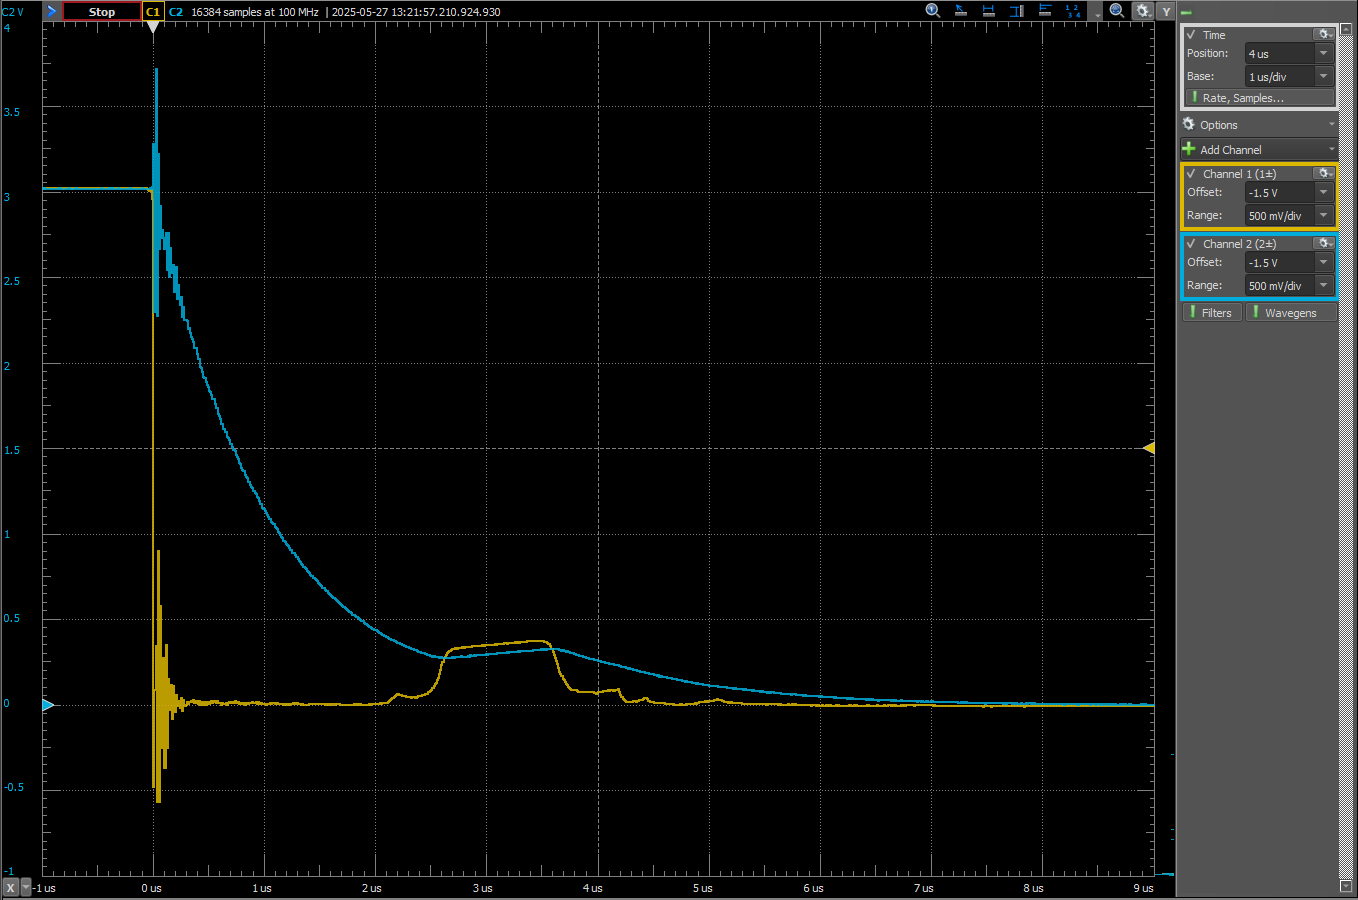
tests/pcb/phase a.png
