theodote/Senior-Project/tests/pcb/phase b.png

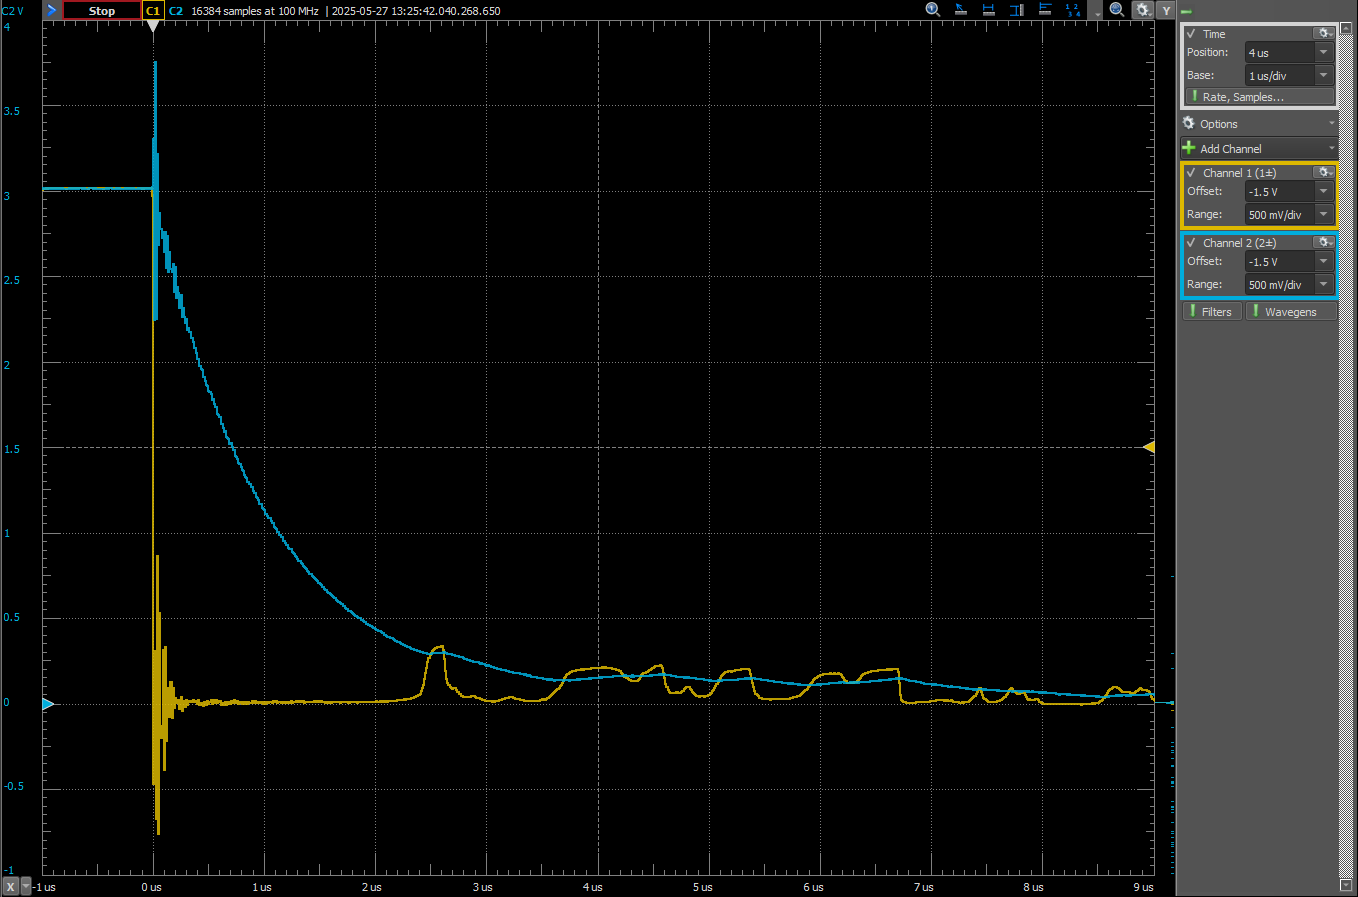
tests/pcb/phase b.png
