theodote/Senior-Project/tests/pcb/tia input overdrive.png

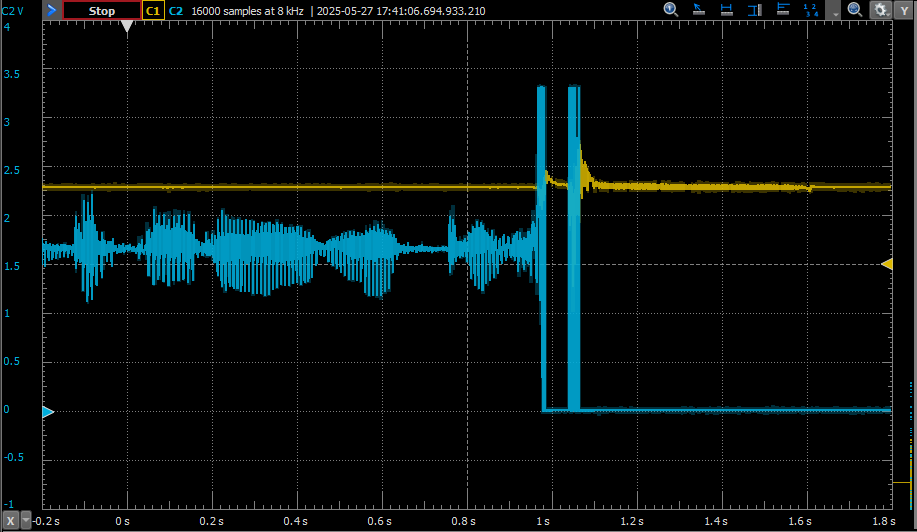
tests/pcb/tia input overdrive.png
