theodote/Senior-Project/tests/pcb/tia.png

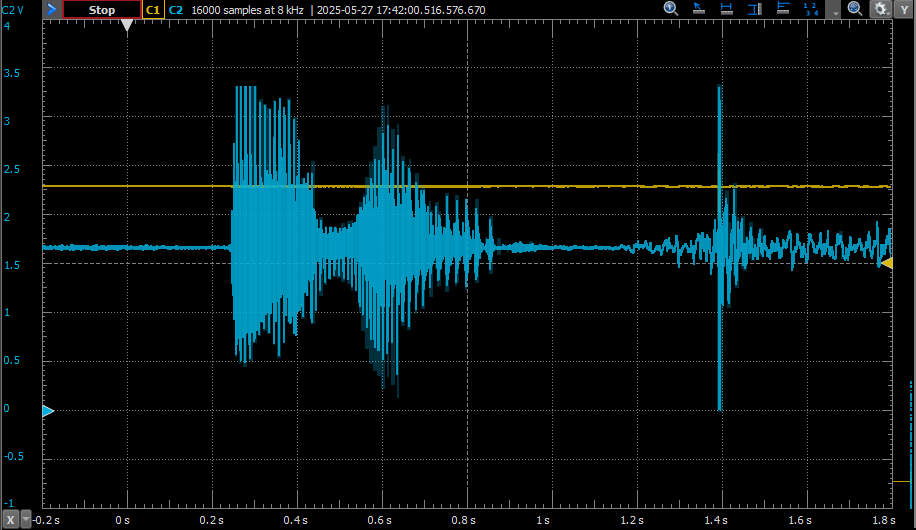
tests/pcb/tia.png
