theodote/Senior-Project/figs/debug.png

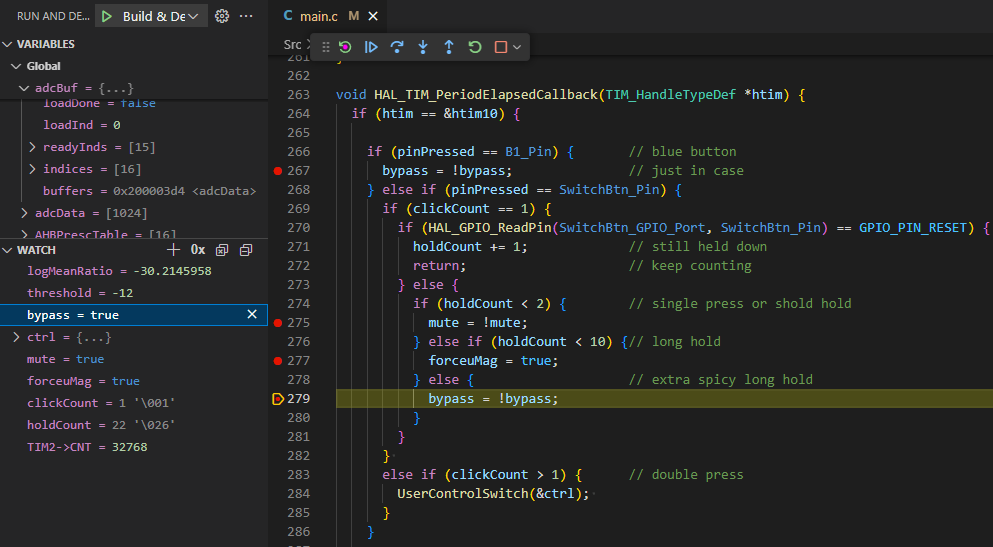
figs/debug.png
