theodote/Senior-Project/hw/pale_sieve/pale_sieve_schematic.pdf

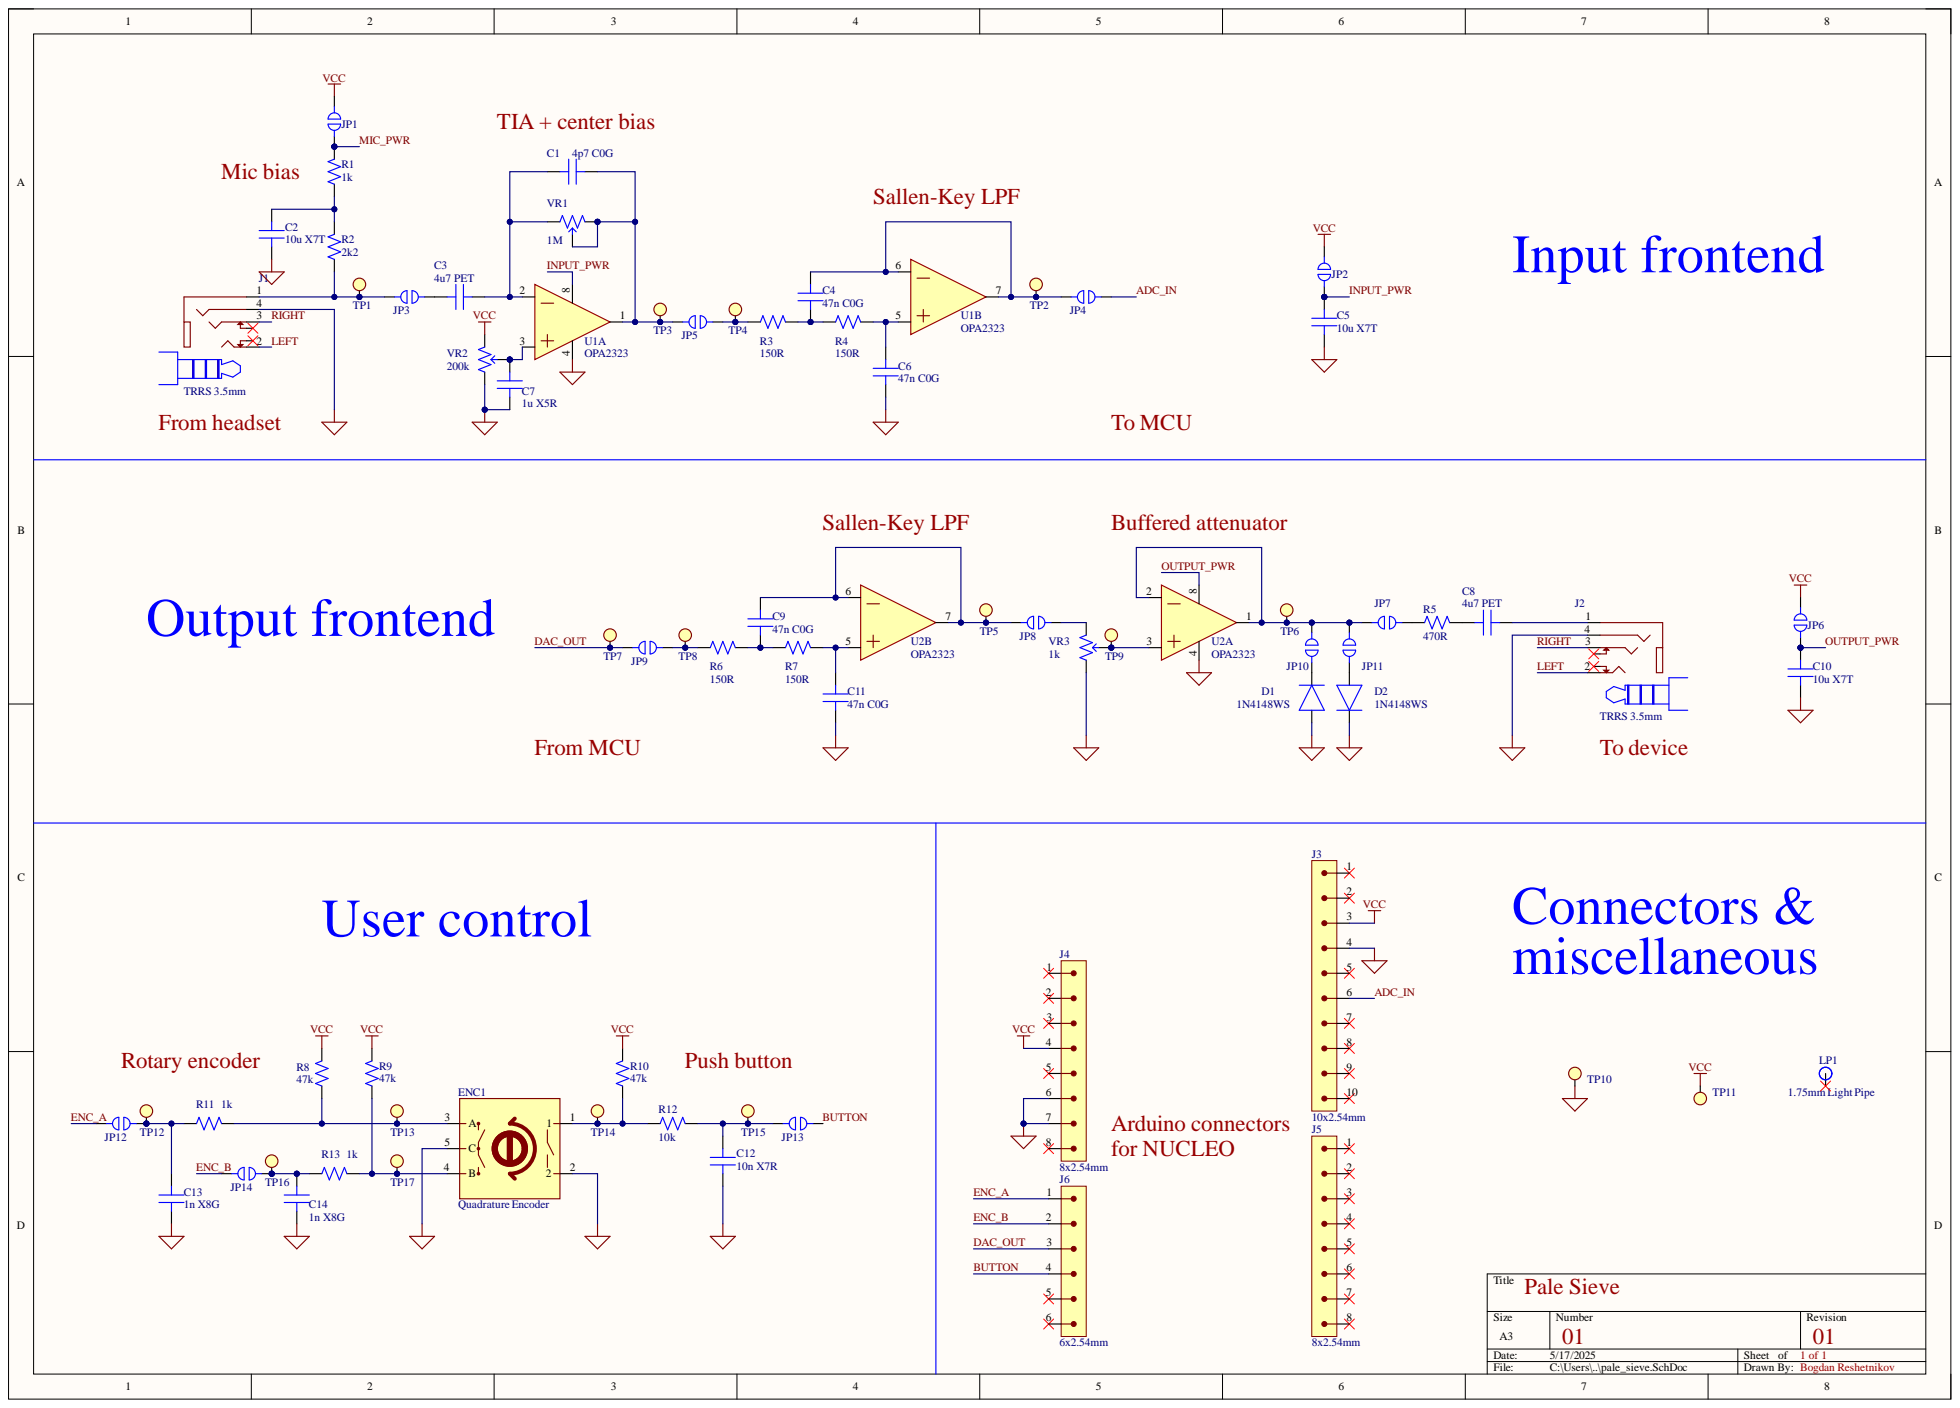
[picture p104: page 1]
