theodote/Senior-Project/hw/pale_sieve/Sheet1.pdf

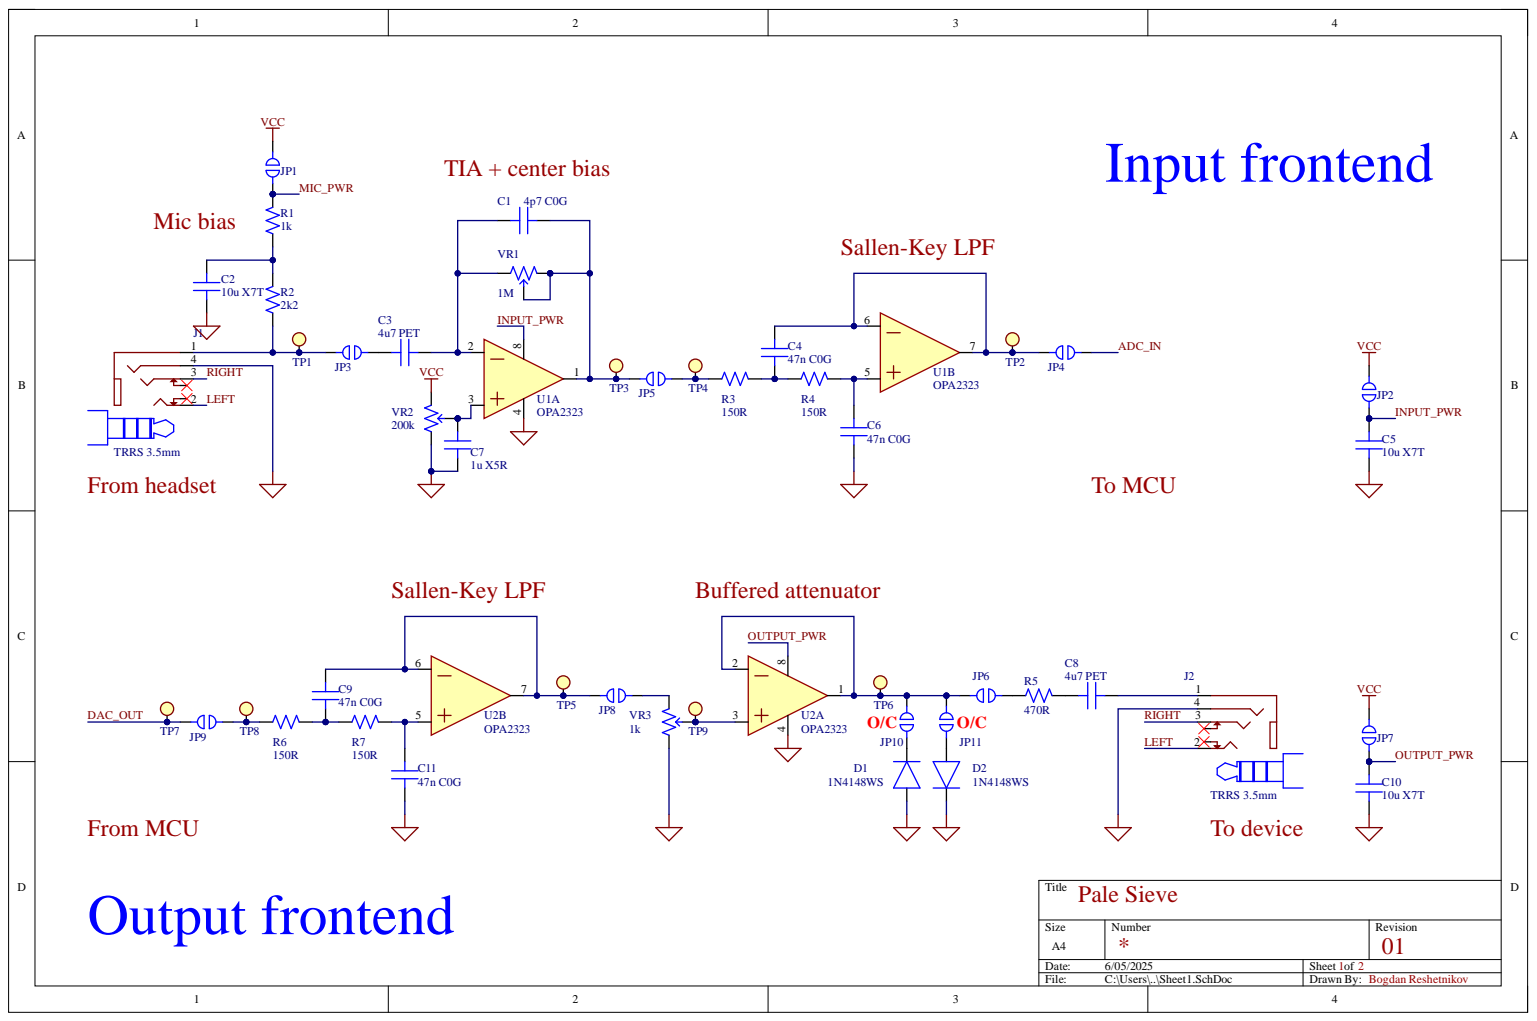
[picture p105: page 1]
