theodote/Senior-Project/hw/pale_sieve/Sheet2.pdf

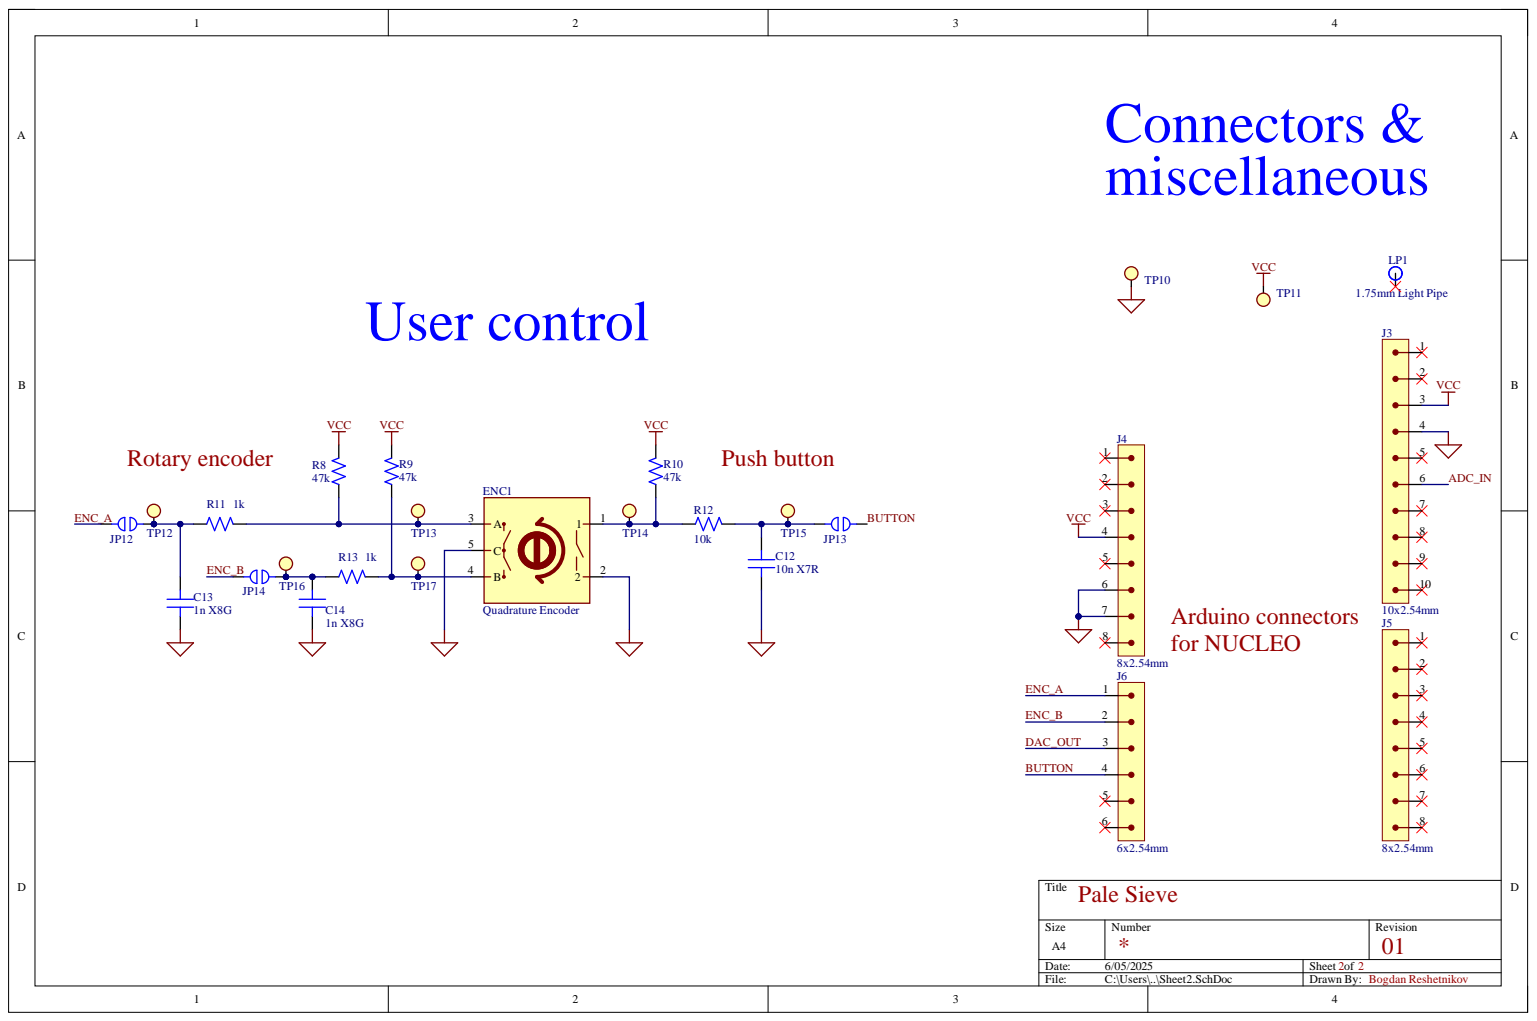
[picture p106: page 1]
