theodote/Senior-Project/(list of files, drawings)

Other design files:
hw/pale_sieve/pale_sieve.PcbDoc
hw/pale_sieve/pale_sieve.PcbLib
hw/pale_sieve/pale_sieve.PrjPcb
hw/pale_sieve/pale_sieve.SchDoc
hw/pale_sieve/pale_sieve.SchLib
hw/pale_sieve/pale_sieve_BROKE.SchLib
hw/pale_sieve/Sheet1.SchDoc
hw/pale_sieve/Sheet2.SchDoc
