theodote/Senior-Project/(commit log)

2025-05-08 transferring the app
    [ARMCA5neon_config.txt, ARMCA7neon_config.txt, ARMCA9neon_config.txt, ARMCM0_config.txt, ARMCM3_config.txt, ARMCM4_FP_config.txt, ARMCM55_FP_MVE_config.txt, ARMCM7_SP_config.txt]
2025-05-08 Some components might be hone, confirm later
    [pale_sieve.PrjPcb, pale_sieve.SchDoc, pale_sieve.SchLib, pale_sieve_BROKE.SchLib]
2025-05-08 first schematic iteration
    [pale_sieve.SchDoc, pale_sieve.SchLib]
2025-05-09 schematic, rules, stackup done
    [pale_sieve.PcbDoc, pale_sieve.PcbLib, pale_sieve.PrjPcb, pale_sieve.SchDoc, pale_sieve.SchLib]
2025-05-10 schematic + libraries done
    [1N4148WS.stp, C0805C473G3GECAUTO.stp, CRCW060347K0FKEA.stp, GCM188R71C104KA37J.stp, OPA2323IDR.stp, PEC11L-4120F-S0020.stp, SJ2-35894B-SMT-TR.stp, SMDTD04470YA00KS00.stp]
2025-05-12 laptop is dying again. emergency save
    [61300611121.stp, 61300811121.stp, 61301011121.stp, pale_sieve.PcbDoc, pale_sieve.PcbLib, pale_sieve.PrjPcb, pale_sieve.SchDoc, pale_sieve.SchLib]
2025-05-13 pcb ready and ordered!!!
    [Basket_May12_0403PM.xls, pale_sieve.PcbDoc, pale_sieve.PrjPcb, pale_sieve_BOM.xlsx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]
2025-05-19 some refactoring + diagrams
    [pale_sieve.SchDoc]
2025-05-28 I broke it beyond repair
    [app.ioc, main.c]
2025-05-28 I FIXED IT BACK! 150 was too low. ground loop issue remains forever though
    [app.ioc, main.c]
2025-06-05 IT'S DONE
    [Sheet1.SchDoc, Sheet2.SchDoc, maps.xlsx, pale_sieve_BOM.xlsx]
