theodote/Senior-Project/figs/soldering2.jpg

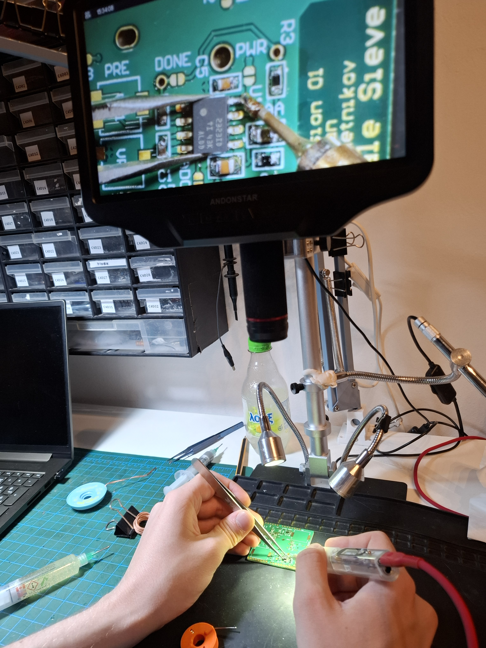
figs/soldering2.jpg
