theodote/Senior-Project/figs/soldering3.jpg

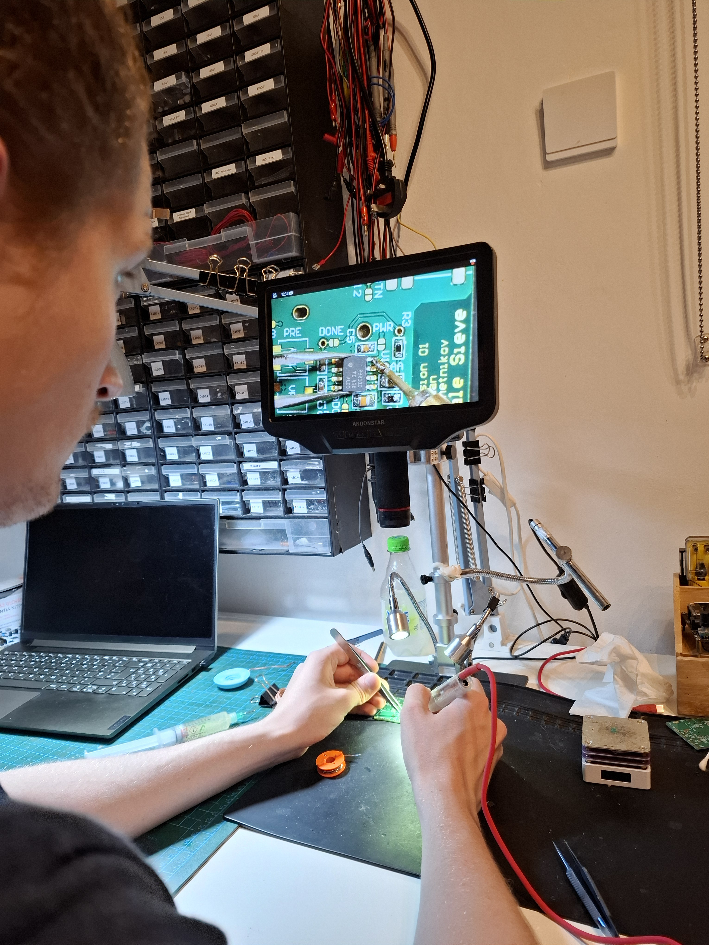
figs/soldering3.jpg
