theodote/Senior-Project/figs/soldering1.jpg

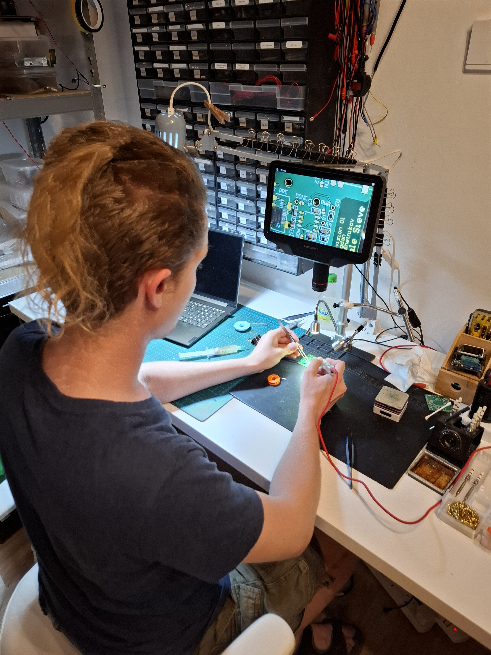
figs/soldering1.jpg
